NickHuang0228/T113-DEV-V1/docs/concepts/README.md

# 核心概念

> 這塊板的設計文件有 6,000 多行，但**真正要內化的概念只有 8 條**。
>
> 其餘都是查證結果（「PC4/PC5 是 BOOT-SEL」「ADV7511 沒有 EPAD」），
> 那些不用記，畫到那裡再翻文件就好。
>
> 這個目錄裝的是要帶走的那 8 條。

---

## 進度

| | 概念 | 狀態 | 一句話 |
|---|---|---|---|
| ① | [回流路徑](01-return-path.md) | ✅ 已懂 | 每條訊號線正下方都要有連續的銅讓電流回家 |
| ② | [阻抗控制](02-impedance.md) | ✅ 已懂 | 阻抗由線寬決定，線寬由板廠給，不連續就反射 |
| ③ | [臨界長度與等長](03-critical-length.md) | ✅ 已懂 | 看上升時間決定要不要小心；等長控的是時間，長度只是代理 |
| ④ | [差分訊號為什麼成對](04-differential.md) | ✅ 已懂 | 靠得近只看差值換來抗雜訊能力，這能力被拿去支撐小擺幅，小擺幅才跑得快 |
| ⑤ | [mux 衝突與 0Ω 隔離](05-pin-mux.md) | ✅ 已懂 | 軟體改得了「這支腳歸誰管」，改不掉「線還連著誰」 |
| ⑥ | [bank 為什麼會連坐](06-io-bank.md) | ✅ 已懂 | bank 邊界是 die 上的物理邊界；風險分配只有 pin map 階段是免費的 |
| ⑦ | [上電時序](07-power-sequence.md) | ✅ 已懂 | 別在電源域還沒準備好時送訊號進去；後果多半是開不了機而非燒毀 |
| ⑧ | [去耦電容在做什麼](08-decoupling.md) | ✅ 已懂 | 本地電荷水庫；位置比容值重要，回流路徑跟供電路徑一樣重要 |

---

## 八條怎麼串起來

不是八個獨立主題，是兩條主線加一組系統規則：

```
【電磁主線】訊號在銅線上會發生什麼
  ① 回流路徑      電流要回家 —— 一切的根基
  ② 阻抗控制      同一個結構，訊號感受到多大阻力
  ③ 臨界長度      什麼時候需要在意 ①②
  ④ 差分          為什麼高速一律成對

【電源主線】電要怎麼送到晶片
  ⑦ 上電時序      電源之間的先後
  ⑧ 去耦電容      ★ 又回到 ① —— 供電也是一個電流迴路

【系統規則】晶片的腳怎麼分配
  ⑤ mux 衝突      軟體改不掉「線還連著誰」
  ⑥ bank 連坐     災損邊界是物理邊界
```

**① 出現三次**：訊號的回流、差分的共模回流、去耦的供電迴路。
如果只能記一條，記它。

**⑤⑥ 共用一個時機**：兩者都只有在 **pin map 階段**改動才免費。

---

## 讀法

一次一條，讀完能用自己的話講出那條「一句話」就算過。

**不用一口氣讀完。** 這 8 條會在畫原理圖和 layout 時反覆用到，
遇到不確定的地方回來翻，比一次背完有效。

---

## 這些概念為什麼重要

它們是「判斷方法」，不是「查證結果」：

```
查證結果   換一顆晶片就作廢
判斷方法   換十顆晶片都還在用
```

這塊板的目的是累積 layout 能力，而能力就長在這 8 條上面。
把它們搞懂，下一塊板（DP 探測板、SSD2832 板）可以直接沿用。
