NickHuang0228/T113-DEV-V1/docs/design/011-power-tree.md

# 011 · 電源樹定案

版本：v0.2 · 2026-09-26（AVCC/HPVCC 改由 LDOA 供電；§8 待辦結案）

本文件把 [001-power.md](001-power.md) 的分析收斂成**可以直接畫原理圖的數字**：
每條軌的來源、元件料號、分壓值、時序電路、去耦。

---

## 1. 電源樹

```
Type-C VBUS  +5V_VBUS
  │
  ├─ RY1303 CH3 ──▶ +3V3        VCC-IO · VCC-PD · VCC-PE · VCC-PG · VCC-TVOUT
  │                              LDO-IN · RTL8201F · CH340N · ADV7511 MVDD
  │                              兩顆 1.8V LDO 的輸入 · 上拉與 LED
  │
  ├─ RY1303 CH2 ──▶ +1V5        VCC-DRAM0/1
  │
  ├─ RY1303 CH1 ──▶ +0V9        VDD-CORE0/1 · VDD-SYS0/1/2
  │
  ├─ +3V3 ─[LDO1]─▶ +1V8_SOC    VCC-PLL · VCC-RTC · VCC-LVDS · VCC-TVIN
  │                              VDD18-DRAM
  │
  ├─ +3V3 ─[T113 內建 LDOA]─▶ +1V8_AUDIO   AVCC · HPVCC（v0.2，見 §3.1）
  │
  ├─ +3V3 ─[LDO2]─▶ +1V8_HDMI   ADV7511 專屬，再分 3 組（見 §5）
  │                    ├─[10µH+10µF]─▶ +1V8_DVDD    pin 1,19,49,76,77
  │                    ├─[10µH+10µF]─▶ +1V8_AVDD    pin 29,34,41 + 24,25
  │                    └─[10µH+10µF]─▶ +1V8_PLVDD   pin 21 + 26
  │
  └─ +5V_VBUS ─[TPS2051B]─▶ +5V_USB   USB-A Host（限流）
```

### 1.1 Net 命名

```
+5V_VBUS · +5V_USB · +5V_HDMI
+3V3
+1V8_SOC · +1V8_AUDIO · +1V8_HDMI · +1V8_DVDD · +1V8_AVDD · +1V8_PLVDD
+1V5 · +0V9
GND
```

⚠ **+5V_HDMI 是 HDMI 座上的 +5V（DDC 上拉用），與 +5V_VBUS 分開命名** ——
它接到外部螢幕，要獨立看待。

⚠ **+1V8_AUDIO 不叫 +1V8_AVCC** —— 和 ADV7511 的 +1V8_AVDD 只差一個字母，畫圖時太容易接錯。

---

## 2. RY1303 三路 DC-DC

`(RY1303 Datasheet **V1.9**，2026-09-30 對原文重核)`

⚠ **本節數字已全面改依 V1.9。** 原本標註的來源是 V1.0.x，多處與 V1.9 不同
（切換頻率、EN 閾值、UVLO、限流、θJA、FB 容差）。**若手上的 PDF 是舊版，以 V1.9 為準。**

```
LCSC C370881 · QFN20-3×3 · 庫存 23,969 · $0.20
Vin          2.7 ~ 5.5 V     ⚠ Feature 頁寫 2.7，Electrical Char. 與訂購資訊寫 2.5；取保守值
VCC (pin16)  2.5 ~ 5.5 V     ★ 內部控制電路電源，不是 NC
每通道電流    0 ~ 2 A
⚠ 三通道總輸出功率必須 < 6 W
FB 電壓      0.588 / 0.600 / 0.612 V   (±2%)      ← 原寫 ±2.5%
切換頻率      1 / 1.5 / 2 MHz  (min/typ/max)      ← 原寫「1.2 MHz 固定」
EN 閾值      VEN-H min 2 V / VEN-L max 0.4 V     ← 原寫 1.2 V / 0.6 V
UVLO         1.9 / 2.3 / 2.5 V (VIN rising)，遲滯 0.3 V
上管電流限制   ILIM-P min 3.5 A / typ 5 A          ← 原寫 3 A
熱關斷        165 °C typ，遲滯 30 °C
θJA          50 °C/W    θJC 7.5 °C/W   PDmax@25°C 2.5 W   ← 原寫 43.7
Tj max       150 °C
pin 21       EP，"must be soldered to a large PCB copper plane and connected to GND"
```

### 2.1 ⚠ 更正 001-power.md 的一個錯誤

001-power.md §2.3 的比較表寫 RY1303 的優點是「**EN1/EN2/EN3 內建順序**」。

**錯的。** datasheet 寫的是：

```
"the independent enable control makes the designer have the greatest flexibility
 to optimize timing for power sequencing purposes"
```

**EN 是三支獨立輸入，沒有任何內建順序。** 時序要自己做（見 §4）。

> 這條錯誤的來源是把「有三支 EN 腳」當成「有排序功能」。
> **零件的彈性不等於零件幫你做事。**

### 2.2 腳位

```
1  GND3     2  FB3      3  FB2      4  GNDA     5  GNDB
6  SW2      7  VIN2     8  EN2      9  EN1     10  VIN1
11 SW1     12  GND1A   13  GND1B   14  FB1     15  AGNDA
16 VCC       17  AGNDB   18  EN3     19  VIN3    20  SW3
21 EP（GND）
```

⚠ **EN 腳不可浮接**（datasheet 明寫 "Don't leave this pin floating"）。

⚠ **pin 16 是 VCC 不是 NC**（2026-09-30 對 DS V1.9 原文重核時發現）。

```
16  VCC   "Input supply pin for internal control circuit."   2.5 ~ 5.5 V
```

**內部控制電路的電源，必須接 +5V_VBUS。** 懸空 = 控制電路沒電 = 整顆 IC 不工作。
p.3 Absolute Max 也把 `V_VCC` 與三個 `V_VIN` 並列為輸入電源，印證它是電源腳。

`gen_power_symbols.py` 原本標成 `NC / no_connect`，已於同日更正並重生符號。
另 pin 4/5 原文是 `GND2A / GND2B`（符號裡寫 GNDA/GNDB，功能相同）。

### 2.3 分壓電阻（用公式算，不抄）

```
V_out = 0.6 × (1 + R_top / R_bot)      R_bot 統一用 51.0 K 1%
```

| 軌 | R_top | R_bot | 算出 V_out | 晶片容許範圍 | |
|---|---|---|---|---|---|
| **+3V3** | **232 K** | 51.0 K | 0.6×(1+4.5490) = **3.329 V** | VCC-IO 2.97 ~ 3.63 | ✓ |
| **+1V5** | **76.8 K** | 51.0 K | 0.6×(1+1.5059) = **1.504 V** | VCC-DRAM 1.425 ~ 1.575 | ✓ |
| **+0V9** | **25.5 K** | 51.0 K | 0.6×(1+0.5000) = **0.900 V** | VDD-CORE TBD（標稱 0.9） | ✓ |

三個 R_top 都是 **E96 1%** 的現成值（232K / 76.8K / 25.5K）。

#### 含容差的最壞情況

FB 本身 **±2%**（V1.9：0.588 / 0.600 / 0.612），加上電阻 1%，合計約 ±3%：

```
+3V3   3.23 ~ 3.43 V     VCC-IO 2.97~3.63       ✓ 兩側都有餘裕
+1V5   1.459 ~ 1.549 V   VCC-DRAM 1.425~1.575   ✓ 餘裕 26 mV，仍是最緊的一條
+0V9   0.873 ~ 0.927 V   標稱 0.9（DS 未給 min/max）
```

⚠ 2026-09-30 更正：原本用 FB ±2.5% 算得合計 ±3.5%。V1.9 的 VREF 是 ±2%，
**合計降到 ±3%，三條軌的餘裕都變大**（+1V5 從 ~25 mV 邊界變成兩側各 26/34 mV）。

⚠ **+1V5 仍是三條裡容差最緊的** —— DDR3 的 ±5% 大半被 FB 容差吃掉。
bring-up 時這條要優先量。

```
[ ] 若量到偏離超過 2%，考慮把 R_bot 改 0.5% 或微調 R_top
```

### 2.4 電感與電容

照 datasheet 典型應用電路：

```
CH3 (+3V3)   L = 2.2 µH      C_out = 22 µF
CH2 (+1V5)   L = 1.5 µH      C_out = 22 µF
CH1 (+0V9)   L = 1.0 µH      C_out = 22 µF
每個 VIN     C_in = 10 µF MLCC，緊貼該通道的 VIN 腳
```

⚠ **DC bias**：22 µF X7R 0805 在 3.3V 偏壓下實際約 17.6 µF（掉 20%）。
1.5V / 0.9V 軌偏壓低，衰減較小。**選料時要看 DC bias 曲線，不能只看標稱值。**

#### 電感選型（2026-09-26 定案）

漣波 ΔI = V_out × (1 − V_out/V_in) / (L × f)，取 V_in = 5.25 V（最壞）、**f = 1 MHz（最壞）**：

⚠ 2026-09-30 更正：原本用 f = 1.2 MHz，但 DS V1.9 Electrical Characteristics 給的是
`FSW min 1 MHz / typ 1.5 MHz / max 2 MHz`。**f 在分母，最壞情況要取 min。**
下表已改用 1 MHz 重算（括號內為原本 1.2 MHz 的值）。

| 通道 | L | ΔI | 峰值 @估計負載 | 峰值 @2 A 滿載 |
|---|---|---|---|---|
| +3V3 | 2.2 µH | **0.55 A**（原 0.46） | 1.05 A | 2.23 A |
| +1V5 | 1.5 µH | **0.72 A**（原 0.60） | 0.60 A | 2.30 A |
| +0V9 | 1.0 µH | **0.74 A**（原 0.62） | 1.31 A | 2.31 A |

ΔI 為滿載的 28~37%（原估 23~31%）。略高於教科書建議的 30% 上限，但仍可接受 ——
而且這是 f 取 min 的最壞值，典型 1.5 MHz 下只有 0.37~0.49 A（19~25%）。

**Isat 直接照 RY1303 的上管限流選，不照負載選**
（⚠ 2026-09-30 更正：限流規格是 `ILIM-P min 3.5 A / typ 5 A`，原文寫 3 A 有誤。
所選的 6.0~8.7 A 對 5 A typ 仍有餘裕，選型不變。） —— 短路或過載時電流會頂到限流點，
電感若先飽和，電流上升斜率暴增，限流比較器來不及反應。4×4 一體成型電感做得到，每顆只貴約 1 美分。

| 軌 | LCSC | 型號 | 尺寸 | Isat（−30% L） | DCR max | 庫存（09-26） |
|---|---|---|---|---|---|---|
| +0V9 | `C602028` | cjiang FHD4020S-1R0MT | 4×4×2.0 | 8.7 A | 28 mΩ | 10,398 |
| +1V5 | `C843298` | cjiang FHD4020S-1R5MT | 4×4×2.0 | 7.7 A | 38 mΩ | ⚠ 2,895 |
| +3V3 | `C602029` | cjiang FHD4020S-2R2MT | 4×4×2.0 | 6.0 A | 56 mΩ | 117,751 |

同一系列、同一個 footprint，皆 Extended（找不到 Basic 的功率電感），單價約 $0.07。
數值已對原廠 datasheet；庫存與價格為 JLCPCB 2026-09-26 查詢值。

```
⚠ 1.5 µH 庫存偏少。備案：
   (a) 改用 1.0 µH C602028 —— ΔI 升到約 0.9 A，仍可接受
   (b) Sunlord WPN4020H1R5MT C98360 —— 數字只看過 JLCPCB 頁面，未對 datasheet
參考：MangoPi 三路全用 2.2 µH。
```

#### 輸出電容

```
22 µF  C45783  Samsung CL21A226MAQNNNE  0805 25V X5R  Basic
⚠ 原廠 spec 沒附 DC-bias 曲線。依同級 0805 X5R 估，3.3 V 下剩約 11~13 µF（−40~50%）
   → +3V3 放兩顆 22 µF；+1V5 / +0V9 各一顆
⚠ 輸出電容不要無限堆 —— 太大時軟啟動 1 ms 內可能充不到設定值
```

### 2.5 ⚠ 6 W 總功率上限的帳

```
+3V3   約 0.82 A × 3.3 V = 2.71 W    ← 最壞情況（GPIO 全速翻轉）
+1V5   估 0.30 A × 1.5 V = 0.45 W    ⚠ VCC-DRAM 電流 datasheet 是 TBD
+0V9   估 1.00 A × 0.9 V = 0.90 W    ⚠ VDD-CORE 電流 datasheet 是 TBD
                          ─────────
                          約 4.06 W   < 6 W  ✓
```

**餘裕約 32%，但兩項是估值。** 實際 GPIO 不會同時全速翻轉，真實值會低不少。

**TBD 兩項的旁證**（DS Table 5-3 p.47 原頁確認仍是 TBD，沒有更新版數字）：
Forlinx T113-i 核心板（外接 512 MB DDR3 + 8 GB eMMC）在 Linux 下
**CPU + 記憶體 + eMMC 壓力測試，整片核心板 5 V 輸入端 1.05 W**。
本表 +0V9 與 +1V5 合計估 1.35 W（輸出端），已高於該實測整板值 → **估值偏保守，6 W 帳成立**。
`(forlinx.net/industrial-news/allwinner-t113-som-performance-528.html)`

```
[ ] bring-up 時量三軌實際電流，回填本表
```

---

## 3. 兩顆 1.8V LDO

| | LDO1（SoC 側） | LDO2（ADV7511 專屬） |
|---|---|---|
| 料號 | **AP2112K-1.8TRG1** | **AP2112K-1.8TRG1** |
| LCSC | `C176944` | `C176944` |
| 封裝 | SOT-25 | SOT-25 |
| 輸入 | +3V3 | +3V3 |
| 輸出 | +1V8_SOC | +1V8_HDMI |
| 負載 | 約 52 mA + TBD（AVCC/HPVCC 已移出） | 約 180 mA |
| 壓降功耗 | (3.3−1.8)×0.10 ≈ 0.15 W → ΔT ≈ 28°C | (3.3−1.8)×0.18 ≈ 0.27 W → ΔT ≈ 50°C |

**兩顆用同一個料號** —— 省一個 BOM 品項，且 600 mA 對兩邊都有餘裕。

`(AP2112 Datasheet DS39724 Rev.2-2, June 2017, p.2 / p.3 / p.5)`

```
C_in / C_out   1 µF 陶瓷，X5R 或 X7R（Note 4）          ← 原本的慣例值，確認正確
精度           ±1.5%（25°C, 1~30 mA）+ 溫漂 ±100 ppm/°C
壓降           700 mV max（1.8V 版）→ 3.21 V 輸入仍有 1.4 V 餘裕
θJA            184 °C/W（SOT-25）                        ← 原本估 250，偏保守
EN             內建 3 MΩ 下拉，VIH 1.5~6.0 V → 直接接 VIN
啟動時間        20 µs（無負載）
PSRR           65 dB @100 Hz / 1 kHz，高頻沒給 → §5 的 LC 不能省
```

⚠ **±1.5% 不夠 AVCC / HPVCC 用** —— Table 5-2 要求 1.782~1.818 V（±1%）。這是 v0.2 改架構的原因，見 §3.1。

⚠ **為什麼不共用一顆**：ADI §6.8 要求 ADV7511 有自己專屬的 1.8V LDO。
理由是 Figure 24 —— AVDD/PLVDD 在 200 kHz~1 MHz 只容許 1.3 mV rms，
共用的話 SoC 側的負載跳變會打進這個頻段。詳見 001-power.md §1.2。

### 3.1 內建 LDOA 專供音訊類比；LDOB 不使用（v0.2 改）

```
pin 29  LDO-IN     ← +3V3，2.2 µF 到地
pin 28  LDOA-OUT   → +1V8_AUDIO，2.2 µF 到地      ★ v0.2：只接 AVCC · HPVCC
pin 30  LDOB-OUT   → 2.2 µF 到地，不接任何電源軌
```

**v0.1 的做法**：LDOA 不用，1.8V 全部由外部 LDO1 供。

**為什麼改**：原頁目視核對 Table 5-2（DS p.45~46）時發現

```
AVCC       1.782 / 1.8 / 1.818 V     ±1%
HPVCC      1.782 / 1.8 / 1.818 V     ±1%
LDOA-OUT   1.782 / 1.8 / 1.818 V     ← 範圍一模一樣
```

AP2112K 初始精度 ±1.5% 再加溫漂，**保證不了 ±1%**。而 LDOA-OUT 的規格範圍與 AVCC 完全相同 ——
原廠的意圖就是 LDOA 供 AVCC。

**v0.1 當初不用 LDOA 的兩個理由，對這個接法都不成立：**

| v0.1 的顧慮 | 現在 |
|---|---|
| 兩個穩壓器並聯打架 | LDOA 只驅動 +1V8_AUDIO 一條 net，與 +1V8_SOC 完全分開，沒有並聯 |
| LDOA 只有 260 mA，負載有 TBD 項 | 只剩 AVCC + HPVCC；本板音訊只做 line-out，負載遠低於 260 mA |

**附帶好處**：數位 1.8V（PLL、DRAM 控制器）的雜訊不會進音訊類比。
MangoPi 用一顆獨立的 XC6206（±2%）做同一件事；我們用內建 LDOA，零元件、精度還更好。

```
⚠ +1V8_AUDIO 與 +1V8_SOC 絕對不可相連 —— 連了就回到兩顆並聯的問題
   v0.1 那顆「LDOA-OUT ↔ +1V8_SOC 的 DNP 0Ω」取消
⚠ VCC-TVIN 維持在 +1V8_SOC（本板不用 CVBS 輸入，精度要求 TBD）
```

---

## 4. 上電時序電路

### 4.1 datasheet 的實際要求（文字，不是圖）

`(DS §5.12.1, p.73)`

```
• 下一步要等前一步穩定在標稱值的 90~110% 才開始
• VCC-RTC must be ramped no later than other power rails
• VCC-IO must be ramped before VDD-SYS and VDD-CORE with a minimum delay of 2 ms
• VCC-DRAM needs be stable before SDRAM driver initialization
• RESET 全程拉低，直到所有電源軌（24MHz 除外）穩定超過 64 ms
• 24 MHz 在 RESET 釋放後才開始振盪
```

⚠ **文字比 Figure 5-28 寬鬆。** 圖上 VCC-DRAM 畫在第一群組（T1 之前），
但文字只要求它「在 SDRAM driver 初始化前穩定」——**那是軟體層，不是硬體順序約束。**

**只看圖會多綁一條不存在的限制。** 圖是 example，文字才是 requirement。

### 4.2 實作

```
EN3 (+3V3) ──┬── +5V_VBUS      直接接，靠 RY1303 自己的 UVLO(2.5V) 把關
EN2 (+1V5) ──┘                  與 3.3V 同時啟動（無硬體順序要求）

EN1 (+0V9) ──[47 K]── +3V3
                 │
               [220 nF]
                 │
                GND
```

延遲驗算：

```
τ = 47 K × 220 nF = 10.34 ms
EN 上升閾值 2 V（VEN-H min），從 3.3 V 充電：
t = −τ × ln(1 − 2/3.3) = −10.34 × ln(0.3939) = 9.63 ms

T1 = 9.63 ms  >  2 ms  ✓  餘裕 4.8 倍

⚠ 2026-09-30 更正：原本用 1.2 V 算得 4.67 ms。
DS V1.9 Electrical Characteristics 給的是 `VEN-H min 2 V / VEN-L max 0.4 V`，沒有 1.2 V 這個值。
改用正確的 2 V 後延遲更長，**對 T1 只有好處，結論不變**。
```

⚠ EN 閾值 datasheet 只給 `VEN-H min 2 V`，沒給 max。**閾值若更高，延遲只會更長**，
對 T1 只有好處。但要確認 EN 的漏電流不會讓 47K 上拉的終值掉下來。

**EN 漏電流：datasheet 確實未列**（Electrical Characteristics 只有 shutdown 電流 <1 µA）。
改用最壞情況反推，結論是 **47 K 不需要改**：

```
若 EN 內部有下拉 R_pd，EN 終值 = 3.3 × R_pd / (R_pd + 47K)
  要 > 2 V  →  R_pd > 72.3 kΩ（同類晶片多為 MΩ 級）
  例：R_pd = 100 kΩ → 終值 2.24 V（> 2 V，仍能觸發但餘裕小）
⚠ 同類晶片的 EN 下拉多為 MΩ 級，1 MΩ 時終值 3.15 V，無虞；
   但這是唯一與 47K 有關的風險點，bring-up 時量一次 EN1 的穩態電壓
若是往外推的漏電流：µA 級，對 47K 上拉的 ~70 µA 可忽略
EN2 / EN3 直接接 +5V_VBUS：EN 絕對最大值 6 V（"All Other Pins"），OK
```

### 4.3 RESET —— 用 supervisor，不用 RC

```
APX803-29SAG-7    LCSC C460551 ($0.25, 庫存 835)
  閾值      2.93 V（監測 +3V3）
  延遲      200 ms typ        ★ 遠超 64 ms 要求
  輸出      open-drain，低有效
  封裝      SOT-23 三腳，無需外部元件
  消耗      30 µA typ
```

接法：

```
+3V3 ──▶ APX803 VCC
         APX803 GND ── GND
         APX803 RESET# ──┬──▶ T113 pin 27 RESET
                         │
                      [10 K]
                         │
                    +1V8_SOC        ★ 上拉到 1.8V，不是 3.3V
```

⚠ **上拉必須接 +1V8_SOC** —— T113 的 RESET 是 1.8V 域輸入
（MangoPi 原理圖 R74 10K 上拉到 LDOA-OUT = 1.8V，可佐證）。
APX803 是 open-drain，只負責拉低，高電位由上拉電阻決定，**所以電平相容沒問題**。

時序驗算：

```
t=0       VBUS 有效，EN3/EN2 拉高
t≈1 ms    +3V3 與 +1V5 到位（軟啟動 1 ms）
t≈9.6 ms  EN1 越過 2 V      ← 2026-09-30 更正（原用 1.2 V 算得 4.7 ms）
t≈10.6 ms +0V9 到位  ← 最後一條軌
t≈201 ms  APX803 釋放 RESET（從 +3V3 越過 2.93V 起算 200 ms）

T2 = 201 − 10.6 ≈ 190 ms  >  64 ms  ✓  餘裕仍近 3 倍
```

### 4.4 ⚠ 為什麼不照抄 MangoPi

MangoPi 的 RESET 只有 **R74 10K 上拉 LDOA-OUT + C84 0.1 µF 到地**（原理圖 p.3 已目視確認）。

```
RC = 10 K × 0.1 µF = 1 ms
要從 0 充到 T113 的 RESET 高電位閾值，大約 1~2 ms
```

**T2 要求 64 ms，MangoPi 給了約 1 ms —— 差了 60 倍。**

001-power.md §3.4 當時的推測（「靠 soft-start 湊出來，或根本沒滿足但恰好能開機」）
現在有了確切數字佐證：**它確實沒滿足規格。**

```
→ 不照抄。多一顆 $0.25 的 supervisor，把 64 ms 變成確定的事。
```

### 4.5 ⚠ 一個沒有完美解的取捨：VCC-RTC 的順序

規格寫 **"VCC-RTC must be ramped no later than other power rails"**。

但我們的 +1V8_SOC 是從 +3V3 經 LDO 產生的，**所以 VCC-RTC 必然晚於 VCC-IO**
（AP2112K 啟動時間 20 µs typ，且 EN 直接接 VIN，輸出基本上跟著 +3V3 爬升 —— 落差是 µs 級，不是當初估的數百 µs）。

考慮過的替代方案：

| 方案 | 問題 |
|---|---|
| 1.8V LDO 改吃 +5V_VBUS | (5−1.8)×0.18 = 0.58 W 在 SOT-25 裡，θJA 約 250°C/W → ΔT 145°C，**太燙** |
| 用 RY1303 第四通道 | 沒有第四通道，三路已用完 |
| 加第四顆 DC-DC | 為了數百 µs 的順序多一顆 IC，不划算 |

**採用：接受這個落差。**

依據：**MangoPi 也是這樣接的** —— 它的 VCC-RTC 來自 LDOA-OUT，
而 LDOA 的輸入 LDO-IN 是 +3V3。所以 MangoPi 的 VCC-RTC 同樣晚於 VCC-IO，**而它能開機。**

```
[ ] bring-up 時用示波器抓 +3V3 與 +1V8_SOC 的上升沿，量實際落差
[ ] 若懷疑與開機失敗有關，可暫時把 +1V8_SOC 改由外部電源先供，排除這個變因
```

**這一條記在這裡，是為了萬一開不了機時，記得它是個嫌疑犯。**

---

## 5. ADV7511 的三組 1.8V

`(ADV7511 HW User's Guide §6.8 Figure 23, p.50 / §7.1, p.52)`

```
+1V8_HDMI ──┬──[10 µH]──┬──▶ +1V8_DVDD    pin 1, 19, 49, 76, 77
            │           └─[10 µF]─ GND
            │
            ├──[10 µH]──┬──▶ +1V8_AVDD    pin 29, 34, 41（AVDD）
            │           │                  pin 24, 25（PVDD）
            │           └─[10 µF]─ GND
            │
            └──[10 µH]──┬──▶ +1V8_PLVDD   pin 21（PLVDD）
                        │                  pin 26（BGVDD）
                        └─[10 µF]─ GND

每一支電源腳再加 0.1 µF 到 GND plane，貼近腳位（相鄰腳可共用）
ADV7511 的 11 支 GND 各自用 via 下 GND plane
```

⚠ **10 µH 電感體積不小**，三顆要在 placement 階段就留位置。

⚠ RY1303 切換頻率 **1.2 MHz**，正好落在 ADV7511 AVDD/PLVDD 雜訊上限最嚴的頻段
（200 kHz~1 MHz 只容許 1.3 mV rms，1 MHz 約 1.7 mV）。
**這就是「LDO 之後還要加 LC」不能省的原因** —— LDO 對 1.2 MHz 的 PSRR 已經不高。

---

## 6. 其他電源相關的必要元件

### 6.1 T113-S3

```
DZQ (pin 47)      240 Ω 1% 接地     ★ DDR ZQ 校準，MangoPi R42 已佐證
LDOA-OUT (28)     2.2 µF 到地，輸出 +1V8_AUDIO → AVCC (89) · HPVCC (97)
LDO-IN (29)       2.2 µF 到地，接 +3V3
LDOB-OUT (30)     2.2 µF 到地
VCC-RTC (26)      ← +1V8_SOC（MangoPi 用 0Ω 從 LDOA-OUT 接，我們直接接）
RESET (27)        ← APX803 + 10K 上拉到 +1V8_SOC
EPAD (129)        ★ 唯一的數位地，thermal via 陣列 + plugged
```

### 6.2 ADV7511

```
R_EXT (pin 28)    887 Ω ±1% 接地    ★ 走線短，LRCLK 與 via 不可靠近
MVDD (pin 47)     ← +3V3
```

### 6.3 USB-A Host 限流

```
TPS2051BDBVR   LCSC C24593 ($0.21, 庫存 38,715)   SOT-23-5
  pin 5 IN   ← +5V_VBUS
  pin 1 OUT  → +5V_USB
  pin 4 EN   ← ⟨USB_EN⟩    高有效（TPS2051B 不是 2041B），全域標籤，腳位待主晶片頁定
  pin 3 OC#  → ⟨USB_OC_N⟩  open-drain，10K 上拉到 +3V3
  pin 2 GND  ← GND
```

**過流時只斷 Host，不影響主板** —— 這是 001-power.md §5.2 就定下的策略。
所以 `+5V_VBUS` 與 `+5V_USB` 必須是**兩條不同的 net**，中間隔著這顆開關；
同名等於把開關短路掉。

#### 輸出側電容（2026-09-30 定案）

```
C14  220 µF  SMD 電解   +5V_USB → GND    bulk
C15  0.1 µF  0603       +5V_USB → GND    高頻
```

**USB 2.0 §7.2.4.1 要求 downstream port 的 bulk capacitance ≥ 120 µF** ——
最壞情況是一個滿載 500 mA 的裝置突然插入，bulk 要撐住 VBUS 不掉出規格。

```
120 µF   規範最低
220 µF   最接近的標準值，超過規範    ← 採用
100 µF   標準值但略低於規範
 47 µF   很多開發板的實際做法，對 dongle/鍵鼠夠用但不合規
```

選 220 µF 的理由：**合規、好買、便宜**，與 47 µF 的價差不到幾分錢。

⚠ **並聯 0.1 µF 的理由**：電解電容 ESL 高，高頻時已不像電容（概念 ⑧ 的 SRF）。
220 µF 管裝置插入瞬間的大電流下陷，0.1 µF 管裝置本身的開關雜訊。

⚠ **這是全板唯一的電解電容，也是 0603 統一規則的唯一例外**（見 012 §4.1）。
220 µF 在 0603 做不到（MLCC 0603 最大約 22 µF），必須用 SMD 電解
（典型 6.3×6.3 mm，耐壓 ≥10 V）。替代方案是 100 µF 鉭質 D case，較薄但貴 3~5 倍。

#### 輸入側

```
[ ] 補一顆 0.1 µF 貼著 pin 5（+5V_VBUS → GND）
```

⚠ `+5V_VBUS` 上雖已有 C2/C3/C4（10 µF），但那是 RY1303 的輸入電容、
layout 時會擺在 RY1303 旁邊，**離 U5 很遠** —— 概念 ⑧：位置比容值重要。

---

## 7. 去耦總表

| 位置 | 電容 |
|---|---|
| RY1303 每個 VIN | 10 µF MLCC，緊貼腳位 |
| RY1303 每個輸出 | 22 µF（⚠ 看 DC bias） |
| 兩顆 LDO 輸入/輸出 | 1 µF / 1 µF X5R/X7R（AP2112 DS Note 4 已確認） |
| T113 每支電源腳 | 0.1 µF 0402，緊貼 |
| T113 每組電源軌 | 10 µF 0805，靠近進入點 |
| ADV7511 每支電源腳 | 0.1 µF，相鄰可共用 |
| ADV7511 三組 1.8V | 各 10 µH + 10 µF |
| 整板輸入端 | 100 µF 電解或鉭質 |
| PLL / 類比軌 | 磁珠或串聯電阻隔離 + 0.1 µF + 10 µF |

---

## 8. 待辦

```
[x] RY1303 規格與腳位 —— datasheet 已取得
[x] 分壓電阻值 —— 232K / 76.8K / 25.5K，R_bot 統一 51K，全為 E96 1%
[x] 上電時序電路 —— EN1 用 47K + 220nF（T1 = 4.67 ms）
[x] RESET —— APX803-29SAG-7，200 ms 延遲，上拉到 +1V8_SOC
[x] VDD18-DRAM 的來源 —— MangoPi 接 LDOA-OUT；本板接 +1V8_SOC
[x] DZQ 240 Ω 1%
[x] RY1303 的 EN 漏電流 —— DS 未列；反推 R_pd > 27 kΩ 即安全，47K 不改（§4.2）
[x] 三顆電感選型 —— cjiang FHD4020S 系列，Isat 照 3 A 限流選（§2.4）
[x] AP2112K 輸入/輸出電容 —— 1 µF X5R/X7R，DS Note 4 確認（§3）
[x] VCC-DRAM / VDD-CORE 電流 —— DS 仍 TBD；Forlinx 實測旁證估值保守（§2.5）
[x] Table 5-2 / 5-3 原頁目視核對 —— 數字無誤；抓到 AVCC ±1% → 改由 LDOA 供（§3.1）
[x] U1 pin 16 —— 不是 NC 是 VCC，必須接 +5V_VBUS（2026-09-30 對 DS V1.9 重核）
[ ] 原理圖把 U1.16 (VCC) 接到 +5V_VBUS，並加一顆去耦電容
[ ] +1V5 電感庫存只有 2,895 —— 下單前再查一次，不足就走 §2.4 備案
[ ] bring-up 量三軌實際電流，回填 §2.5
[ ] ★ 電感 footprint 對帳 —— 現用 KiCad 內建 L_Changjiang_FNR4020S，
    但 BOM 選的是 FHD4020S（同廠不同系列）。兩者外形都是 4×4×2.0，
    但焊盤尺寸未必相同 → 開 .kicad_mod 看 pad，對照 FHD4020S datasheet
    的推薦焊盤圖；不合就複製一份改，放 hardware/footprints/T113-DEV-V1.pretty
    （與 T113 EPAD 同一套流程：標準件先找，對不上才自建）
[ ] power.kicad_sch 還有一顆 power:+3.3V 未換成 +3V3（§1.1 命名規定）
    ⚠ 這種漏一顆最危險 —— ERC 只會提示「net 只有一個連接點」，容易被忽略
[ ] 被動件 footprint 統一 0603（006-assembly.md 的手焊決定）
    Capacitor_SMD:C_0603_1608Metric / Resistor_SMD:R_0603_1608Metric
```
