NickHuang0228/T113-DEV-V1/docs/design/009-bom.md

# 009 · BOM 料況查證

版本：v0.3 · 2026-09-20（ADV7511 原廠規格已取得:**無 EPAD**、五個 1.8V 域）

**資料來源**：JLCPCB / LCSC 零件庫即時查詢（2026-09-20）。
價格為**單顆 qty 1 美金未稅**，庫存為當日數字 —— **下單前必須重查**。

> 查詢方式：JLCPCB 的零件搜尋 API（`selectSmtComponentList`）。
> LCSC 與 JLCPCB 的網頁版都需要 JavaScript，`WebFetch` 抓不到表格，
> 但這支 API 回傳 JSON,含 `componentCode` / `stockCount` / `componentPrices` /
> `minPurchaseNum` / `noBuyReason`。校準：T113-S3 回傳 $22.2509,
> LCSC 網頁 qty1 顯示 $22.443 —— **兩者一致,API 數字可信**。

---

## 0. ✅ 決議（2026-09-20）

```
HDMI 橋接   IT66121FN（停產）  →  ADV7511KSTZ  C179459  $13.75  庫存 57
PCBA 片數   3 片  →  2 片（T113-S3 實價 $22.25，不是估的 $8）
電源域      5 組  →  4 組（1.2V 取消；1.8V 改 600mA 外部 LDO）
1.8V LDO    XC6206（200mA）  →  AP2112K-1.8TRG1  C176944（600mA）
```

**選 ADV7511 的判準不是成本，是 driver 練習價值** ——
目標是累積 HDMI/DP kernel driver porting 與 IC 驗證經驗，
詳見 [002-display.md](002-display.md) §3.1 與 §6。

⚠ **仍有兩項阻塞 layout 的待辦**（ADI 官網 PDF 擋 curl 與 WebFetch，實測 HTTP 000）：

```
[x] ADV7511 封裝機構圖 → **ST-100 / MS-026-BED，無 EPAD**，008-footprint.md §4A
[x] ADV7511 Video Input AC Timing → tVSU 1.0ns / tVHLD 0.7ns，skew budget 已重算
[ ] 原始 PDF 檔本身仍未存檔（ADI 封鎖自動下載，六條路全失敗）
     數字見 [../reference/peripherals/ADV7511KSTZ_extracted.md](../reference/peripherals/ADV7511KSTZ_extracted.md)
```

⚠ **v0.3 的更正**：先前寫 ADV7511「含 EPAD」是錯的 —— 那是 **ADV7511W**（64 腳 LQFP_EP）
的資料。KSTZ 是 100 腳純 LQFP，**沒有 EPAD，可手焊**。

---

## 1. ⚠ 起因：IT66121 停產

```
IT66121FN   C2684803   庫存 0   "This product is no longer manufactured."
```

這不是暫時缺貨，是**原廠停產**。而 002-display.md 選它的唯一理由是
「mainline 就有 driver，第一塊板不在 driver 上冒險」。

**替代方案的完整盤點見 §3。這是目前唯一的阻塞項。**

---

## 2. 已查證的料況

### 2.1 主動元件

| 用途 | 料號 | LCSC | 封裝 | 庫存 | 單價 | 狀態 |
|---|---|---|---|---|---|---|
| **主晶片** | T113-S3 | `C5197687` | ELQFP-128 | 3,031 | **$22.25** | ✅ |
| **HDMI 橋接** | IT66121FN | `C2684803` | QFN-64-EP 9×9 | **0** | — | ❌ **停產** |
| **乙太 PHY** | RTL8201F-VB-CG | `C45044` | QFN-32 | 65,994 | **$0.48** | ✅ |
| **USB-UART** | CH340N | `C2977777` | SOP-8 | 46,444 | **$0.62** | ✅ |
| **三路 DC-DC** | RY1303 | `C370881` | — | 23,969 | **$0.20** | ✅ |
| **SPI NOR 16MB** | W25Q128JVSIQ | `C97521` | SOIC-8-208mil | 49,682 | **$2.56** | ✅ |
| **USB 限流** | TPS2051BDBVR | `C24593` | SOT-23-5 | 38,715 | **$0.21** | ✅ |

> ⚠ **T113-S3 是 $22.25，不是規格書估的 $8。**
> ROADMAP §2.1 用「$8 —— 便宜到可以買備品」當選型理由之一，**那條理由不成立了**。
> 選型結論本身不變（內建 DDR3 仍是決定性優勢），但成本論述要改。

> ✅ **RY1303 的疑慮解除。** 001-power.md §2.3 標記「中國小廠料，須查 LCSC」，
> 實查庫存 23,969、單價 $0.20、MOQ 1 —— 料況比預期好，三路 DC-DC 可以用。

> ✅ **RTL8201F 比估的便宜 5 倍**（$0.48 vs 估 $1.25），且庫存 6.6 萬顆。

### 2.2 電源 LDO

| 軌 | 首選 | LCSC | 封裝 | 庫存 | 單價 | 備註 |
|---|---|---|---|---|---|---|
| **1.8V** | XC6206P182MR (UMW) | `C347373` | SOT-23 | 125,615 | **$0.021** | 便宜到不用考慮 |
| 1.8V (品牌) | AP2112K-1.8TRG1 | `C176944` | SOT-25 | 47,449 | $0.17 | Diodes,要精度選這個 |
| ~~1.2V~~ | ~~ME6211C12M5G-N~~ | `C236672` | SOT-23-5 | 17,254 | $0.060 | **已不需要**（ADV7511 不吃 1.2V） |

✅ **1.2V 那條軌隨 IT66121 一起消失。** 電源域回到 4 組。

⚠ 但 **1.8V 的首選要換**：ADV7511 的 1.8V 域吃約 180 mA，
加上原有 52 mA 已逼近內建 LDOA 的 260 mA 上限。
**XC6206 典型只有 200 mA，不夠 → 改用 AP2112K-1.8TRG1（600 mA）。**

```
三顆周邊 IC,三種電源答案:
  IT66121    要 1.2V + 3.3V     （已停產）
  ADV7511    要 1.8V + 3.3V     ← 本專案採用
  RTL8201F   只要 3.3V（內建 LDO 產生 1.1V 核心）
→ 每顆都要開 Power/Ground Pins 那一頁逐腳看,不能假設「3.3V 單軌」
```

### 2.3 接頭與被動

| 用途 | 料號 | LCSC | 庫存 | 單價 |
|---|---|---|---|---|
| RJ45 含變壓器 | HR911105A | `C12074` | 61,238 | **$1.72** |
| HDMI Type-A | KH-HDMI-19P-Cu | `C709361` | 1,761 | **$0.23** |
| USB Type-C 16P | TYPE-C-31-M-12 | `C165948` | 117,139 | **$0.19** |
| USB ESD | USBLC6-2SC6 (UMW) | `C2687116` | 103,679 | **$0.048** |
| HDMI ESD | SRV05-4.TCT | `C13612` | 54,524 | $0.16 |
| 24MHz 晶振 | X322524MOB4SI | `C70590` | 94,092 | **$0.094** |
| 32.768kHz 晶振 | Q13FC13500002 (Epson) | `C48615` | 39,665 | **$0.19** |
| MIPI FPC 40P 0.5mm | XDFC-0522-40P | `C7527532` | 1,415 | $0.24 |

⚠ **HDMI ESD 用 SRV05-4 要再確認電容值** —— 002-display.md §3.3 要求 <1pF，
SRV05-4 的 IO 電容約 3pF，**對 1.485 Gbps 的 TMDS 可能偏高**。
專用 HDMI ESD 陣列（如 ESD7104、PESD5V0X4UL）要另查。

```
[ ] SRV05-4 的 3pF 是否可接受,或改用 <1pF 的專用 HDMI ESD 陣列
```

### 2.4 未逐項查證（判定為低風險）

```
microSD 座、2.54mm 2×14 排針、0402 被動件、磁珠、電感
```

理由：這幾類在 LCSC 各有數百到數千個等效料號，**不存在單一料號缺貨風險**，
下單時挑庫存最高的 Basic Part 即可。花 API 呼叫逐顆查沒有價值。

⚠ 但 **0402 電阻的編碼仍要逐顆核對** —— 上一塊板踩過 6200/6201 差十倍的坑。

---

## 3. HDMI 橋接晶片：替代方案盤點

### 3.1 篩選條件

002-display.md §3.1 的原始判準是 **mainline driver**：
「LT8618SX 在 Linux 上通常要靠廠商 blob 或自己寫 driver。第一塊板不在 driver 上冒險。」

mainline 現況（`drivers/gpu/drm/bridge/Makefile`，torvalds/linux master，2026-09-20 查）：

```
✓ adv7511/            ADI ADV7511/13/33/35
✓ ti-tfp410.o         TI TFP410（DVI）
✓ ite-it66121.o       ITE IT66121        ← driver 在,晶片停產
✓ sii902x.o           Silicon Image 9022/9024
✓ chipone-icn6211.o   Chipone ICN6211
✓ chrontel-ch7033.o   Chrontel CH7033
✓ lontium-lt8912b / lt9211 / lt9611 / lt9611uxc / lt8713sx
✗ ms7210              無
```

⚠ **Lontium 那幾顆 mainline driver 都是 MIPI→HDMI 或 DP，不是並列 RGB→HDMI。**
LT8618SX 沒有 mainline driver，原判斷正確。

### 3.2 並列 RGB 輸入 + 有貨的候選

| 料號 | LCSC | 封裝 | 庫存 | 單價 | mainline | 備註 |
|---|---|---|---|---|---|---|
| **ADV7511KSTZ** | `C179459` | LQFP-100 14×14 **無 EPAD** | **57** | **$13.75** | ✅ `adv7511` | 完整 HDMI + audio |
| **TFP410PAPR** | `C7498519` | HTQFP-64 10×10 | **142** | **$6.28** | ✅ `ti-tfp410` | ⚠ **DVI only** |
| **MS7210** | `C2914249` | QFN-64-EP 9×9 | **299** | **$1.75** | ❌ 無 | 封裝與 IT66121 相同 |
| ~~IT66121FN~~ | `C2684803` | QFN-64-EP 9×9 | 0 | — | ✅ | **停產** |
| ~~SiI9022ACNU~~ | `C369565` | QFN-72-EP 10×10 | 0 | $20.40 | ✅ | 缺貨 |
| ~~LT8618SXB~~ | `C7424659` | — | 0 | $2.32 | ❌ | 缺貨且無 driver |
| ~~ICN6211~~ | `C246085` | — | 0 | — | ✅ | 停產 |
| ~~CH7035B~~ | `C5350162` | — | 0 | — | ✅(CH7033) | 停產 |

### 3.3 三個方案的取捨

> **✅ 已選 A（ADV7511）。** 判準見 §0 與 002-display.md §3.1 ——
> 目標從「driver 最省事」改為「driver 工作本身就是練習目標」之後，
> B（TFP410）反而是三個裡最差的：它是 DVI serializer，HDMI 協定層幾乎空白。

#### A. ADV7511KSTZ — 功能最完整，最貴

```
✅ mainline adv7511 driver 成熟,被大量 FPGA/SoC 板用,踩坑的人最多
✅ 輸入上限 165 MHz,與 IT66121 相同,1080p60 沒問題
✅ LQFP-100 有腳可目視,比 QFN-64 好檢查
⚠ 仍有 EPAD,還是得靠 PCBA（006-assembly.md 的結論不變）
⚠ 14×14 本體,和 T113 一樣大,100×100mm 板上要重新配置
❌ $13.75 × 2 = $27.5,是 IT66121 估價的 7 倍
```

##### ✅ 電平問題已解決：3.3V 可以直接驅動

`(ADV7511W Hardware User's Guide Rev.A, p.17 Pin Description)`

```
D[35:0] / CLK / HSYNC / VSYNC / DE
  "Supports typical CMOS logic levels from 1.8V up to 3.3V."
```

**視訊輸入腳 1.8V~3.3V 通吃 → VCC-PD = 3.3V 的決定不必推翻,也不需要電平轉換。**

⚠ 出處是 **ADV7511W**（165MHz 寬溫版）的硬體指南,我們要買的是 `ADV7511KSTZ`。
兩者同家族、同腳位,這條輸入電平規格是家族特性,但**下單前仍應回 ADV7511 自己的
datasheet 核對一次**（ADI 官網的 PDF 直連會擋 curl,要從 DigiKey 等鏡像抓）。

##### ⚠ 但帶出一個新問題：1.8V 軌的電流

`(同上,p.11 Power Supply)`

```
DVDD / AVDD / PVDD / BGVDD   1.8V      1.8V power = 325 mW  →  約 180 mA
DVDD_3V                      3.3V      3.3V power = 1 mW
```

```
001-power.md §2.2 原本的 1.8V 帳：已知約 52 mA
加上 ADV7511 的 180 mA          →  約 232 mA
晶片內建 LDOA 上限               →  260 mA   ← 幾乎貼滿,且 VDD18-DRAM 還是 TBD
```

**→ 外部 1.8V LDO 變成必須,而且不能用 XC6206（典型僅 200 mA）。**
改用 **AP2112K-1.8TRG1**（`C176944`，600 mA，$0.17，庫存 47,449）。

另外 ADI 建議把四個 1.8V 域**分成 3 組獨立的 PCB 電源域並各加 LC 濾波**
（p.41 Figure 21），PVDD（PLL）最敏感。這是額外的 layout 工作量。

##### 電源域淨變化

```
IT66121 方案   3.3 / 1.5 / 0.9 / 1.8 / 1.2   5 組
ADV7511 方案   3.3 / 1.5 / 0.9 / 1.8          4 組   ← 1.2V 消失,但 1.8V 要加大
```

#### B. TFP410PAPR — 最務實，代價是沒有 HDMI 音訊

```
✅ mainline ti-tfp410 driver,而且極簡單（它幾乎是個純 serializer）
✅ $6.28,庫存 142
✅ HTQFP-64 10×10,有腳,焊接難度低於 QFN
✅ 電源只要 3.3V → 省掉 1.2V 那條軌,電源樹回到 4 組
✅ 輸入 1.8V/3.3V 皆可（TFP410 的 IO 電平可選）→ VCC-PD 3.3V 決定不必推翻

❌ 它是 DVI transmitter,不是 HDMI：
     沒有 HDMI audio、沒有 InfoFrame、沒有 HDCP
     插 HDMI 螢幕「會有畫面」（HDMI sink 相容 DVI 訊號）,但沒有聲音
❌ 螢幕的 EDID 會被當成 DVI 裝置,某些電視可能不吃
```

**「沒有 HDMI 音訊」對這塊板的實際影響：本來就有 3.5mm 音訊座。**
HDMI 音訊不是這塊板的學習目標，TMDS layout 才是 —— **而 TMDS 走線完全一樣。**

#### C. MS7210 — 最便宜、footprint 可沿用，但違反原始判準

```
✅ $1.75,庫存 299
✅ QFN-64-EP 9×9,與 IT66121 同封裝 → 008-footprint.md 的驗算可直接沿用
✅ 完整 HDMI（含音訊）
❌ 無 mainline driver —— 這正是當初否決 LT8618SX 的理由
   要自己寫或移植廠商 driver,第一塊 Linux 板不該把風險押在這
```

### 3.4 第四條路：從代理商買停產的 IT66121

Utsource / Veswin / IC-Components 等通路仍有 IT66121FN 庫存（搜尋結果顯示上萬顆）。

```
❌ 與 LCSC/JLCPCB 訂單分離 → 多一筆運費、多一次報關
❌ 停產料的通路貨有仿冒與翻新風險,第一塊板不該引入這個變數
❌ 之後想再做一版買不到
```

**不建議。** 但如果堅持要原設計不動，這是唯一選項。

---

## 4. 成本重算

### 4.1 與 SPEC §7 估算的差異

| 項目 | SPEC 估算 | 實查 | 差 |
|---|---|---|---|
| T113-S3 ×2 | $16 | **$44.50** | **+$28.50** |
| IT66121 ×2 | $8 | **不可得** | — |
| RTL8201F ×2 | $2.50 | $0.96 | −$1.54 |
| CH340N ×2 | $1.60 | $1.24 | −$0.36 |
| RJ45 ×2 | $4 | $3.43 | −$0.57 |

**T113-S3 一項就吃掉 $28.50。** 其餘零件實際比估算便宜，但補不回來。

### 4.2 三種橋接方案的整板成本（部分貼裝 ×2 片）

```
共同項：PCB 5 片含阻抗 $20 · PCBA 服務費 ~$15 · 其餘零件 ~$30 · 運費 $18
主晶片：T113-S3 ×2 = $44.50 · RTL8201F ×2 = $0.96
```

| | 橋接 ×2 | 合計 USD | 約 NT$ | 預算 NT$5,000 |
|---|---|---|---|---|
| **✅ A. ADV7511** | $27.50 | **$156** | ~NT$5,000 | ⚠ 剛好踩線（已選） |
| **B. TFP410** | $12.56 | **$141** | ~NT$4,520 | ✅ 有餘裕 |
| **C. MS7210** | $3.51 | **$132** | ~NT$4,230 | ✅ 最寬鬆 |

⚠ 若照原計畫「部分貼裝 ×3 片」，主晶片要多買一套（+$22.25 +橋接），
**三個方案都會超過 NT$5,000。**

```
→ 連帶決定：PCBA 片數從 3 片降為 2 片
   理由不是組裝策略改變,是 T113-S3 單價比估算高 2.8 倍
```

---

## 5. 待決事項

```
[x] ★ HDMI 橋接晶片 → **A. ADV7511KSTZ (C179459)**
[x] ADV7511 視訊輸入腳電平 → **1.8V~3.3V 通吃**，VCC-PD = 3.3V 不受影響
[ ] 若選 A：1.8V LDO 改用 600mA 等級（AP2112K-1.8，C176944），XC6206 不夠
[ ] 若選 A：回 ADV7511（非 W 版）datasheet 核對輸入電平與電源規格
[x] PCBA 片數 3 → **2**（成本驅動，見 §4.2）
[ ] SRV05-4 的 3pF IO 電容對 TMDS 是否可接受，或改專用 HDMI ESD
[ ] microSD 座 / 排針 / 被動件挑料（低風險，下單時做）
[ ] 下單前重查全部庫存與價格（本文件數字的有效期只有查詢當日）
```

---

## 6. 方法筆記

**LCSC 與 JLCPCB 的網頁都需要 JavaScript，`WebFetch` 只會拿到導覽列。**
可用的是 JLCPCB 的零件搜尋 API：

```python
POST https://jlcpcb.com/api/overseas-pcb-order/v1/shoppingCart/smtGood/selectSmtComponentList
{"currentPage":1,"pageSize":25,"keyword":"<料號>","searchSource":"search"}

回傳 data.componentPageInfo.list[]，每筆含：
  componentCode        C 編號
  stockCount           庫存
  componentPrices[]    價格階梯
  minPurchaseNum       MOQ
  noBuyReason          停產／不可購買的原因   ← 最有價值的欄位
  componentSpecificationEn  封裝
  preferredComponentFlag    是否 Preferred
```

⚠ 回傳裡 `componentBrandEn == "JLCPCB Assembly"` 的項目是 JLCPCB 內部的組裝品項，
價格固定 `$0.0396`，**不是真實零件，要過濾掉**。

**`noBuyReason` 這個欄位是這次查證的關鍵** —— 如果只看 `stockCount == 0`，
會以為 IT66121 只是暫時缺貨，等補貨就好。
是 `"This product is no longer manufactured."` 這句話把它從「缺貨」變成「要改設計」。

```
規則：查料況不能只看庫存數字,要看停產標記。
      庫存 0 有兩種意思,差別是「等一週」還是「重畫原理圖」。
```
