NickHuang0228/T113-DEV-V1/hardware/display.kicad_sch

## KiCad design hardware/display.kicad_sch (2026-10-12)

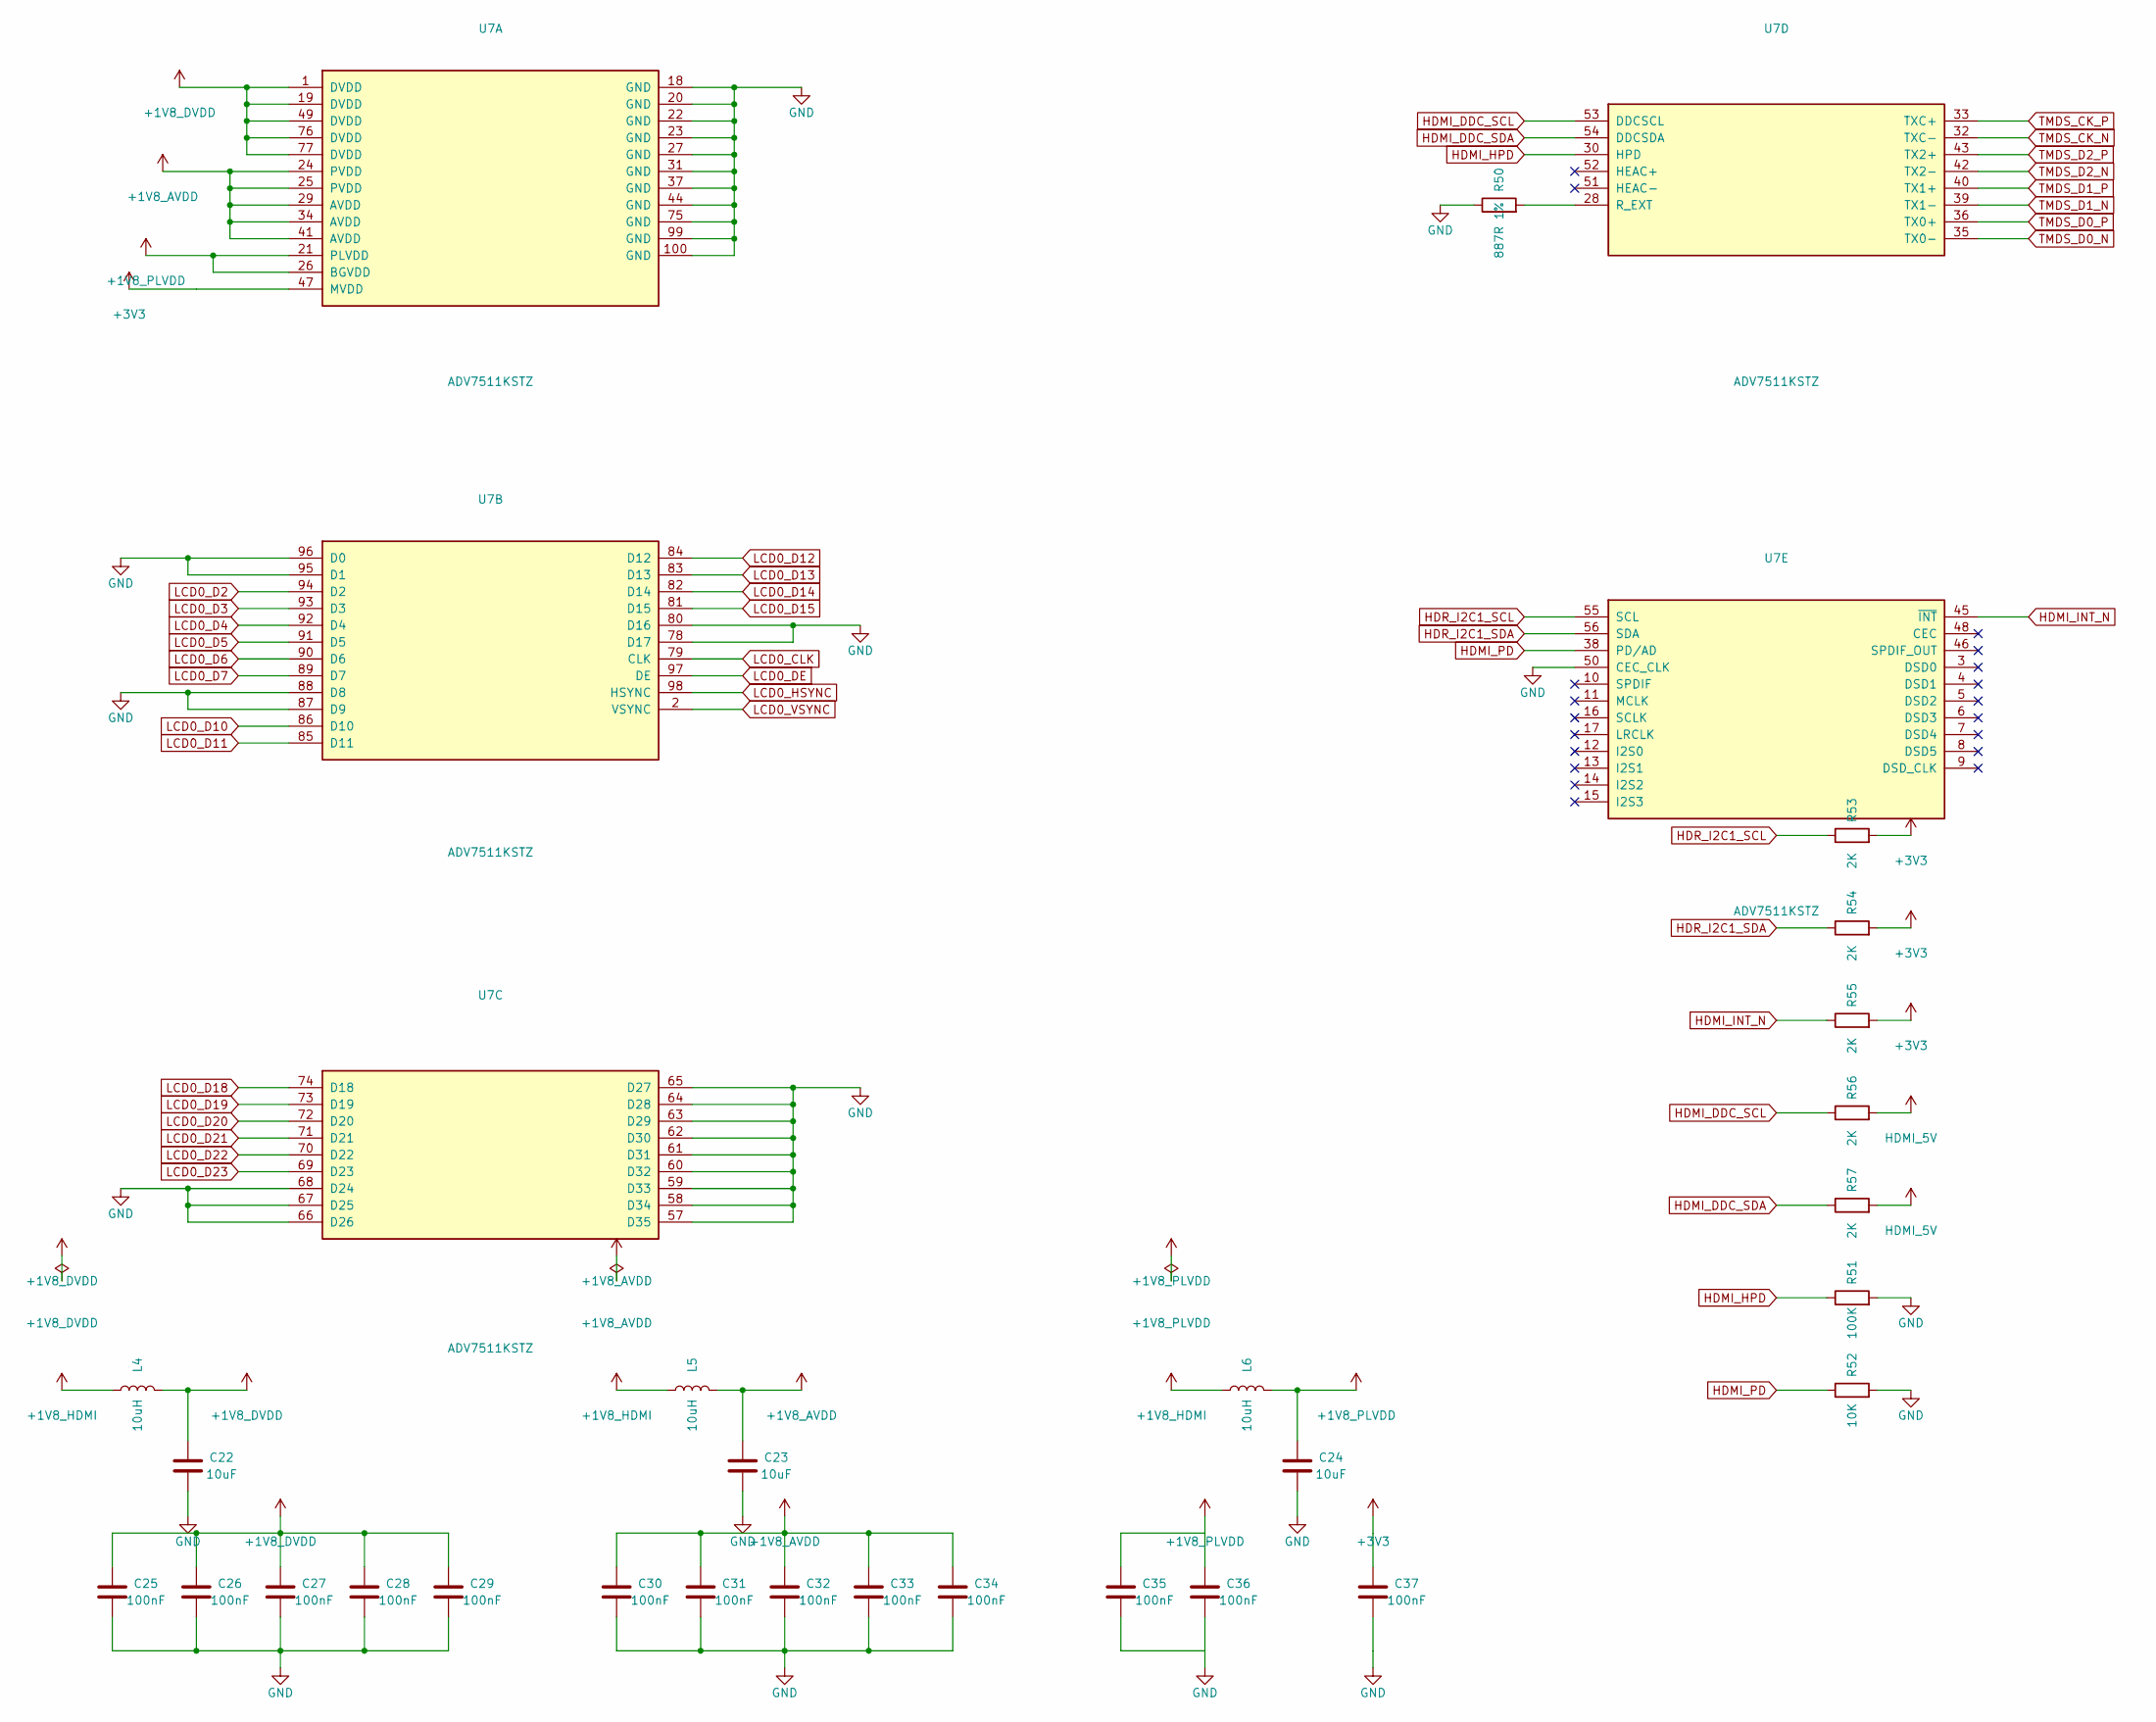
[picture p1: schematic display.kicad_sch]

Parts:
C22, C23, C24: 10uF; C_0805_2012Metric
C25, C26, C27, C28, C29, C30, C31, C32, C33, C34, C35, C36, C37: 100nF; C_0603_1608Metric
L4, L5, L6: 10uH; L_1210_3225Metric
R50: 887R 1%; R_0603_1608Metric
R51: 100K; R_0603_1608Metric
R52: 10K; R_0603_1608Metric
R53, R54, R55, R56, R57: 2K; R_0603_1608Metric
U7: ADV7511KSTZ; LQFP-100_14x14mm_P0.5mm

Connections:
+1V8_AVDD: C23.1, C30.1, C31.1, C32.1, C33.1, C34.1, L5.2, U7.24 (PVDD), U7.25 (PVDD), U7.29 (AVDD), U7.34 (AVDD), U7.41 (AVDD)
+1V8_DVDD: C22.1, C25.1, C26.1, C27.1, C28.1, C29.1, L4.2, U7.1 (DVDD), U7.19 (DVDD), U7.49 (DVDD), U7.76 (DVDD), U7.77 (DVDD)
+1V8_HDMI: L4.1, L5.1, L6.1
+1V8_PLVDD: C24.1, C35.1, C36.1, L6.2, U7.21 (PLVDD), U7.26 (BGVDD)
+3V3: C37.1, R53.2, R54.2, R55.2, U7.47 (MVDD)
GND: C22.2, C23.2, C24.2, C25.2, C26.2, C27.2, C28.2, C29.2, C30.2, C31.2, C32.2, C33.2, C34.2, C35.2, C36.2, C37.2, R50.1, R51.2, R52.2, U7.18 (GND), U7.20 (GND), U7.22 (GND), U7.23 (GND), U7.27 (GND), U7.31 (GND), U7.37 (GND), U7.44 (GND), U7.50 (CEC_CLK), U7.57 (D35), U7.58 (D34), U7.59 (D33), U7.60 (D32), U7.61 (D31), U7.62 (D30), U7.63 (D29), U7.64 (D28), U7.65 (D27), U7.66 (D26), U7.67 (D25), U7.68 (D24), U7.75 (GND), U7.78 (D17), U7.80 (D16), U7.87 (D9), U7.88 (D8), U7.95 (D1), U7.96 (D0), U7.99 (GND), U7.100 (GND)
HDMI_5V: R56.2, R57.2
HDMI_DDC_SCL: R56.1, U7.53 (DDCSCL)
HDMI_DDC_SDA: R57.1, U7.54 (DDCSDA)
HDMI_HPD: R51.1, U7.30 (HPD)
HDMI_INT_N: R55.1, U7.45 (~INT)
HDMI_PD: R52.1, U7.38 (PD/AD)
HDR_I2C1_SCL: R53.1, U7.55 (SCL)
HDR_I2C1_SDA: R54.1, U7.56 (SDA)
LCD0_CLK: U7.79 (CLK)
LCD0_D2: U7.94 (D2)
LCD0_D3: U7.93 (D3)
LCD0_D4: U7.92 (D4)
LCD0_D5: U7.91 (D5)
LCD0_D6: U7.90 (D6)
LCD0_D7: U7.89 (D7)
LCD0_D10: U7.86 (D10)
LCD0_D11: U7.85 (D11)
LCD0_D12: U7.84 (D12)
LCD0_D13: U7.83 (D13)
LCD0_D14: U7.82 (D14)
LCD0_D15: U7.81 (D15)
LCD0_D18: U7.74 (D18)
LCD0_D19: U7.73 (D19)
LCD0_D20: U7.72 (D20)
LCD0_D21: U7.71 (D21)
LCD0_D22: U7.70 (D22)
LCD0_D23: U7.69 (D23)
LCD0_DE: U7.97 (DE)
LCD0_HSYNC: U7.98 (HSYNC)
LCD0_VSYNC: U7.2 (VSYNC)
unnamed: R50.2, U7.28 (R_EXT)
TMDS_CK_N: U7.32 (TXC-)
TMDS_CK_P: U7.33 (TXC+)
TMDS_D0_N: U7.35 (TX0-)
TMDS_D0_P: U7.36 (TX0+)
TMDS_D1_N: U7.39 (TX1-)
TMDS_D1_P: U7.40 (TX1+)
TMDS_D2_N: U7.42 (TX2-)
TMDS_D2_P: U7.43 (TX2+)
