NickHuang0228/T113-DEV-V1/hardware/hdmi.kicad_sch

## KiCad design hardware/hdmi.kicad_sch (2026-10-12)

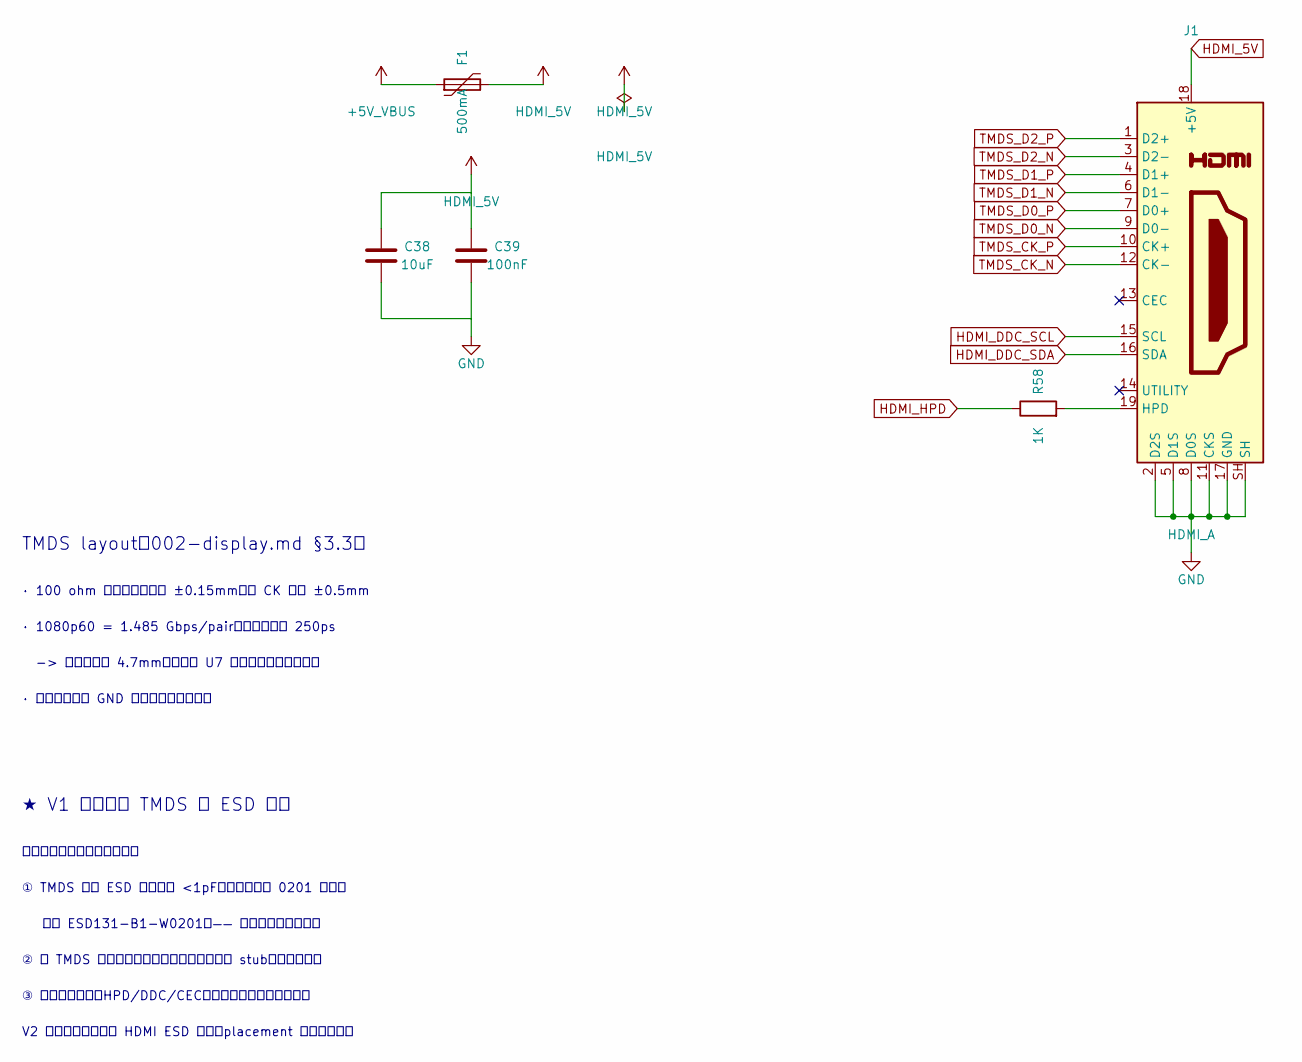
[picture p2: schematic hdmi.kicad_sch]

Parts:
C38: 10uF; C_0805_2012Metric
C39: 100nF; C_0603_1608Metric
F1: 500mA; Fuse_1206_3216Metric
J1: HDMI_A; HDMI_A_Amphenol_10029449-x01xLF_Horizontal
R58: 1K; R_0603_1608Metric

Connections:
+5V_VBUS: F1.1
GND: C38.2, C39.2, J1.2 (D2S), J1.5 (D1S), J1.8 (D0S), J1.11 (CKS), J1.17 (GND), J1.SH
HDMI_5V: C38.1, C39.1, F1.2, J1.18 (+5V)
HDMI_DDC_SCL: J1.15 (SCL)
HDMI_DDC_SDA: J1.16 (SDA)
HDMI_HPD: R58.1
unnamed: J1.19 (HPD), R58.2
TMDS_CK_N: J1.12 (CK-)
TMDS_CK_P: J1.10 (CK+)
TMDS_D0_N: J1.9 (D0-)
TMDS_D0_P: J1.7 (D0+)
TMDS_D1_N: J1.6 (D1-)
TMDS_D1_P: J1.4 (D1+)
TMDS_D2_N: J1.3 (D2-)
TMDS_D2_P: J1.1 (D2+)

Notes on the sheet:
TMDS layout（002-display.md §3.3）
· 100 ohm 差分，對內等長 ±0.15mm，對 CK 等長 ±0.5mm
· 1080p60 = 1.485 Gbps/pair，上升時間約 250ps
-> 臨界長度約 4.7mm，接頭到 U7 全程都要當傳輸線處理
· 全程走在完整 GND 平面上方，不跨分割
★ V1 刻意不放 TMDS 的 ESD 保護
理由（三條都成立才敢省）：
① TMDS 要求 ESD 元件電容 <1pF，符合的只有 0201 單線件
（如 ESD131-B1-W0201）—— 超出本板手焊的能力
② 在 TMDS 走線上留「不焊的焊盤」本身就是 stub，比不放更糟
③ 只保護慢速線（HPD/DDC/CEC）會造成「有保護」的錯覺
V2 待辦：改用整合式 HDMI ESD 陣列，placement 階段就留位置
