NickHuang0228/T113-DEV-V1/hardware/mcu.kicad_sch

## KiCad design hardware/mcu.kicad_sch (2026-10-12)

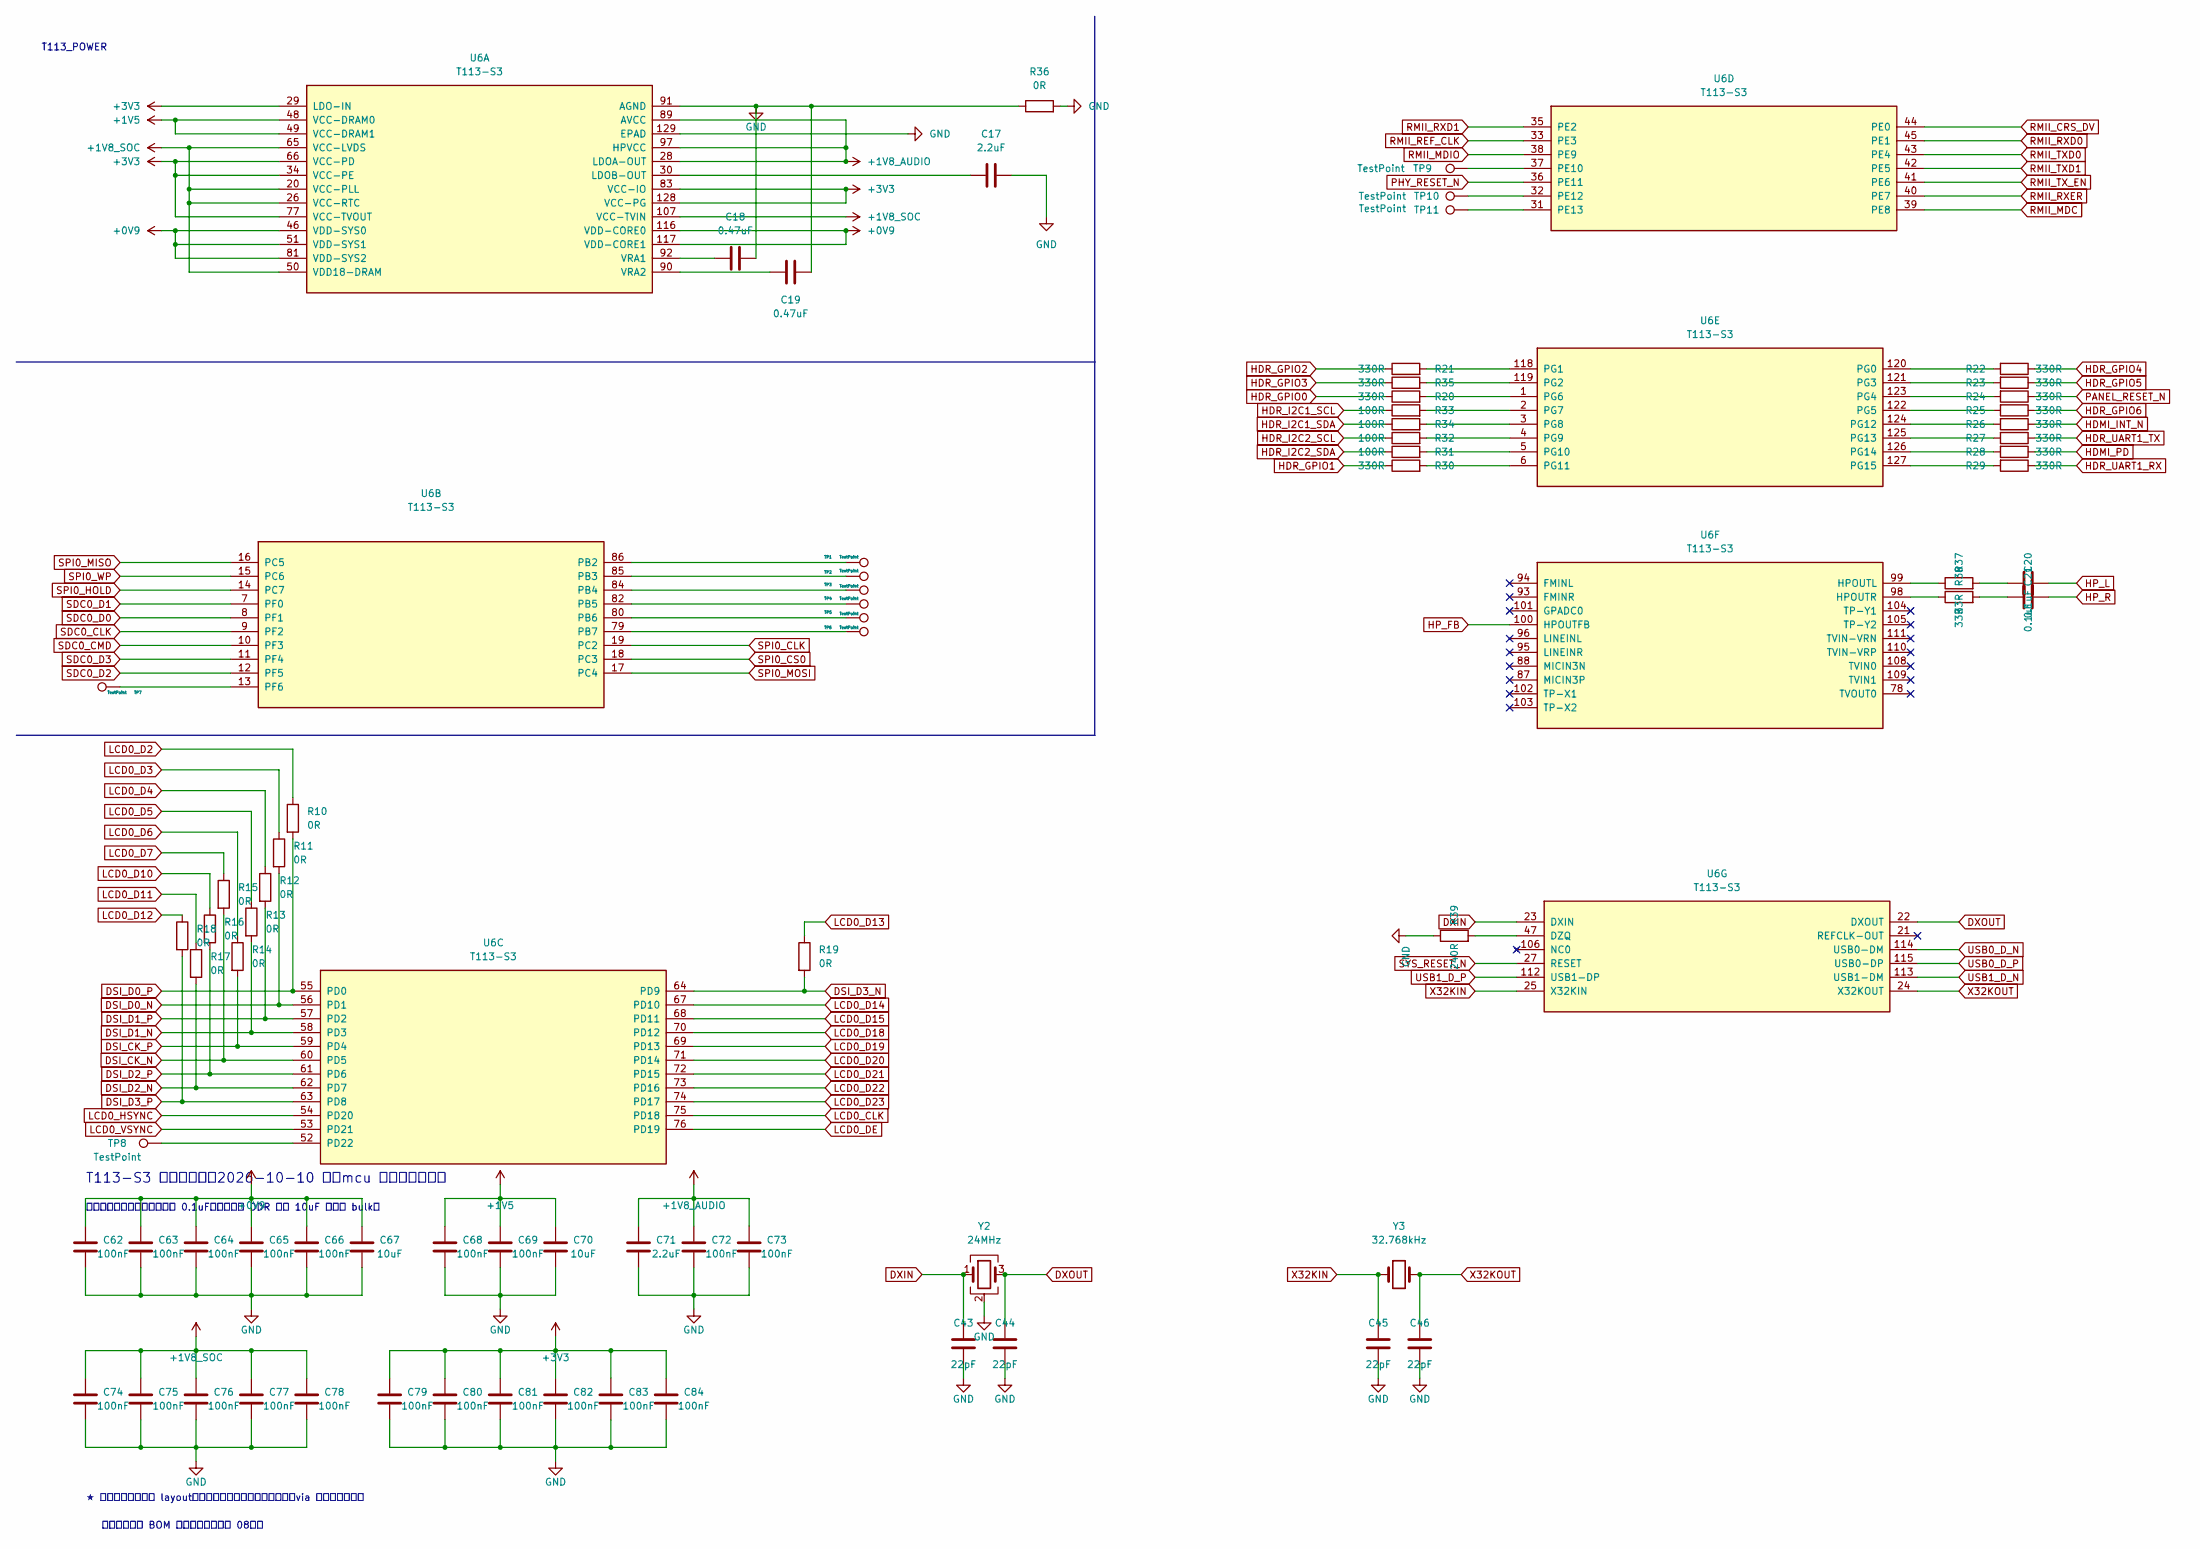
[picture p3: schematic mcu.kicad_sch]

Parts:
C17, C71: 2.2uF; C_0603_1608Metric
C18, C19: 0.47uF; C_0603_1608Metric
C20, C21: 0.1uF; C_0603_1608Metric
C43, C44, C45, C46: 22pF; C_0603_1608Metric
C62, C63, C64, C65, C66, C68, C69, C72, C73, C74, C75, C76, C77, C78, C79, C80, C81, C82, C83, C84: 100nF; C_0603_1608Metric
C67, C70: 10uF; C_0805_2012Metric
R10, R11, R12, R13, R14, R15, R16, R17, R18, R19, R36: 0R; R_0603_1608Metric
R20, R21, R22, R23, R24, R25, R26, R27, R28, R29, R30, R35: 330R; R_0603_1608Metric
R31, R32, R33, R34: 100R; R_0603_1608Metric
R37, R38: 33R; R_0603_1608Metric
R39: 240R; R_0603_1608Metric
TP1, TP2, TP3, TP4, TP5, TP6, TP7, TP8, TP9, TP10, TP11: TestPoint; TestPoint_Pad_D1.5mm
U6: T113-S3; eLQFP-128_14x14mm_P0.4mm_EP5.72x5.72mm_ThermalVias
Y2: 24MHz; Crystal_SMD_2520-4Pin_2.5x2.0mm
Y3: 32.768kHz; Crystal_SMD_3215-2Pin_3.2x1.5mm

Connections:
+0V9: C62.1, C63.1, C64.1, C65.1, C66.1, C67.1, U6.46 (VDD-SYS0), U6.51 (VDD-SYS1), U6.81 (VDD-SYS2), U6.116 (VDD-CORE0), U6.117 (VDD-CORE1)
+1V5: C68.1, C69.1, C70.1, U6.48 (VCC-DRAM0), U6.49 (VCC-DRAM1)
+1V8_AUDIO: C71.1, C72.1, C73.1, U6.28 (LDOA-OUT), U6.89 (AVCC), U6.97 (HPVCC)
+1V8_SOC: C74.1, C75.1, C76.1, C77.1, C78.1, U6.20 (VCC-PLL), U6.26 (VCC-RTC), U6.50 (VDD18-DRAM), U6.65 (VCC-LVDS), U6.107 (VCC-TVIN)
+3V3: C79.1, C80.1, C81.1, C82.1, C83.1, C84.1, U6.29 (LDO-IN), U6.34 (VCC-PE), U6.66 (VCC-PD), U6.77 (VCC-TVOUT), U6.83 (VCC-IO), U6.128 (VCC-PG)
DSI_CK_N: R15.2, U6.60 (PD5)
DSI_CK_P: R14.2, U6.59 (PD4)
DSI_D0_N: R11.2, U6.56 (PD1)
DSI_D0_P: R10.2, U6.55 (PD0)
DSI_D1_N: R13.2, U6.58 (PD3)
DSI_D1_P: R12.2, U6.57 (PD2)
DSI_D2_N: R17.2, U6.62 (PD7)
DSI_D2_P: R16.2, U6.61 (PD6)
DSI_D3_N: R19.2, U6.64 (PD9)
DSI_D3_P: R18.2, U6.63 (PD8)
DXIN: C43.1, U6.23 (DXIN), Y2.1
DXOUT: C44.1, U6.22 (DXOUT), Y2.3
GND: C17.1, C18.1, C19.1, C43.2, C44.2, C45.2, C46.2, C62.2, C63.2, C64.2, C65.2, C66.2, C67.2, C68.2, C69.2, C70.2, C71.2, C72.2, C73.2, C74.2, C75.2, C76.2, C77.2, C78.2, C79.2, C80.2, C81.2, C82.2, C83.2, C84.2, R36.1, R36.2, R39.1, U6.91 (AGND), U6.129 (EPAD), Y2.2 (G), Y2.4 (G)
HDMI_INT_N: R26.1
HDMI_PD: R28.1
HDR_GPIO0: R20.1
HDR_GPIO1: R30.1
HDR_GPIO2: R21.1
HDR_GPIO3: R35.1
HDR_GPIO4: R22.1
HDR_GPIO5: R23.1
HDR_GPIO6: R25.1
HDR_I2C1_SCL: R33.1
HDR_I2C1_SDA: R34.1
HDR_I2C2_SCL: R32.1
HDR_I2C2_SDA: R31.1
HDR_UART1_RX: R29.1
HDR_UART1_TX: R27.1
HP_FB: U6.100 (HPOUTFB)
HP_L: C20.2
HP_R: C21.2
LCD0_CLK: U6.75 (PD18)
LCD0_D2: R10.1
LCD0_D3: R11.1
LCD0_D4: R12.1
LCD0_D5: R13.1
LCD0_D6: R14.1
LCD0_D7: R15.1
LCD0_D10: R16.1
LCD0_D11: R17.1
LCD0_D12: R18.1
LCD0_D13: R19.1
LCD0_D14: U6.67 (PD10)
LCD0_D15: U6.68 (PD11)
LCD0_D18: U6.70 (PD12)
LCD0_D19: U6.69 (PD13)
LCD0_D20: U6.71 (PD14)
LCD0_D21: U6.72 (PD15)
LCD0_D22: U6.73 (PD16)
LCD0_D23: U6.74 (PD17)
LCD0_DE: U6.76 (PD19)
LCD0_HSYNC: U6.54 (PD20)
LCD0_VSYNC: U6.53 (PD21)
unnamed: C17.2, U6.30 (LDOB-OUT)
unnamed: C18.2, U6.92 (VRA1)
unnamed: C19.2, U6.90 (VRA2)
unnamed: C20.1, R37.2
unnamed: C21.1, R38.2
unnamed: R20.2, U6.1 (PG6)
unnamed: R21.2, U6.118 (PG1)
unnamed: R22.2, U6.120 (PG0)
unnamed: R23.2, U6.121 (PG3)
unnamed: R24.2, U6.123 (PG4)
unnamed: R25.2, U6.122 (PG5)
unnamed: R26.2, U6.124 (PG12)
unnamed: R27.2, U6.125 (PG13)
unnamed: R28.2, U6.126 (PG14)
unnamed: R29.2, U6.127 (PG15)
unnamed: R30.2, U6.6 (PG11)
unnamed: R31.2, U6.5 (PG10)
unnamed: R32.2, U6.4 (PG9)
unnamed: R33.2, U6.2 (PG7)
unnamed: R34.2, U6.3 (PG8)
unnamed: R35.2, U6.119 (PG2)
unnamed: R37.1, U6.99 (HPOUTL)
unnamed: R38.1, U6.98 (HPOUTR)
unnamed: R39.2, U6.47 (DZQ)
unnamed: TP1.1, U6.86 (PB2)
unnamed: TP2.1, U6.85 (PB3)
unnamed: TP3.1, U6.84 (PB4)
unnamed: TP4.1, U6.82 (PB5)
unnamed: TP5.1, U6.80 (PB6)
unnamed: TP6.1, U6.79 (PB7)
unnamed: TP7.1, U6.13 (PF6)
unnamed: TP8.1, U6.52 (PD22)
unnamed: TP9.1, U6.37 (PE10)
unnamed: TP10.1, U6.32 (PE12)
unnamed: TP11.1, U6.31 (PE13)
PANEL_RESET_N: R24.1
PHY_RESET_N: U6.36 (PE11)
RMII_CRS_DV: U6.44 (PE0)
RMII_MDC: U6.39 (PE8)
RMII_MDIO: U6.38 (PE9)
RMII_REF_CLK: U6.33 (PE3)
RMII_RXD0: U6.45 (PE1)
RMII_RXD1: U6.35 (PE2)
RMII_RXER: U6.40 (PE7)
RMII_TXD0: U6.43 (PE4)
RMII_TXD1: U6.42 (PE5)
RMII_TX_EN: U6.41 (PE6)
SDC0_CLK: U6.9 (PF2)
SDC0_CMD: U6.10 (PF3)
SDC0_D0: U6.8 (PF1)
SDC0_D1: U6.7 (PF0)
SDC0_D2: U6.12 (PF5)
SDC0_D3: U6.11 (PF4)
SPI0_CLK: U6.19 (PC2)
SPI0_CS0: U6.18 (PC3)
SPI0_HOLD: U6.14 (PC7)
SPI0_MISO: U6.16 (PC5)
SPI0_MOSI: U6.17 (PC4)
SPI0_WP: U6.15 (PC6)
SYS_RESET_N: U6.27 (RESET)
USB0_D_N: U6.114 (USB0-DM)
USB0_D_P: U6.115 (USB0-DP)
USB1_D_N: U6.113 (USB1-DM)
USB1_D_P: U6.112 (USB1-DP)
X32KIN: C45.1, U6.25 (X32KIN), Y3.1
X32KOUT: C46.1, U6.24 (X32KOUT), Y3.2

Notes on the sheet:
T113_POWER
T113-S3 的逐腳去耦（2026-10-10 補；mcu 頁手畫時漏了）
每一條軌「幾支電源腳就幾顆 0.1uF」，核心與 DDR 另加 10uF 的本地 bulk。
★ 真正決定效果的是 layout：每一顆要貼著它負責的那支腳、via 直接下地平面。
擺遠了就只是 BOM 上多幾顆料（概念 08）。
