NickHuang0228/T113-DEV-V1/hardware/mipi.kicad_sch

## KiCad design hardware/mipi.kicad_sch (2026-10-12)

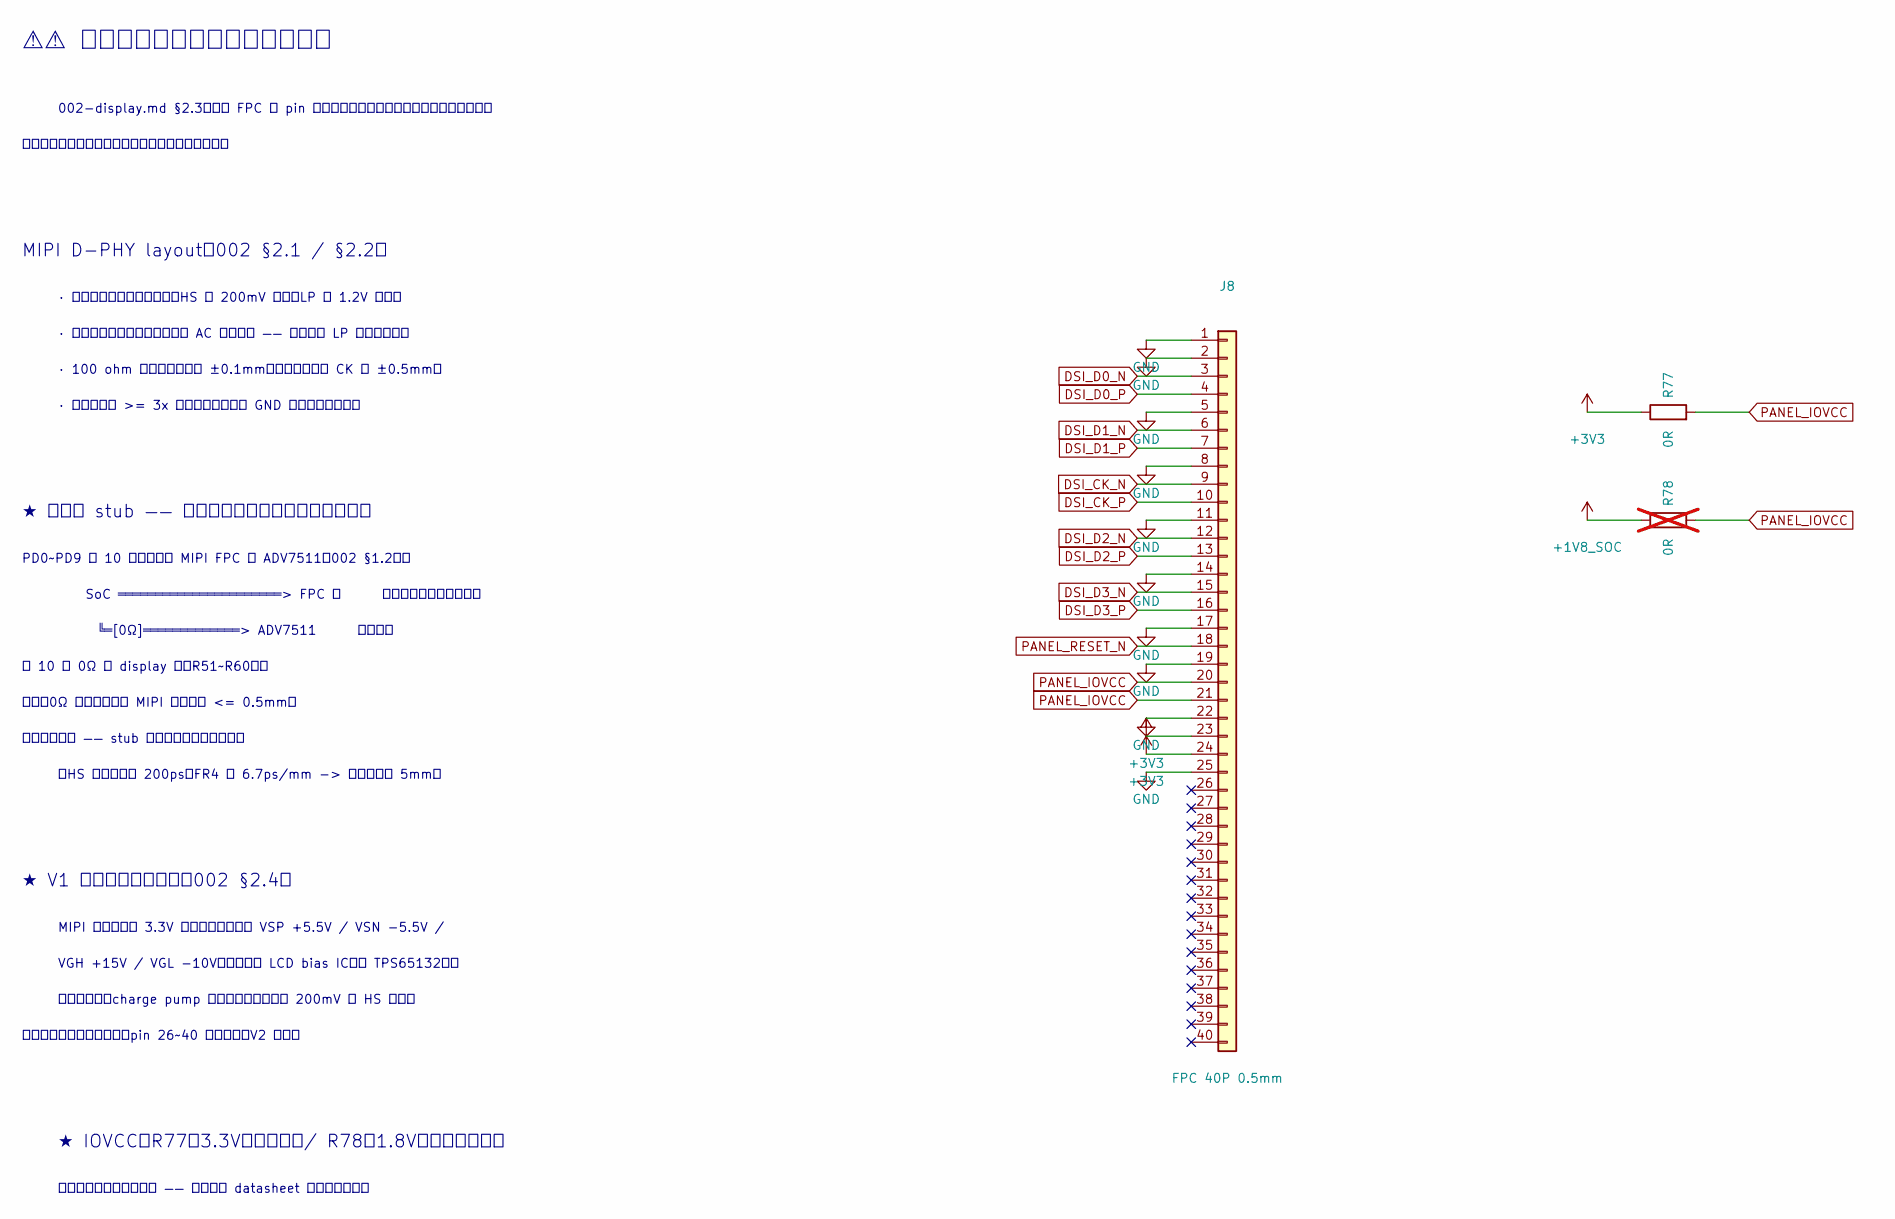
[picture p4: schematic mipi.kicad_sch]

Parts:
J8: FPC 40P 0.5mm; TE_4-1734839-0_1x40-1MP_P0.5mm_Horizontal
R77: 0R; R_0603_1608Metric
R78: 0R; R_0603_1608Metric; not fitted

Connections:
+1V8_SOC: R78.1
+3V3: J8.23, J8.24, R77.1
DSI_CK_N: J8.9
DSI_CK_P: J8.10
DSI_D0_N: J8.3
DSI_D0_P: J8.4
DSI_D1_N: J8.6
DSI_D1_P: J8.7
DSI_D2_N: J8.12
DSI_D2_P: J8.13
DSI_D3_N: J8.15
DSI_D3_P: J8.16
GND: J8.1, J8.2, J8.5, J8.8, J8.11, J8.14, J8.17, J8.19, J8.22, J8.25
PANEL_IOVCC: J8.20, J8.21, R77.2, R78.2
PANEL_RESET_N: J8.18

Notes on the sheet:
⚠⚠ 這張腳位表是暫定值，不是定案
002-display.md §2.3：面板 FPC 的 pin 定義各家不同，下單前務必用實體面板比對。
選定面板後逐腳核對完，才可以開始佈這一頁的線。
MIPI D-PHY layout（002 §2.1 / §2.2）
· 同一對銅線上有兩種訊號：HS 是 200mV 差分、LP 是 1.2V 單端。
· 所以不能串任何電阻、不能加 AC 耦合電容 —— 那會破壞 LP 的直流準位。
· 100 ohm 差分，對內等長 ±0.1mm，各資料對相對 CK 對 ±0.5mm。
· 對與對之間 >= 3x 線寬；全程走完整 GND 平面，不跨分割。
★ 不能有 stub —— 這是這塊板最重要的一條佈線規則
PD0~PD9 這 10 條同時接到 MIPI FPC 與 ADV7511（002 §1.2）：
SoC ══════════════════════> FPC 座 （直通，不經任何元件）
╚═[0Ω]═════════════> ADV7511 （分支）
那 10 顆 0Ω 在 display 頁（R51~R60）。
規則：0Ω 焊盤邊緣距離 MIPI 主幹走線 <= 0.5mm。
放遠了就白做 —— stub 還在，只是換了個位置。
（HS 上升時間約 200ps，FR4 約 6.7ps/mm -> 臨界長度約 5mm）
★ V1 刻意沒有面板電源（002 §2.4）
MIPI 面板不是接 3.3V 就會亮：典型還要 VSP +5.5V / VSN -5.5V /
VGH +15V / VGL -10V，需要專用 LCD bias IC（如 TPS65132）。
不做的理由：charge pump 的開關雜訊會耦合到 200mV 的 HS 訊號，
第一版不要同時冒這個險。pin 26~40 保留給它，V2 再補。
★ IOVCC：R77（3.3V，預設焊）/ R78（1.8V，不焊）二選一
焊錯邊的代價是面板報廢 —— 核對面板 datasheet 之前不要上電。
