NickHuang0228/T113-DEV-V1/hardware/net.kicad_sch

## KiCad design hardware/net.kicad_sch (2026-10-12)

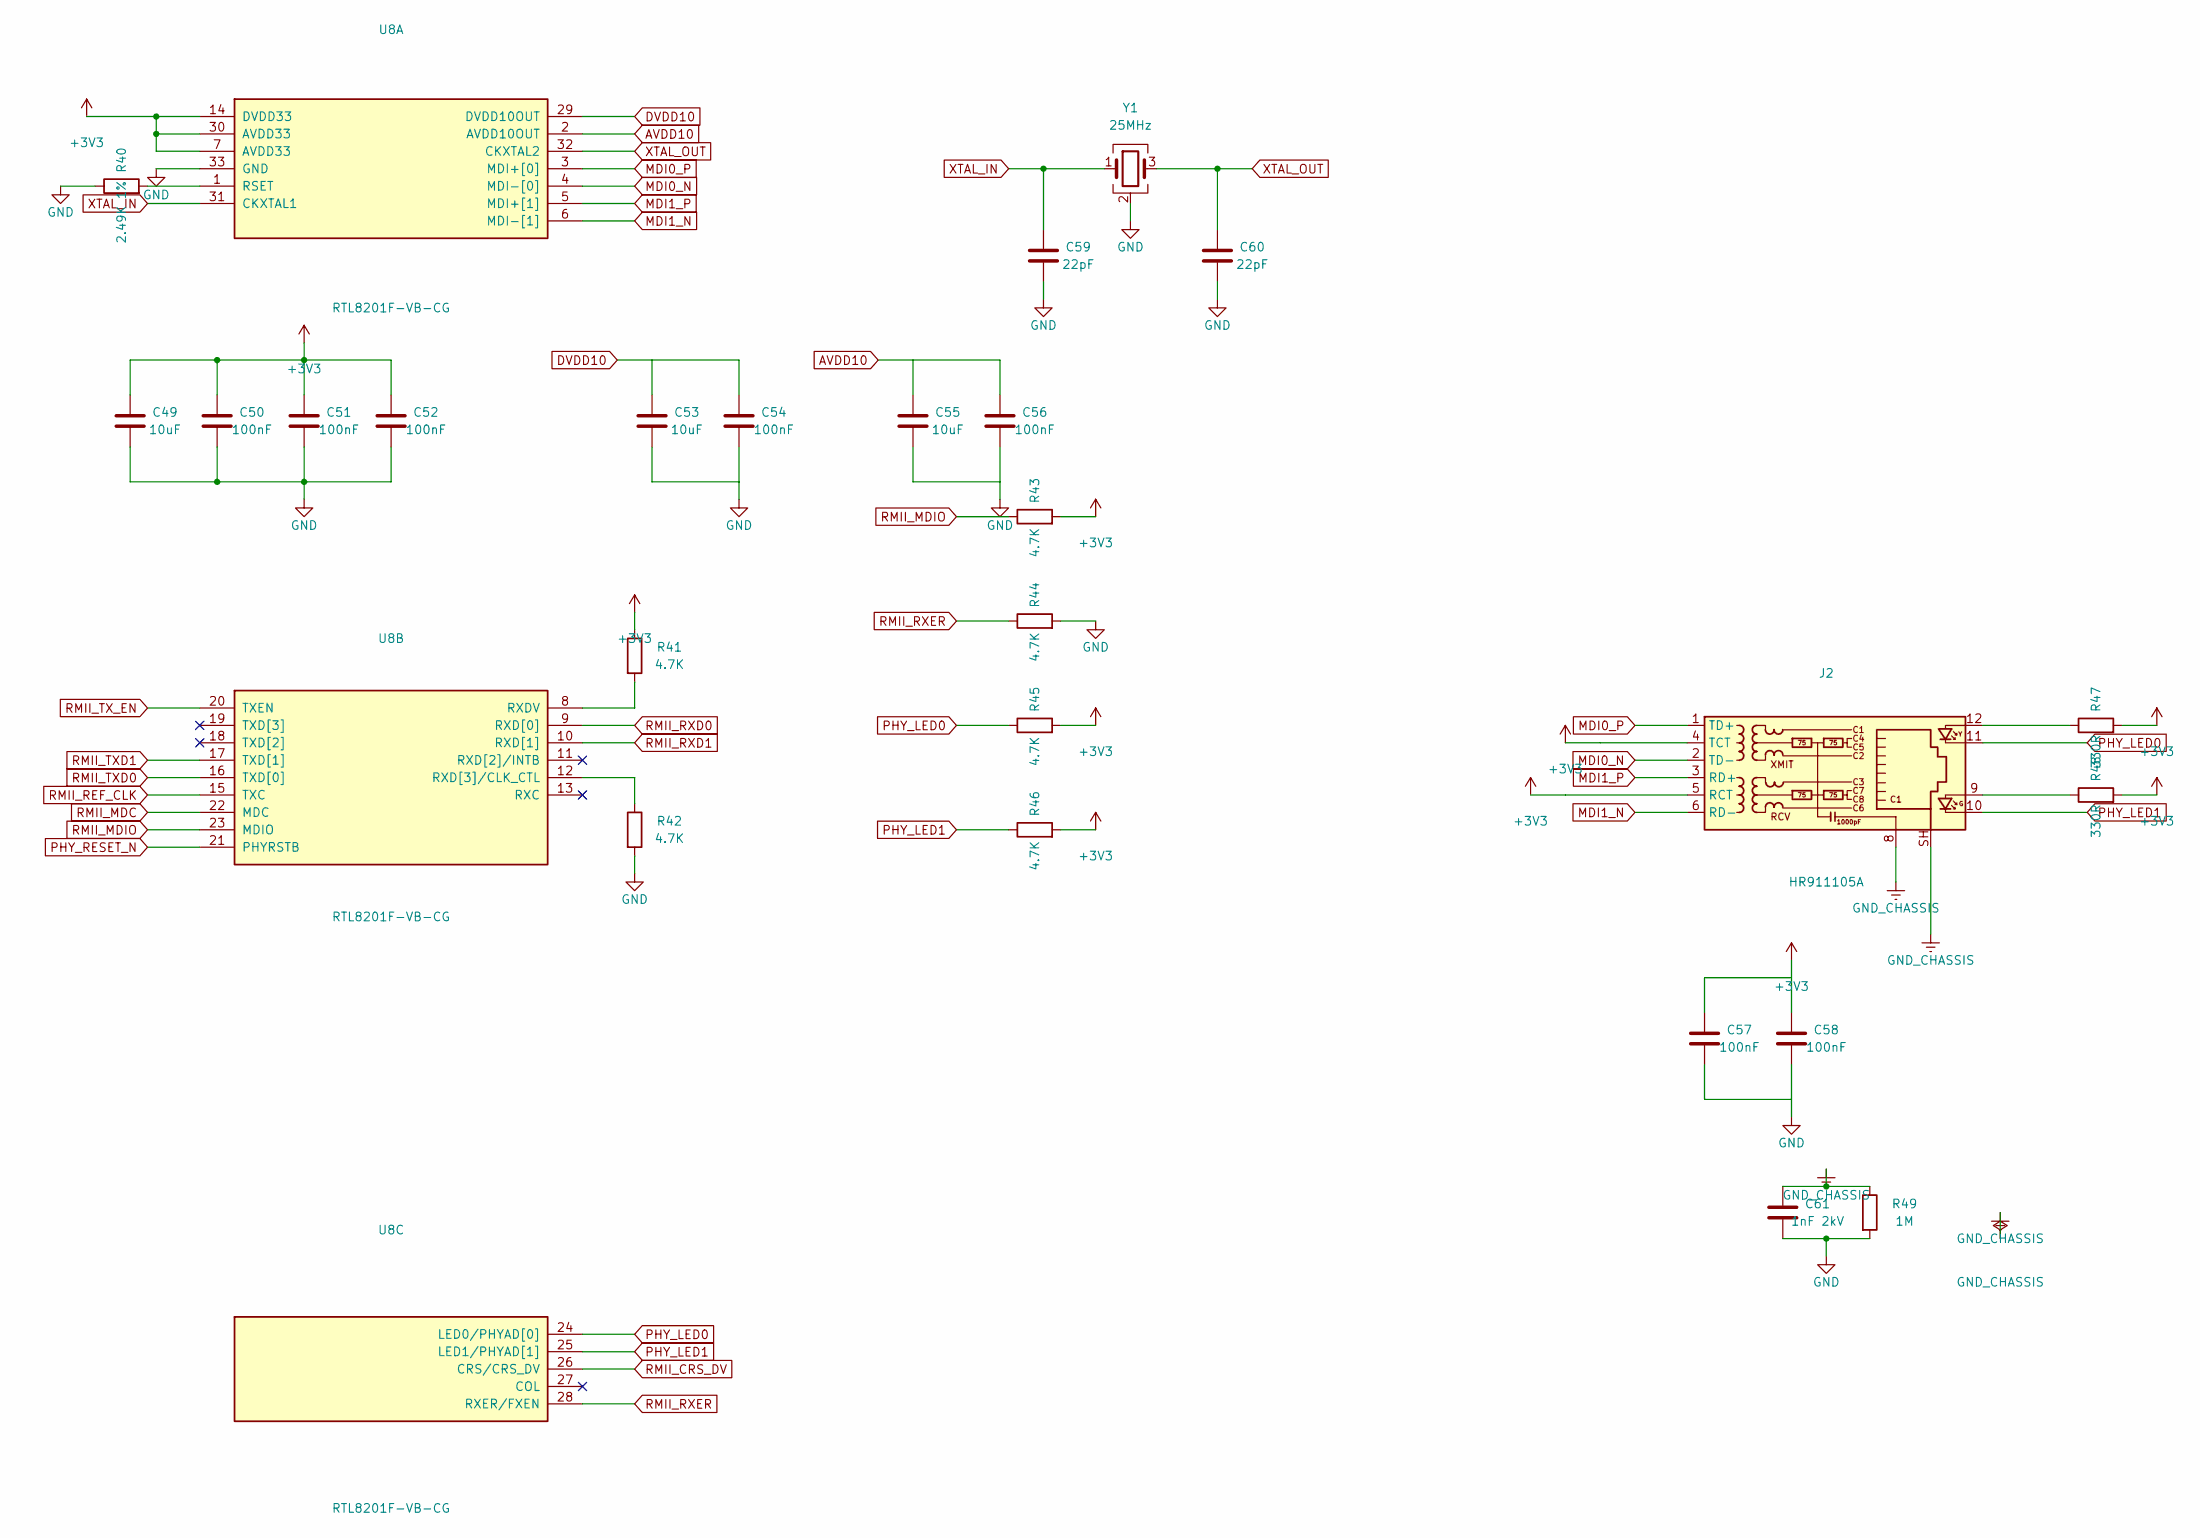
[picture p5: schematic net.kicad_sch]

Parts:
C49, C53, C55: 10uF; C_0603_1608Metric
C50, C51, C52, C54, C56, C57, C58: 100nF; C_0603_1608Metric
C59, C60: 22pF; C_0603_1608Metric
C61: 1nF 2kV; C_1206_3216Metric
J2: HR911105A; RJ45_Hanrun_HR911105A_Horizontal
R40: 2.49K 1%; R_0603_1608Metric
R41, R42, R43, R44, R45, R46: 4.7K; R_0603_1608Metric
R47, R48: 330R; R_0603_1608Metric
R49: 1M; R_0603_1608Metric
U8: RTL8201F-VB-CG; QFN-32-1EP_5x5mm_P0.5mm_EP3.3x3.3mm_ThermalVias
Y1: 25MHz; Crystal_SMD_3225-4Pin_3.2x2.5mm

Connections:
+3V3: C49.1, C50.1, C51.1, C52.1, C57.1, C58.1, J2.4 (TCT), J2.5 (RCT), R41.1, R43.2, R45.2, R46.2, R47.2, R48.2, U8.7 (AVDD33), U8.14 (DVDD33), U8.30 (AVDD33)
AVDD10: C55.1, C56.1, U8.2 (AVDD10OUT)
DVDD10: C53.1, C54.1, U8.29 (DVDD10OUT)
GND: C49.2, C50.2, C51.2, C52.2, C53.2, C54.2, C55.2, C56.2, C57.2, C58.2, C59.2, C60.2, C61.2, R40.1, R42.2, R44.2, R49.2, U8.33 (GND), Y1.2 (G), Y1.4 (G)
GND_CHASSIS: C61.1, J2.8, J2.SH, R49.1
MDI0_N: J2.2 (TD-), U8.4 (MDI-[0])
MDI0_P: J2.1 (TD+), U8.3 (MDI+[0])
MDI1_N: J2.6 (RD-), U8.6 (MDI-[1])
MDI1_P: J2.3 (RD+), U8.5 (MDI+[1])
unnamed: J2.9, R48.1
unnamed: J2.12, R47.1
unnamed: R40.2, U8.1 (RSET)
unnamed: R41.2, U8.8 (RXDV)
unnamed: R42.1, U8.12 (RXD[3]/CLK_CTL)
PHY_LED0: J2.11, R45.1, U8.24 (LED0/PHYAD[0])
PHY_LED1: J2.10, R46.1, U8.25 (LED1/PHYAD[1])
PHY_RESET_N: U8.21 (PHYRSTB)
RMII_CRS_DV: U8.26 (CRS/CRS_DV)
RMII_MDC: U8.22 (MDC)
RMII_MDIO: R43.1, U8.23 (MDIO)
RMII_REF_CLK: U8.15 (TXC)
RMII_RXD0: U8.9 (RXD[0])
RMII_RXD1: U8.10 (RXD[1])
RMII_RXER: R44.1, U8.28 (RXER/FXEN)
RMII_TXD0: U8.16 (TXD[0])
RMII_TXD1: U8.17 (TXD[1])
RMII_TX_EN: U8.20 (TXEN)
XTAL_IN: C59.1, U8.31 (CKXTAL1), Y1.1
XTAL_OUT: C60.1, U8.32 (CKXTAL2), Y1.3
