NickHuang0228/T113-DEV-V1/hardware/power.kicad_sch

## KiCad design hardware/power.kicad_sch (2026-10-12)

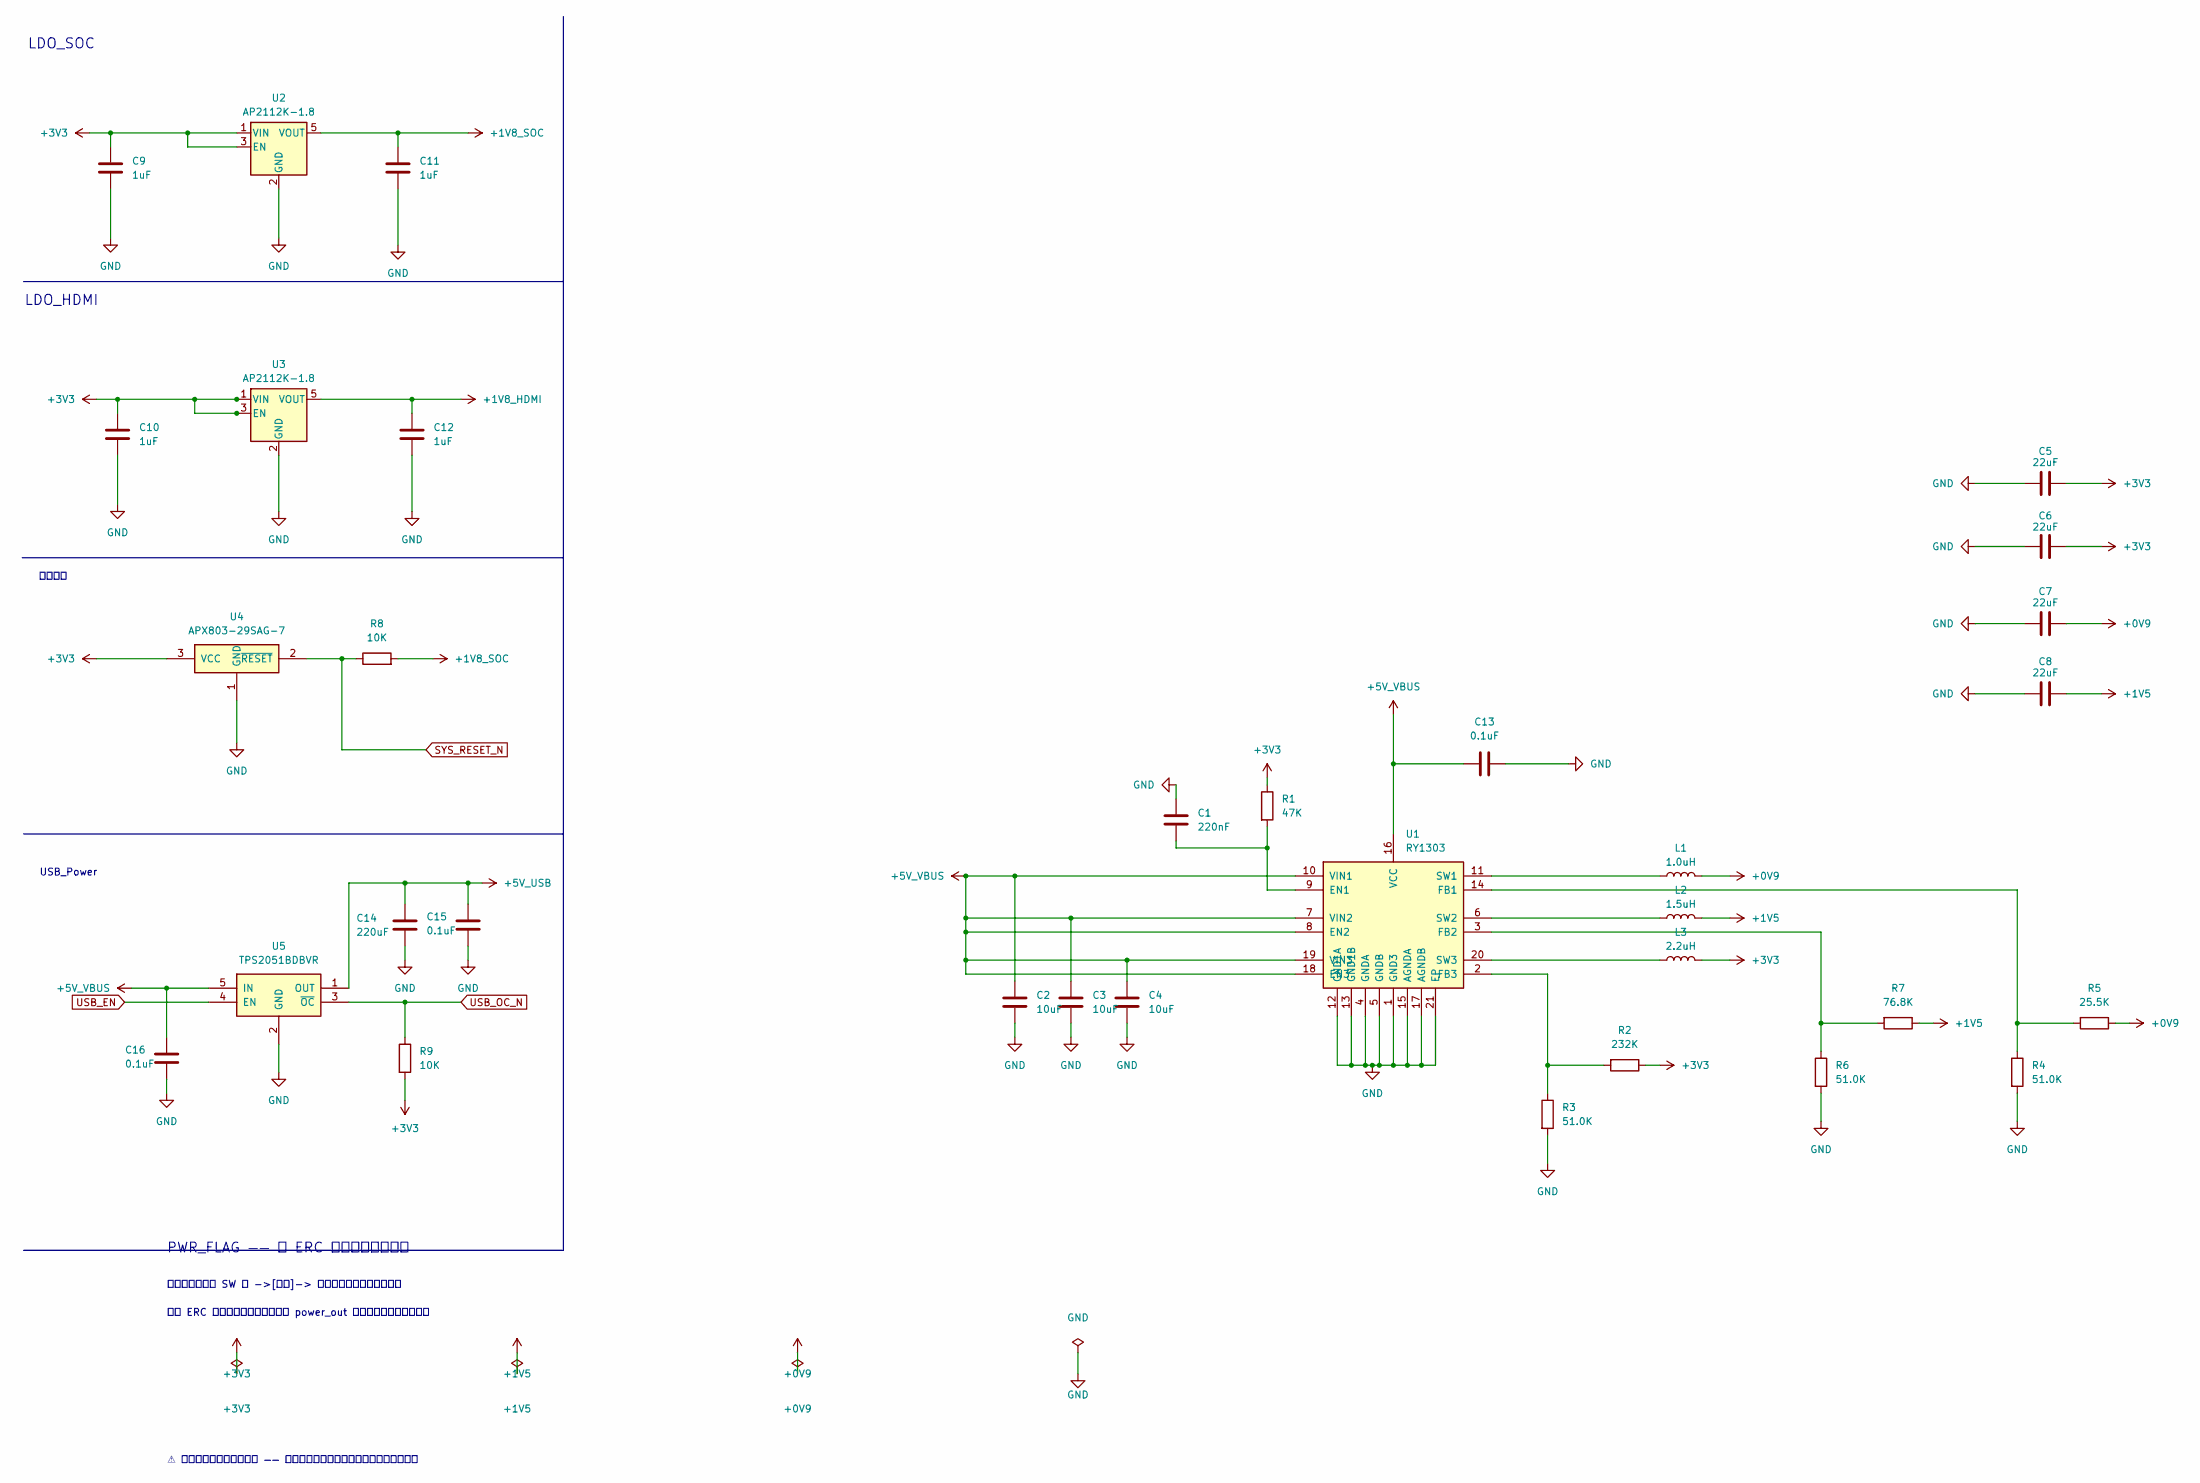
[picture p6: schematic power.kicad_sch]

Parts:
C1: 220nF; C_0603_1608Metric
C2, C3, C4: 10uF; C_0603_1608Metric
C5, C6, C7, C8: 22uF; C_0805_2012Metric
C9, C10, C11, C12: 1uF; C_0603_1608Metric
C13, C15, C16: 0.1uF; C_0603_1608Metric
C14: 220uF; CP_Elec_6.3x7.7
L1: 1.0uH; L_Changjiang_FNR4020S
L2: 1.5uH; L_Changjiang_FNR4020S
L3: 2.2uH; L_Changjiang_FNR4020S
R1: 47K; R_0603_1608Metric
R2: 232K; R_0603_1608Metric
R3, R4, R6: 51.0K; R_0603_1608Metric
R5: 25.5K; R_0603_1608Metric
R7: 76.8K; R_0603_1608Metric
R8, R9: 10K; R_0603_1608Metric
U1: RY1303; UQFN-20-1EP_3x3mm_P0.4mm_EP1.7x1.7mm_ThermalVias
U2, U3: AP2112K-1.8; SOT-23-5
U4: APX803-29SAG-7; SOT-23
U5: TPS2051BDBVR; SOT-23-5

Connections:
+0V9: C7.2, L1.2, R5.1
+1V5: C8.2, L2.2, R7.1
+1V8_HDMI: C12.1, U3.5 (VOUT)
+1V8_SOC: C11.1, R8.2, U2.5 (VOUT)
+3V3: C5.2, C6.2, C9.1, C10.1, L3.2, R1.1, R2.1, R9.2, U2.1 (VIN), U2.3 (EN), U3.1 (VIN), U3.3 (EN), U4.3 (VCC)
+5V_USB: C14.1, C15.1, U5.1 (OUT)
+5V_VBUS: C2.1, C3.1, C4.1, C13.1, C16.1, U1.7 (VIN2), U1.8 (EN2), U1.10 (VIN1), U1.16 (VCC), U1.18 (EN3), U1.19 (VIN3), U5.5 (IN)
GND: C1.1, C2.2, C3.2, C4.2, C5.1, C6.1, C7.1, C8.1, C9.2, C10.2, C11.2, C12.2, C13.2, C14.2, C15.2, C16.2, R3.2, R4.2, R6.2, U1.1 (GND3), U1.4 (GNDA), U1.5 (GNDB), U1.12 (GND1A), U1.13 (GND1B), U1.15 (AGNDA), U1.17 (AGNDB), U1.21 (EP), U2.2 (GND), U3.2 (GND), U4.1 (GND), U5.2 (GND)
unnamed: C1.2, R1.2, U1.9 (EN1)
unnamed: L1.1, U1.11 (SW1)
unnamed: L2.1, U1.6 (SW2)
unnamed: L3.1, U1.20 (SW3)
unnamed: R2.2, R3.1, U1.2 (FB3)
unnamed: R4.1, R5.2, U1.14 (FB1)
unnamed: R6.1, R7.2, U1.3 (FB2)
SYS_RESET_N: R8.1, U4.2 (~RESET)
USB_EN: U5.4 (EN)
USB_OC_N: R9.1, U5.3 (~OC)

Notes on the sheet:
監測電源
LDO_SOC
USB_Power
LDO_HDMI
PWR_FLAG —— 給 ERC 看的，不是真元件
降壓器的輸出走 SW 腳 ->[電感]-> 輸出節點，電感是被動件，
所以 ERC 在輸出節點上找不到任何 power_out 腳，判定「沒人驅動」。
⚠ 只能用在確實有電的地方 —— 拿它蓋掉真的沒接的軌等於把安全網剪掉。
