NickHuang0228/T113-DEV-V1/hardware/storage.kicad_sch

## KiCad design hardware/storage.kicad_sch (2026-10-12)

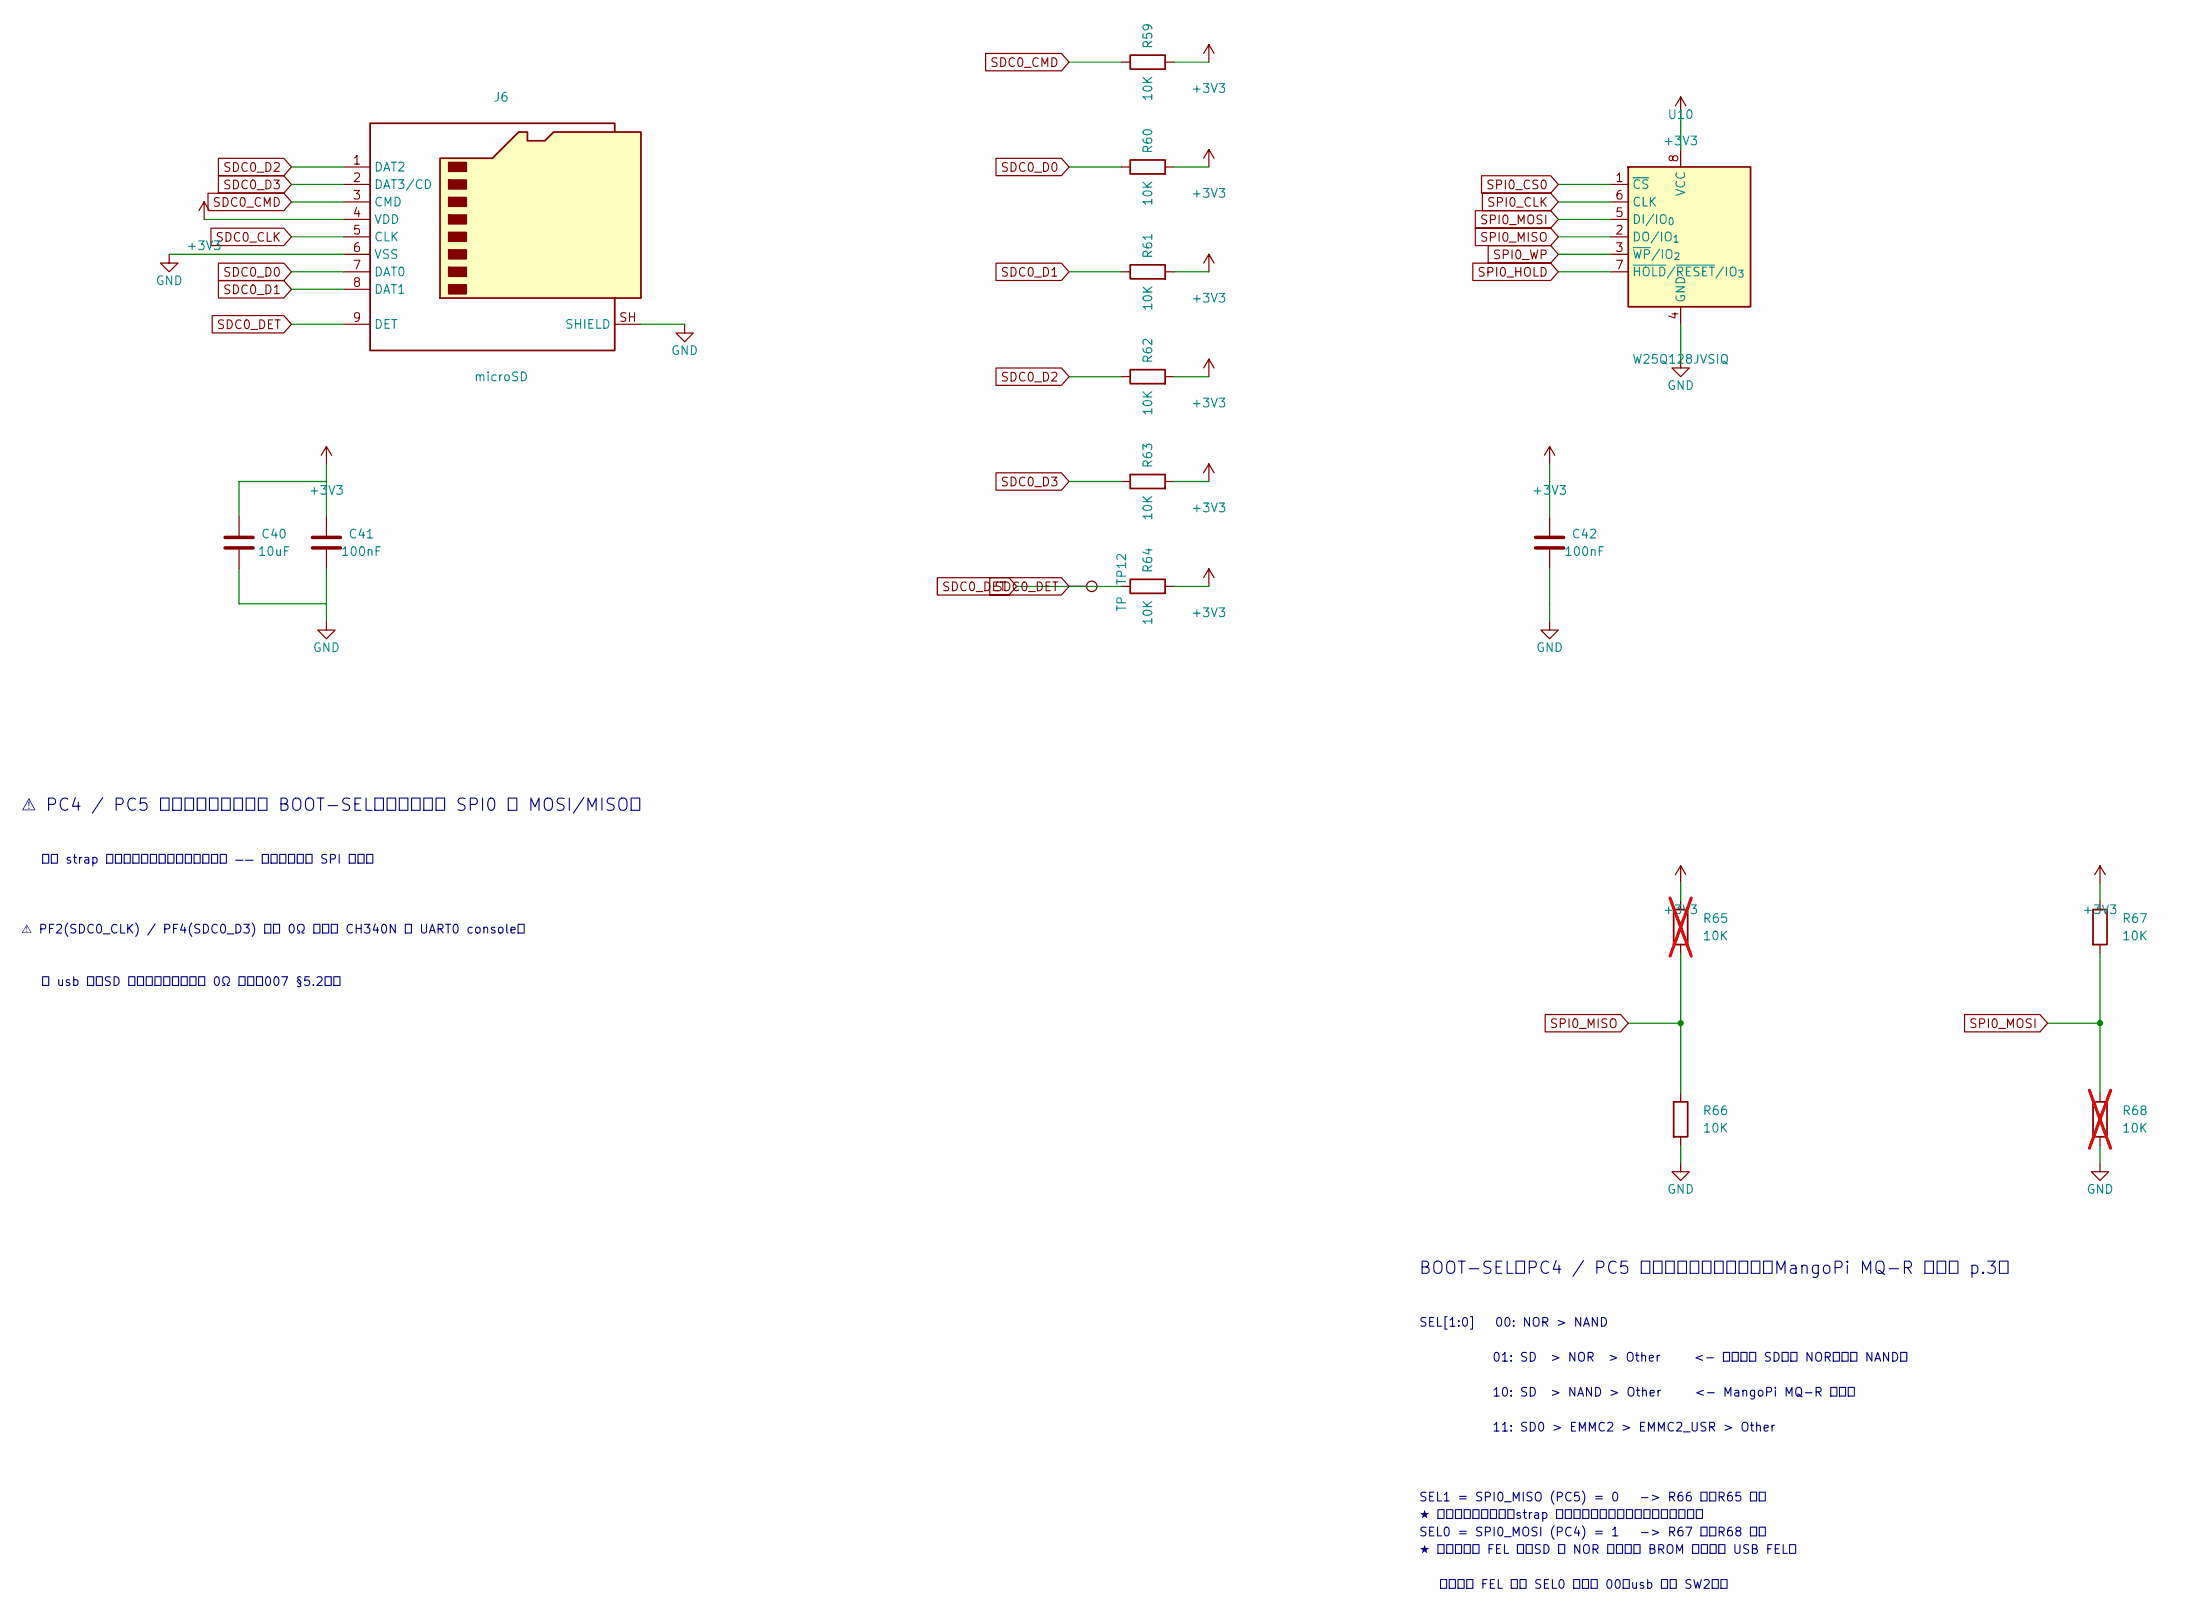
[picture p7: schematic storage.kicad_sch]

Parts:
C40: 10uF; C_0805_2012Metric
C41, C42: 100nF; C_0603_1608Metric
J6: microSD; microSD_HC_Hirose_DM3D-SF
R59, R60, R61, R62, R63, R64, R66, R67: 10K; R_0603_1608Metric
R65, R68: 10K; R_0603_1608Metric; not fitted
TP12: TP; TestPoint_Pad_D1.5mm
U10: W25Q128JVSIQ; SOIC-8_5.3x5.3mm_P1.27mm

Connections:
+3V3: C40.1, C41.1, C42.1, J6.4 (VDD), R59.2, R60.2, R61.2, R62.2, R63.2, R64.2, R65.1, R67.1, U10.8 (VCC)
GND: C40.2, C41.2, C42.2, J6.6 (VSS), J6.SH (SHIELD), R66.2, R68.2, U10.4 (GND)
SDC0_CLK: J6.5 (CLK)
SDC0_CMD: J6.3 (CMD), R59.1
SDC0_D0: J6.7 (DAT0), R60.1
SDC0_D1: J6.8 (DAT1), R61.1
SDC0_D2: J6.1 (DAT2), R62.1
SDC0_D3: J6.2 (DAT3/CD), R63.1
SDC0_DET: J6.9 (DET), R64.1, TP12.1
SPI0_CLK: U10.6 (CLK)
SPI0_CS0: U10.1 (~CS)
SPI0_HOLD: U10.7 (~HOLD/~RESET/IO_{3})
SPI0_MISO: R65.2, R66.1, U10.2 (DO/IO_{1})
SPI0_MOSI: R67.2, R68.1, U10.5 (DI/IO_{0})
SPI0_WP: U10.3 (~WP/IO_{2})

Notes on the sheet:
BOOT-SEL（PC4 / PC5 上電瞬間的電平，來源：MangoPi MQ-R 原理圖 p.3）
SEL[1:0] 00: NOR > NAND
01: SD > NOR > Other <- 本板（有 SD、有 NOR、沒有 NAND）
10: SD > NAND > Other <- MangoPi MQ-R 用這個
11: SD0 > EMMC2 > EMMC2_USR > Other
SEL1 = SPI0_MISO (PC5) = 0 -> R66 焊、R65 不焊
SEL0 = SPI0_MOSI (PC4) = 1 -> R67 焊、R68 不焊
★ 兩個位置都留焊盤：strap 改設定要動焊接，不留位置就得飛線。
★ 不需要專用 FEL 腳：SD 與 NOR 都失敗時 BROM 自己落到 USB FEL。
要強制進 FEL 就把 SEL0 拉低變 00（usb 頁的 SW2）。
⚠ PC4 / PC5 一腳兩用：上電時是 BOOT-SEL，之後才切成 SPI0 的 MOSI/MISO。
量測 strap 電平要抓上電那一刻，不是穩態 —— 穩態量到的是 SPI 波形。
⚠ PF2(SDC0_CLK) / PF4(SDC0_D3) 另有 0Ω 分支到 CH340N 當 UART0 console，
見 usb 頁。SD 跑不穩時先拆那兩顆 0Ω 定位（007 §5.2）。
