NickHuang0228/T113-DEV-V1/hardware/usb.kicad_sch

## KiCad design hardware/usb.kicad_sch (2026-10-12)

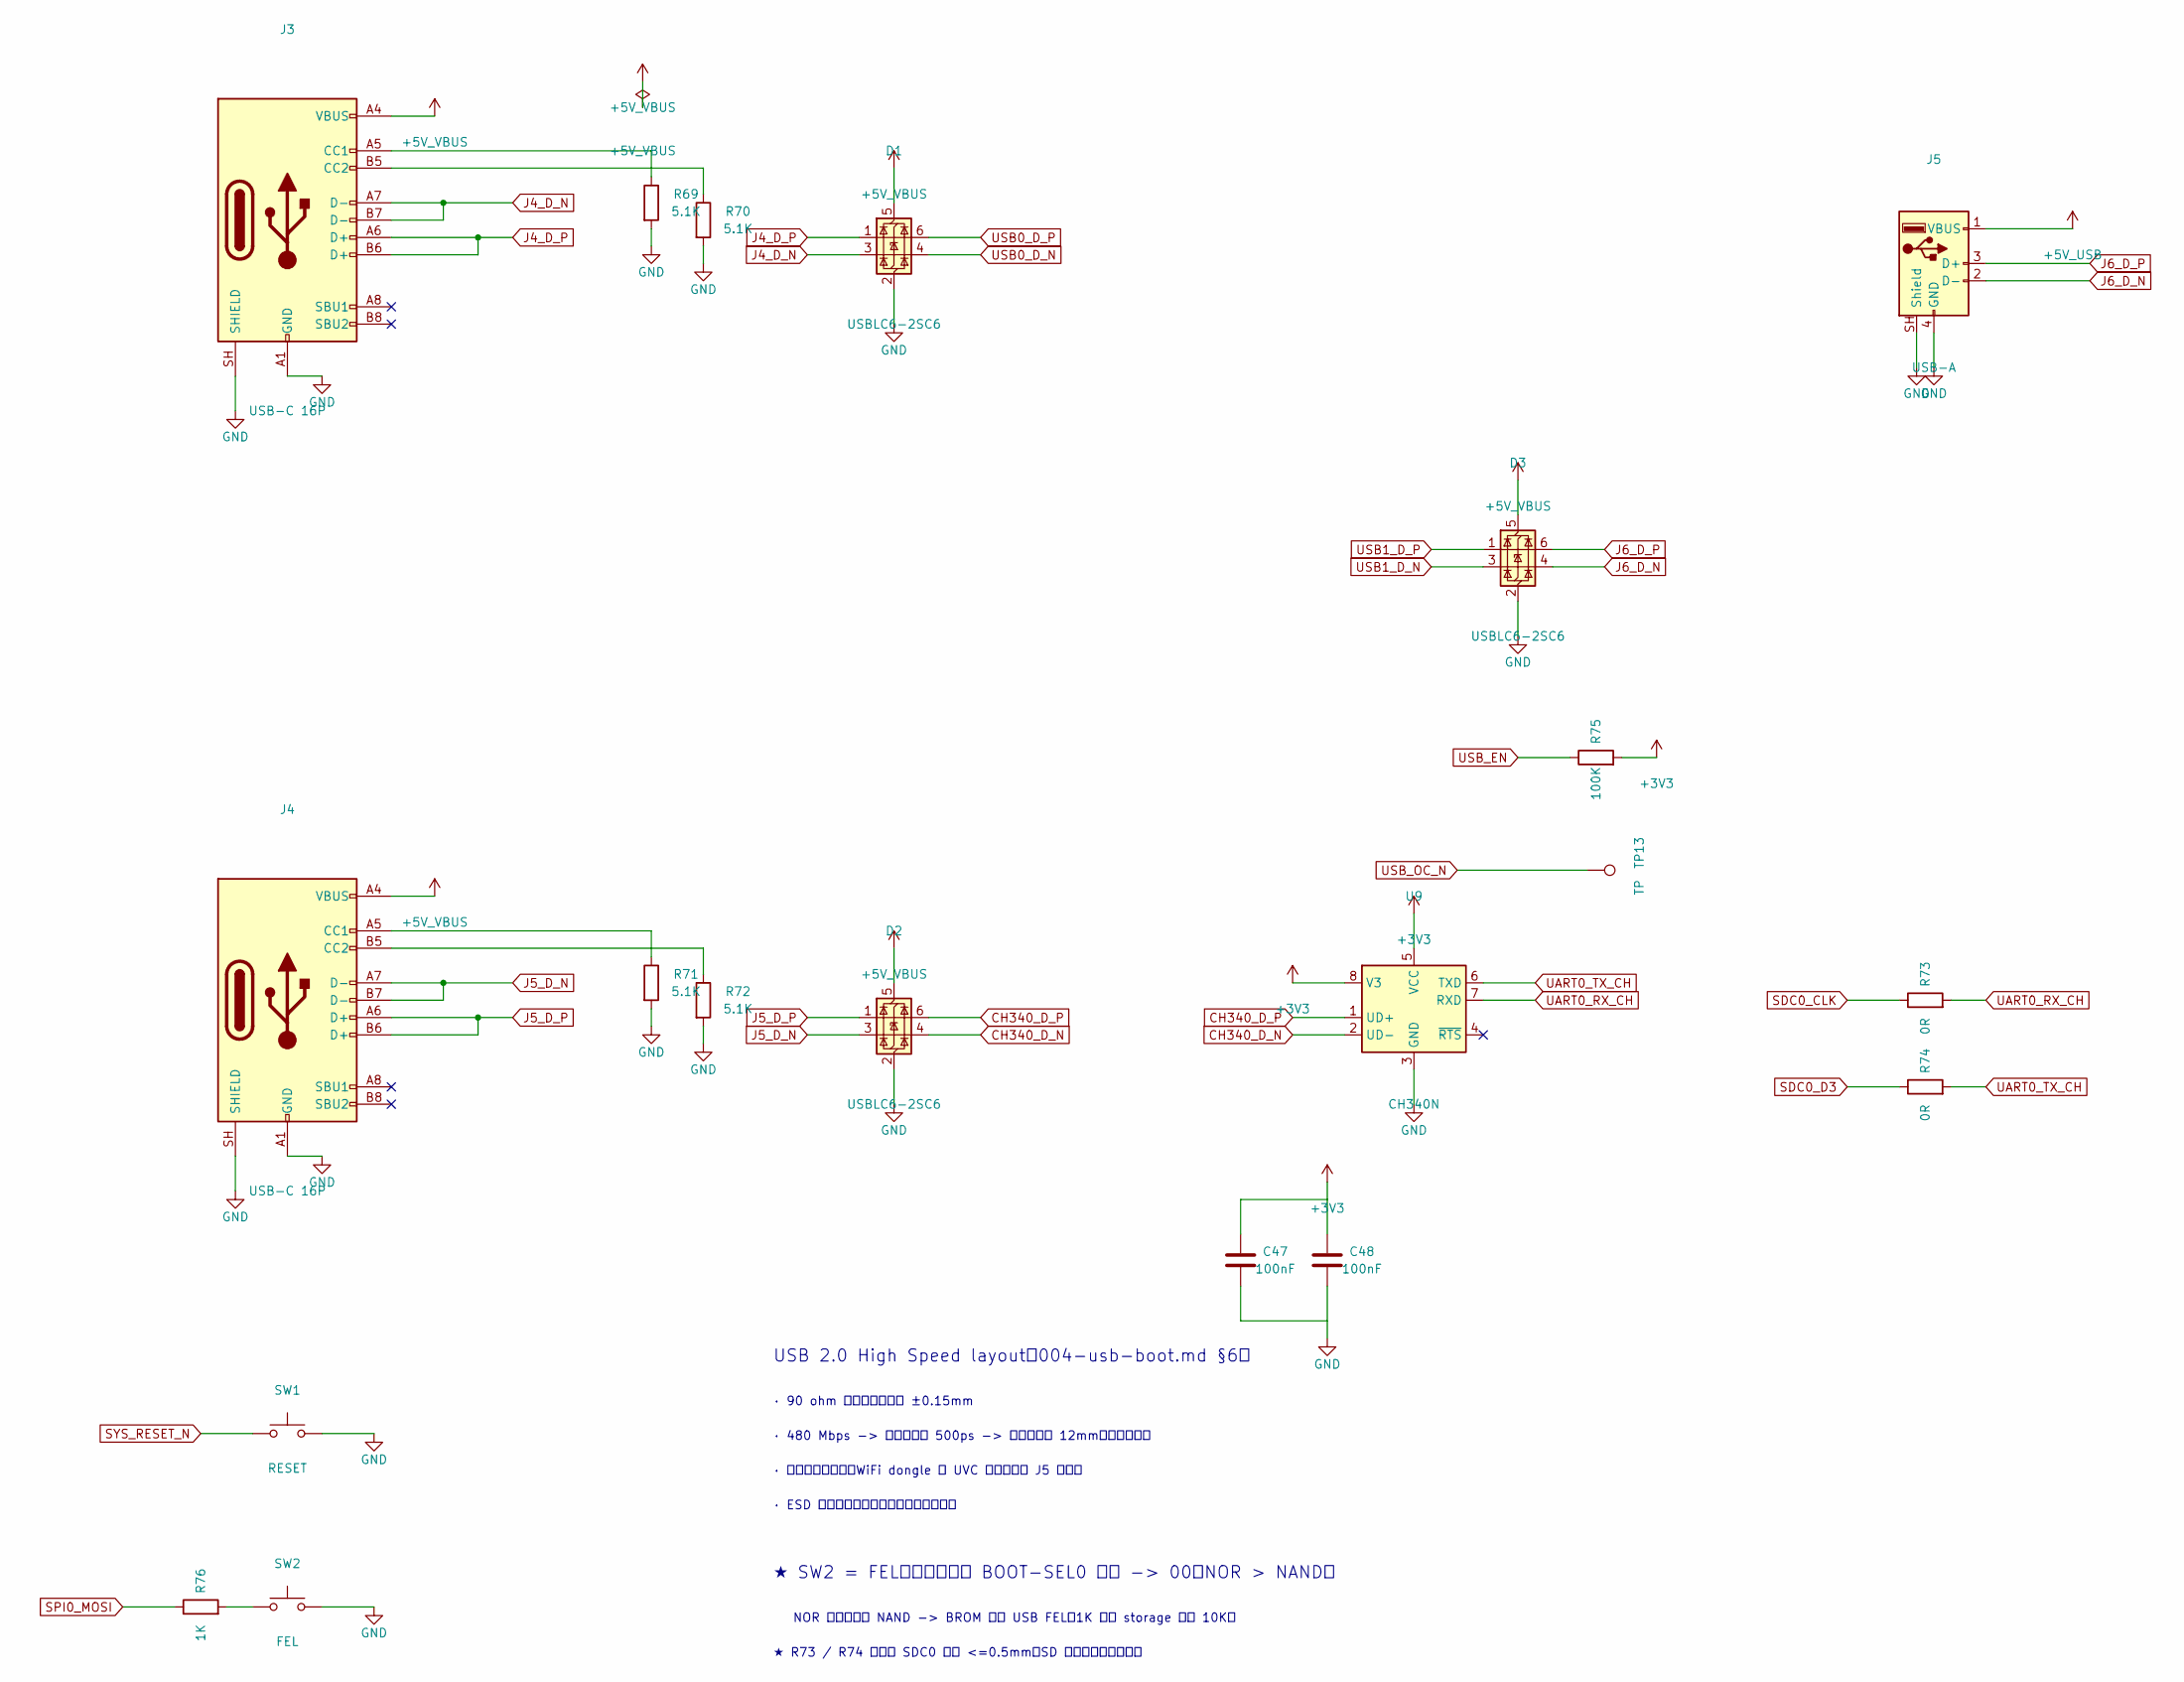
[picture p8: schematic usb.kicad_sch]

Parts:
C47, C48: 100nF; C_0603_1608Metric
D1, D2, D3: USBLC6-2SC6; SOT-23-6
J3, J4: USB-C 16P; USB_C_Receptacle_HCTL_HC-TYPE-C-16P-01A
J5: USB-A; USB_A_Connfly_DS1095
R69, R70, R71, R72: 5.1K; R_0603_1608Metric
R73, R74: 0R; R_0603_1608Metric
R75: 100K; R_0603_1608Metric
R76: 1K; R_0603_1608Metric
SW1: RESET; SW_SPST_B3U-1000P-B
SW2: FEL; SW_SPST_B3U-1000P-B
TP13: TP; TestPoint_Pad_D1.5mm
U9: CH340N; JEITA_SOIC-8_3.9x4.9mm_P1.27mm

Connections:
+3V3: C47.1, C48.1, R75.2, U9.5 (VCC), U9.8 (V3)
+5V_USB: J5.1 (VBUS)
+5V_VBUS: D1.5 (VBUS), D2.5 (VBUS), D3.5 (VBUS), J3.A4 (VBUS), J3.A9 (VBUS), J3.B4 (VBUS), J3.B9 (VBUS), J4.A4 (VBUS), J4.A9 (VBUS), J4.B4 (VBUS), J4.B9 (VBUS)
CH340_D_N: D2.4 (I/O2), U9.2 (UD-)
CH340_D_P: D2.6 (I/O1), U9.1 (UD+)
GND: C47.2, C48.2, D1.2 (GND), D2.2 (GND), D3.2 (GND), J3.A1 (GND), J3.A12 (GND), J3.B1 (GND), J3.B12 (GND), J3.SH (SHIELD), J4.A1 (GND), J4.A12 (GND), J4.B1 (GND), J4.B12 (GND), J4.SH (SHIELD), J5.4 (GND), J5.SH (Shield), R69.2, R70.2, R71.2, R72.2, SW1.2, SW2.2, U9.3 (GND)
J4_D_N: D1.3 (I/O2), J3.A7 (D-), J3.B7 (D-)
J4_D_P: D1.1 (I/O1), J3.A6 (D+), J3.B6 (D+)
J5_D_N: D2.3 (I/O2), J4.A7 (D-), J4.B7 (D-)
J5_D_P: D2.1 (I/O1), J4.A6 (D+), J4.B6 (D+)
J6_D_N: D3.4 (I/O2), J5.2 (D-)
J6_D_P: D3.6 (I/O1), J5.3 (D+)
unnamed: J3.A5 (CC1), R69.1
unnamed: J3.B5 (CC2), R70.1
unnamed: J4.A5 (CC1), R71.1
unnamed: J4.B5 (CC2), R72.1
unnamed: R76.2, SW2.1
SDC0_CLK: R73.1
SDC0_D3: R74.1
SPI0_MOSI: R76.1
SYS_RESET_N: SW1.1
UART0_RX_CH: R73.2, U9.7 (RXD)
UART0_TX_CH: R74.2, U9.6 (TXD)
USB0_D_N: D1.4 (I/O2)
USB0_D_P: D1.6 (I/O1)
USB1_D_N: D3.3 (I/O2)
USB1_D_P: D3.1 (I/O1)
USB_EN: R75.1
USB_OC_N: TP13.1

Notes on the sheet:
USB 2.0 High Speed layout（004-usb-boot.md §6）
· 90 ohm 差分，對內等長 ±0.15mm
· 480 Mbps -> 上升時間約 500ps -> 臨界長度約 12mm，必須控阻抗
· 三對都要認真做：WiFi dongle 與 UVC 攝影機都走 J5 那一對
· ESD 元件擺在接頭與晶片之間，貼近接頭
★ SW2 = FEL：按住上電把 BOOT-SEL0 拉低 -> 00（NOR > NAND）
NOR 空的、沒有 NAND -> BROM 落到 USB FEL。1K 壓贏 storage 頁的 10K。
★ R73 / R74 焊盤距 SDC0 主幹 <=0.5mm；SD 跑不穩先拆這兩顆。
