NickHuang0228/T113-DEV-V1/(commit log)

2026-09-18 專案成立:T113-S3 Linux 開發板規格定案
    第二塊自畫板,從「模組+單電壓+1對差分」跳到「裸 SoC+4組電壓+13對差分+Linux」。
    選型:T113-S3 內建 128MB DDR3(SIP),第一塊 Linux 板最大的風險直接刪除;
    QFP128 腳位外露可自行除錯;有 MIPI DSI,符合長期目標。
    H3 查 datasheet 第 59-60 頁後否決 —— Display Output 只有 HDMI 與 CVBS,
    沒有 RGB 並列、沒有 LVDS、沒有 MIPI DSI。
    介面:MIPI DSI 4-lane / RGB→IT66121→HDMI / RMII→RTL8201F→RJ45 /
    Type-C ×2(OTG+FEL、CH340N UART) / USB-A Host / microSD / SPI NOR
    成本估 $154 ≈ NT$4,960(PCB 5片 + PCBA 2片 + 運費)
    文件:SPEC、ROADMAP、五份設計筆記(電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
2026-09-18 組裝策略定案:貼 1 片 + 自焊 2 片;WiFi 畫但不焊
    組裝(新增 006-assembly.md)
    三種配置算完,選「貼 1 片 + 自焊 2 片」$126 ≈ NT$4,060。
    中間那個最貴但選它 —— 理由不是錢是除錯:有一片確定焊得好的板子,
    它不開機就一定是設計問題,不是虛焊。
    零件另從 LCSC 買(JLCPCB 不退剩料),兩邊同屬嘉立創可合併運費。
    鋼網 $8 必加 —— 0.4mm pitch 手工上錫膏不可能均勻。
    工具
    好烙鐵 > 熱風槍 > 加熱台。
    加熱台有面積限制:MHP50 只有 50×50mm,板子是 100×100mm,
    要整片回流得買 NT$3,000~6,000 的設備,對照 JLCPCB 貼一片 NT$1,450 不划算。
    QFN 該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
2026-09-18 讀完 datasheet:五個假設被推翻,規格連動修正
    取得 T113-S3 datasheet v1.6 / User Manual v1.1+v1.3 / MangoPi MQ-R 原理圖 /
    RTL8201F / CH340 / IT66121 datasheet,全部放 docs/reference/。
    被推翻的假設(全部附 datasheet 頁碼出處):
    1. 核心電壓 1.1V -> 實際 0.9V (Table 5-2 p.45),原設計超壓 22%
    2. 電源樹漏了 1.5V 的 VCC-DRAM ——「內建 DDR3」不等於「不用供電給 DDR3」
    3. IT66121 是 LQFP64 -> 實際 QFN64 9x9 + 底部 GND pad
    4. RGB 是 24-bit 28 條 -> 實際 RGB666 18-bit 22 條 (Table 4-3 / 2.6.1 p.6)
    5. MIPI 與 RGB「dts 二選一」-> 實際共用同一組實體接腳 PD0~PD9
    新發現:
    - EPAD (pin 129) 是這顆晶片唯一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
2026-09-18 機構圖確認:EPAD 5.72x5.72,含腳佔位 16mm,KiCad MS-026 BEE 可用
    用 pymupdf 高 dpi render datasheet p.78(PDF p.88)讀機構圖 ——
    向量圖,pdftotext 抽不到表格數字。
    新增 docs/design/008-footprint.md:完整尺寸表 + EPAD 判讀 + footprint 做法 + 驗收。
    關鍵發現:
    1. Exposed Pad 機構圖上有「六組」選項,不是兩組。CAUTION 指定第②組 = 5.72 REF(正方形)。
    ⚠ 第⑥組也是 5.72 開頭但為長方形 5.72/5.46 —— 只看到「5.72」有 50% 機率選錯。
    分辨:CAUTION 的「5.72 mm REF or 0.225 mm REF」,or 連的是 mm 與 inch 兩種寫法。
    2. 元件佔位是 16x16mm 不是 14x14mm。DS 2.12 寫的 14mm 是本體 D1/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
2026-09-18 周邊 IC 機構圖:IT66121 QFN-64 / RTL8201F QFN-32,KiCad 標準件可直接用
    更正:先前記「IT66121 只有 8 頁公開簡版、無機構圖」是錯的。
    file 指令把頁數讀成 8,實際是 40 頁完整版,Figure 17 機構圖在 p.40。
    IT66121FN QFN-64 9x9mm pitch 0.50 EPAD 3.78x3.78
    -> QFN-64-1EP_9x9mm_P0.5mm_EP3.8x3.8mm_ThermalVias
    RTL8201F QFN-32 5x5mm pitch 0.50 EPAD 3.35x3.35 JEDEC MO-220
    -> QFN-32-1EP_5x5mm_P0.5mm_EP3.3x3.3mm_ThermalVias
    選 EP3.3 而非 EP3.45:land 取略小於標稱值較安全
    ⚠ RTL8201F 的 datasheet 涵蓋三種封裝,別拿錯章節:
    10.1 p.55 RTL8201F QFN-32(用這個) / 10.2 LQFP-48 / 10.3 QFN-48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
2026-09-19 抽出完整 128 腳位表,炸出三個 mux 衝突
    方法突破
    Table 4-2 先前記為「ball# 與 pin name 對不上,不可用」——
    問題不在 datasheet,在抽取方法。
    get_text() 依文字座標重建欄位會跑位;page.find_tables() 依繪製線框切格子不會。
    一次抽出 128 列,無缺號無重複,且與人工核的數字完全吻合
    (I/O 102 / Power 21+3 / GND 1 / NC 1)。
    規則升級:有線框的表格用 find_tables(),沒線框的才退回看圖。
    新增
    tools/t113s3_pins.csv 128 腳完整表,KiCad 符號的直接輸入
    tools/extract_pins.py 產生腳本,可重跑
    三個衝突(007 §5.1~5.4)
    ① PB0/PB1 此封裝未引出 —— GPIOB 只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
    [t113s3_pins.csv]
2026-09-20 顯示鏈路查完:五個錯誤修正,電源域 4 組改 5 組
    階段 0 剩下的 TCON / lane rate / pixel clock 三項查完,順帶翻出五個問題。
    已確認的數字
    TCON 2 組:TCON_LCD(RGB/LVDS/DSI 共用) + TCON_TV(CVBS)
    RGB pixel clock 上限 200MHz (tDCLK min 5ns, DS Table 5-18 p.61)
    IT66121 上限 165MHz → 瓶頸在橋接晶片,1080p60 的 148.5MHz 兩邊都過
    MIPI lane rate:DS 與 UM 都沒公布,layout 照 1.5Gbps 規格做
    修正的錯誤
    1. 002-display.md 把 R 與 B 標反(正確:PD0~PD5=B、PD12~PD17=R)
    規則:原理圖標 LCD0-D 編號不標顏色,兩顆晶片 D 索引一致
    2. 「T113 沒有 RGB888」不成立 —— 缺的 6 bit 在 PB2~PB7,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
2026-09-20 BOM 料況查證:IT66121 停產,T113 實價是估價的 2.8 倍
    階段 0 最後一項查完。用 JLCPCB 零件搜尋 API 逐顆查(LCSC/JLCPCB 網頁需 JS,
    WebFetch 抓不到;API 回傳 JSON 且與 LCSC 網頁價格一致)。
    阻塞項
    IT66121FN C2684803 庫存 0,noBuyReason = "no longer manufactured"
    這不是缺貨是停產。002-display.md 選它的唯一理由是 mainline driver
    替代方案(並列 RGB 輸入 + 有貨)
    ADV7511KSTZ C179459 LQFP-100 57顆 $13.75 mainline adv7511
    ⚠ 視訊輸入腳電平未確認,可能推翻 VCC-PD=3.3V 的決定
    TFP410PAPR C7498519 HTQFP-64 142顆 $6.28 mainline ti-tfp410,但 DVI only
    MS7210 C2914249 QFN-64-EP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
2026-09-20 橋接晶片改用 ADV7511:IT66121 停產,且選型判準已變
    判準改變(這是主因,不只是換料)
    原判準:「第一塊板不在 driver 上冒險」→ 挑 driver 最省事的
    新目標:HDMI/DP kernel driver porting 與 IC 驗證
    → driver 工作本身就是要練的東西,省事等於沒練到
    → 原本推薦的 TFP410(DVI serializer,連 I2C 都沒有)在新判準下變最差
    選定 ADV7511KSTZ C179459 $13.75 庫存 57
    mainline drivers/gpu/drm/bridge/adv7511/,驗證面涵蓋
    EDID/HPD/HDCP/audio(N,CTS)/InfoFrame/CEC/CSC
    sun4i_rgb.c 原生支援掛 drm_bridge,porting 有骨架
    同目錄含 adv7533/35(DSI→HDMI),本板的 MIPI 可練第二條路徑
    連鎖影響(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
2026-09-20 收尾:清掉 1.2V 的殘留條目,1.8V LDO 選型定案
2026-09-20 ADV7511 原廠規格取得:它沒有 EPAD,我前一輪寫錯了
    ADI 封鎖所有自動下載(curl/PowerShell/WebFetch/六個鏡像站/瀏覽器下載鈕
    /blob download 全失敗)。改用在 analog.com 頁面注入 pdf.js 抽文字層,
    整理成 docs/reference/peripherals/ADV7511KSTZ_extracted.md。
    原始 PDF 檔仍未存檔,檔頭已註明這是替代品不是等價物。
    ⚠ 推翻前一個 commit 的結論
    前一輪寫 ADV7511「LQFP-100 含 EPAD」,依據是 ADV7511W 的硬體指南。
    但 W 版是完全不同的封裝:
    KSTZ 100-lead LQFP ST-100 MS-026-BED 14x14 無 EPAD D[35:0]
    W 64-lead LQFP_EP SW-64-2 MS-026-BCD 10x10 有 EPAD D[23:0]
    我當時還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
2026-09-20 ADV7511 原始 PDF 入庫,補完腳位表與 layout 建議
    檔案:docs/reference/peripherals/ADV7511_Hardware_Users_Guide.pdf
    846,967 bytes / 58 頁 / Rev D —— 與瀏覽器 fetch 的位元組數一致
    由使用者手動按下載鈕取得。先前用 PowerShell Win32 API
    (AttachThreadInput + SetForegroundWindow) 把 Chrome 視窗叫到前景並切好分頁。
    結論:Chrome 不接受 CDP 合成點擊作為觸發下載的真人手勢
    自動化能叫視窗、能切分頁、能點中按鈕(圖示反白),最後一下必須真人
    正確流程是 pdf.js 抽數字解阻塞 + 請使用者按一下收檔,兩件事並行
    完整腳位表(Table 3, p.19-20)挖出五個原理圖地雷
    1. R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
2026-09-20 讀完 Figure 6/23/24/27:腳位級接線表定案,1.8V 要拆成兩條
    四項待辦完成。都是圖不是表,只能 render 高 dpi 用看的。
    Figure 6 (p.18) D[35:0] 腳號 —— 不能用連號推,pin 79(CLK) 夾在中間
    右側 57 D35→74 D18;頂側 78 D17 · 79 CLK · 80 D16→96 D0 · 97 DE · 98 HSYNC
    左側 2 VSYNC
    → RGB666 接線表已定案到腳位級(002-display.md §3.2)
    ⚠ 帶出 placement 問題:ADV7511 的 RGB 跨三個邊
    頂側 81~94 = PD0~PD11(B+G) · 右側 69~74 = PD12~PD17(R) · 左側 pin2 = VSYNC
    T113 那側 22 條連續,ADV7511 這側要分三束
    ADV7511 的旋轉角度決定三束會不會打架
    好消息:MIPI 共用的 PD0~PD9 全在頂側 83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
2026-09-20 更正:PDF 依專案政策不進版控,來源改記在 reference/README.md
    先前說「原始 PDF 已入庫」不精確 —— .gitignore 有 *.pdf,
    docs/reference/README.md 早就定了「大型 PDF 不進版控,記來源」的政策。
    補上 ADV7511 的來源條目與章節速查,並註明 ADI 封鎖自動下載、必須手動按下載鈕。
    數字摘要 ADV7511KSTZ_extracted.md 有進版控,換機器不會卡住。
2026-09-20 階段 1 開工:T113-S3 符號完成,抓到四處非連號
    資料來源:DS Figure 7-1 Pin Map (p.77)
    ⚠ 標籤是向量圖不是文字,整頁只抽得到 41 個字
    分四邊裁切 900dpi render 逐腳目視抄(旋轉 90° 的頂/底排 300dpi 看不清)
    ★ 四處非連號 —— 假設連號就會接錯
    1. PD12/PD13 對調:pin 69=PD13, pin 70=PD12
    最危險 —— 是 RGB 的 R0/R1,接反紅色少兩 bit 且錯位,原理圖上看不出來
    2. PG 頂排亂序:118=PG1 119=PG2 120=PG0 122=PG5 123=PG4
    3. PE 底排亂序:整段遞減但 PE0/PE1 被放到最後(44/45)
    4. USB0 與 USB1 的 DP/DM 順序相反(112=USB1-DP / 114=USB0-DM)
    原本完全不會想到要檢查,照「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
    [T113-S3_pinmap.csv]
2026-09-20 電源樹定案:分壓值、時序電路、RESET supervisor
    新增 011-power-tree.md —— 把 001 的分析收斂成可直接畫原理圖的數字。
    RY1303 datasheet 已取得(12 頁)
    Vin 2.7~5.5V · 每通道 2A · FB 0.600V ±2.5% · 1.2MHz · 軟啟動 1ms
    EN 上升閾值 1.2V min · UVLO 2.5~2.6V · QFN20-3x3 + EP
    ⚠ 三通道總功率須 < 6W —— 本板估 4.06W,餘裕 32%(兩項是估值)
    ⚠ 更正 001-power.md 的錯誤
    原寫 RY1303「EN1/EN2/EN3 內建順序」—— 錯的
    datasheet 是 "independent enable control ... greatest flexibility"
    三支 EN 是獨立輸入,沒有排序功能。零件的彈性不等於零件幫你做事
    分壓值(公式算,非抄):R_b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
2026-09-20 建立 KiCad 專案與原理圖自動檢查器
    協作方式定案:Nick 畫、Claude 檢查。
    眼睛看 128 隻腳靠不住,所以檢查是自動的。
    check_schematic.py
    用 kicad-cli 匯出 netlist,讓 KiCad 自己做 net 解析
    —— 不碰 wire/junction/label 的幾何,那是最容易判斷錯的部分
    再對 netlist 套規則,每條警告都附設計文件出處
    rules_t113.py 目前的規則
    T113 電源腳接的軌是否正確 / 有無浮接
    LDOA-OUT / LDOB-OUT / VRA1 / VRA2 是否誤接電源軌(會變兩顆穩壓器並聯)
    ADV7511 三組 1.8V 分組、11 支 GND、未用 D 腳接 GND
    RGB 接線:T113 的 LCD0-D 與 ADV7511 的 D 是否同一條 net
    必備離散元件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
    [T113-DEV-V1.kicad_sch]
2026-09-20 devlog:補記電源樹與檢查器,並寫下明天的起點
2026-09-21 新增 STATUS.md:單頁狀態快照
    19 個 commit、11 份文件、6,779 行之後,「現在到哪」已經無法從既有文件看出來。
    這份只回答三個問題:現在在哪、什麼已定案不會再動、下一步做什麼。
    附文件地圖,讓細節可以「需要時再翻」而不是「全部都要記住」。
    協作方式同步調整:一次只做一件事、決策由使用者選、對話砍短、細節進文件。
    Claude-Session: https://claude.ai/code/session_01HtGUWSQFey6W2g2grqgTMR
2026-09-21 腳位表合併成單一來源
    原本兩份表記同一件事:
    tools/t113s3_pins.csv 機器從 Table 4-2 抽,有電氣欄位
    hardware/data/T113-S3_pinmap.csv 人工整理,有 bank / KiCad 電氣型別 / EPAD
    合併後只剩後者,欄位取聯集:
    pin, name, bank, type, note, ds_type, reset, pull, drive_mA, supply, ds_group
    設計成最小破壞 —— 保留 type 欄位名給 KiCad 用,datasheet 的型別改叫 ds_type,
    所以 gen_t113_symbol.py 的讀取邏輯不用動。
    驗證:重跑符號生成,輸出與合併前位元組層級一致(僅 CRLF/LF 差異)。
    gen_t113_symbol.py 的交叉檢查改成自身完整性檢查:
    腳號 1~129 連號、KiCad 必要欄位非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
    [T113-S3_pinmap.csv, t113s3_pins.csv]
2026-09-21 新增 docs/concepts/:核心概念 ①回流路徑 ②阻抗控制
    6,000 多行設計文件裡,真正要內化的只有 8 條概念,其餘是查證結果
    (「PC4/PC5 是 BOOT-SEL」這類),不用記,畫到那裡再翻。
    這個目錄裝要帶走的那 8 條。
    ① 回流路徑
    每條訊號線正下方都要有連續的銅讓電流回家。
    高頻回流走電感最低的路(正下方),不是電阻最低的路。
    這一條解釋了五個既有規則:不可跨分割、L2 完整、高速不走 L4、
    換層加 GND via、變壓器下方挖空(反向應用)。
    另澄清「鋪銅」與「參考平面」的差別 —— L2 本來就是整片,
    要做的是不要破壞它,而破壞方式 D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
2026-09-21 概念 ② 標記為學習中,補導讀
    02-impedance.md 開頭加「只要抓住這三點」的導讀,
    其餘段落都是這三點的衍生:
    ① 高頻時銅線是傳輸線不是導線
    ② 阻抗是訊號前進感受到的阻力,不是電阻,由幾何決定
    ③ 阻抗突變處會反射
    另補「最容易卡住的地方」——「為什麼銅線有阻抗而且不是電阻」,
    用水管類比:粗細=阻抗、內壁摩擦=電阻,粗細改變處的水錘與管子好不好流無關。
    超導體沒有電阻但一樣有特性阻抗,兩者是不同的東西。
    README 進度表:① 已懂、② 學習中。
    Claude-Session: https://claude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
2026-09-21 腳位表合併成單一來源:回 PDF 重抽對帳,零差異
    昨天留下的「兩份腳位表暫時共存」收掉了。合併方式不是把兩份湊起來,
    而是回 datasheet 重抽 Table 4-2,再與兩份舊表三方對帳 —— 128 腳 × 7 欄,
    差異 0 格。
    單一來源 hardware/data/T113-S3_pinmap.csv,129 列,11 欄,分兩種:
    datasheet 欄位 name/ds_type/reset/pull/drive_mA/supply/group 機器抽,可重抽
    設計欄位 bank/type/note 人工判斷
    分清楚這兩種是關鍵 —— 混在一起的話重抽會蓋掉人工判斷,於是沒人敢重抽,
    那份表就退化成手動維護。extract_pins.py --write 只覆寫 datasheet 欄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
    [T113-S3_pinmap.csv, t113s3_pins.csv]
2026-09-23 概念 ②③ 完成:阻抗控制、臨界長度與等長
    ② 阻抗控制(補完並標記已懂)
    新增「驅動端視角」的解釋,比 √(L/C) 好懂:
    訊號出發瞬間,驅動端還不知道另一端接什麼(資訊沒傳回來),
    它憑線本身的特性決定輸出 I=V/Z₀ —— 這就是特性阻抗的物理意義。
    胃口來自「每前進 1mm 要充多少電荷」,所以幾何決定阻抗。
    補四個漏掉的點:
    ① 能調的只有線寬(+間距);「板厚 1.6mm」與阻抗無關,
    關鍵是 L1→L2 的 0.2104mm
    ② 差分阻抗 ≠ 2×單端 —— 兩線間的耦合會拉低,所以板廠給線寬+間距兩個值
    ③ 換層 = 換阻抗,而且回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
2026-09-23 概念 ④ 差分訊號:機制是共模抑制,目的是小擺幅
    最容易搞混的是因果順序 —— 那是一條鏈不是兩個並列特性:
    兩條靠近 → 受相同干擾 → 只看差值 → 共模抵銷 → 得到抗雜訊能力
    → ★ 這能力被拿去換「更小的擺幅」 → 小擺幅才跑得到 Gbps
    抗干擾不是拿來「更安全」,是拿來「換速度」。
    只要抗干擾的話單端加濾波屏蔽也行;差分不可取代的是它讓 200mV 擺幅可行
    (單端 CMOS 3.3V vs MIPI HS 200mV,小 16 倍)。
    共模抑制的前提是「兩條受到相同干擾」,所有差分 layout 規則
    (緊耦合/等長/同層/對稱/中間不插元件)都在維護這個前提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
2026-09-23 概念 ⑤ mux 衝突與 0Ω 隔離
    datasheet Features 頁的「6 個 UART / 3 個 SMHC / 4 個 TWI」
    是 mux 選項總數,不是同時可用數 —— 要查 Table 4-3 不是 Features 頁。
    核心:軟體切 mux 切不掉電氣負載。
    問題的本質不是「電還是會送過去」(ADV7511 輸入是高阻抗不吃電流),
    而是「線還連著」:那段岔路是 stub、末端的輸入電容讓反射更嚴重。
    是訊號完整性問題不是漏電 —— 加緩衝器解決不了,只能物理斷開。
    MIPI 臨界長度 4mm,通往 ADV7511 的走線不管多短都超標。
    補充「為什麼不用 analog mux IC」:
    主動開關自帶 5~10pF 電容 + 導通電阻 + 延遲,
    在 1Gbps 上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
2026-09-24 概念 ⑥ bank 為什麼會連坐
    因果方向容易搞反:
    不是「先有 bank 分組所以一起壞」,
    是「die 上 IO cell 物理相鄰所以一起壞,工程師把這自然邊界命名為 bank」。
    bank 是物理事實不是軟體分類 —— 沒辦法用軟體規避,就像規避不了 stub。
    三種連坐機制:ESD 二極體燒穿拉垮 VCC、latch-up 熔掉一整段 IO ring、
    控制邏輯受損。第二種最惡性:寄生 SCR 形成自我維持通路,
    就算干擾消失還是繼續導通。
    關鍵盲點:高速介面的「資料線」不在 bank(專用 PHY pad),
    但「控制線」都在(HPD/DDC/RESET/VBUS EN)。
    所以一個 bank 死掉會讓資料通道完好的介面全部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
2026-09-24 概念 ⑦ 上電時序
    兩個原因:
    ① IO 腳的寄生二極體倒灌 —— 與概念 ⑥ 同一個二極體,
    但問題出在「電源還沒到」而非「外部電壓太高」
    ② core 未穩時 IO buffer 輸出隨機 —— 保護的不只是晶片,
    也保護外部元件不要收到垃圾指令
    ★ 後果分兩層,輕的那層更常見也更難查:
    輕 電流給 VCC 軌偷偷充電 → 爬到 2.6V 這種不上不下的值
    → 晶片非法狀態 → 量電壓「有電」、量晶片沒燒,但就是不開機
    重 二極體燒毀或 latch-up
    若以為「時序錯 = 燒掉」,開不了機時就不會往時序想。
    bring-up 對應動作:四通道示波器抓上電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
2026-09-24 概念 ⑧ 去耦電容;八條核心概念全部完成
    ⑧ 去耦電容
    晶片瞬間尖峰是奈秒級,DC-DC 反應是微秒級,慢三個數量級。
    電容不是「濾波」是「代墊」—— 墊付尖峰電荷,之後跟 DC-DC 報帳。
    ★ 位置比容值重要:10mm 走線約 10nH,
    在 1A/1ns 的變化下產生 10V 壓降 —— 電荷被困在電感後面出不來。
    一顆放對位置的 0.1µF 勝過放遠的 10µF。
    ★ 與概念 ① 的連結:去耦也是一個電流迴路,回流路徑一樣要短。
    本專案特殊狀況 —— T113 的 21 支電源回流全走 EPAD,
    所以 EPAD 的 thermal via 從「散熱問題」升級成「電源完整性問題」。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
2026-09-27 電源頁開畫前查證完成:AVCC/HPVCC 改由內建 LDOA 供電
    - 011 §8 五項查證清完(RY1303 EN、電感、AP2112K 電容、核心功耗)
    - AVCC 要求 ±1%,外部 LDO 做不到 → LDOA 獨立帶 +1V8_AUDIO
    - 檢查器同步:AVCC/HPVCC/LDOA-OUT → +1V8_AUDIO
2026-09-28 電源頁開畫:RY1303 輸入側、EN1 延遲 RC 完成
    - 根圖紙掛上階層式子頁 power.kicad_sch(p.2 電源)
    - 電源頁小顆 IC 符號由 gen_power_symbols.py 生成(RY1303 / APX803 / TPS2051B)
    - RY1303:VIN1~3、EN2/EN3 → +5V_VBUS,各 VIN 10uF 並聯到地;8 支地腳含 EP → GND
    - EN1:47K 上拉 +3V3 + 220nF 到地(T1 ≈ 4.67 ms)
    - 下一步:三路輸出(SW → L → C_out,FB 分壓),先做 CH3 +3V3
    - ROADMAP 補第 4 塊 RK3568;reference 補 APX803 / TPS2051B 資料來源
    - .gitignore 排除 KiCad 10 的 .history/
    [T113-DEV-V1.kicad_sch, power.kicad_sch]
2026-09-29 011 §8 補三條待辦;STATUS 同步到電源頁;清掉 merge_pinmap.py
    新增待辦
    ★ 電感 footprint 對帳 —— 現用 KiCad 內建 L_Changjiang_FNR4020S,
    但 BOM 是 FHD4020S(同廠不同系列)。外形同為 4x4x2.0 但焊盤未必相同,
    要開 .kicad_mod 對 datasheet 推薦焊盤圖,不合則自建。
    與 T113 EPAD 同一套流程:標準件先找,對不上才自建。
    power.kicad_sch 還有一顆 power:+3.3V 未統一成 +3V3 —— 漏一顆最危險,
    ERC 只會提示「net 只有一個連接點」,容易被當雜訊忽略。
    被動件 footprint 統一 0603(006-assembly.md 的手焊決定)。
    STATUS.md
    下一步從「周邊元件符號」更新為「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
    [power.kicad_sch]
2026-09-29 電源頁三路 buck 完成;新增 netlist 自動驗證腳本
    三路全部通過驗證,算出的電壓與 011 §2.3 完全吻合:
    CH1 +0V9 25.5K/51.0K → 0.900 V C7 EN1←RC
    CH2 +1V5 76.8K/51.0K → 1.504 V C8 EN2←+5V_VBUS
    CH3 +3V3 232K/51.0K → 3.329 V C5,C6 EN3←+5V_VBUS
    ★ 這次踩的錯值得記:複製 +3V3 那路去做 +0V9 時,
    電源符號改了、阻值改了,但 FB 那條線還連在 U1.3(FB2) 沒改成 U1.14(FB1)。
    結果是功率從 SW1 出去、回授卻送進 CH2 —— 兩路一起失控。
    而這在原理圖上看起來完全正常,FB1/FB2/FB3 在符號上長得一模一樣。
    看得出來的錯:元件放錯、值填錯、線沒連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
    [power.kicad_sch]
2026-09-29 電源頁兩顆 1.8V LDO 完成;驗證腳本加 LDO 與 footprint 檢查
    U2 AP2112K-1.8 +3V3 → +1V8_SOC Cin C9 / Cout C10
    U3 AP2112K-1.8 +3V3 → +1V8_HDMI Cin C11 / Cout C12
    EN 接 VIN(內建 3 MΩ 下拉,浮接 = 關機),照 011 §3。
    check_power_rails.py 新增:
    - LDO 四支腳的 net、輸出 1µF、兩條 1.8V 軌不可相同
    - 被動件 footprint 必須來自 Capacitor_SMD / Resistor_SMD / Inductor_SMD
    (電感誤選 PQFP-160、電容誤選 SOIC-8,都是複製元件時帶過去的)
    - buck 輸出電容只數 22µF,避免 LDO 的 1µF 混算讓 +3V3 誤判通過
    新檢查以改壞 netlist 驗過會觸發(EN 拔掉、C9 footprint 換 SOIC-8)。
    順帶修掉:C5~C12 footp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
    [power.kicad_sch]
2026-09-30 電源頁:兩顆 1.8V LDO 完成
    U2/U3 皆用 KiCad 內建 Regulator_Linear:AP2112K-1.8,不必自建符號。
    U2 VIN→+3V3 EN→+3V3 VOUT→+1V8_SOC Cin=C9 Cout=C11
    U3 VIN→+3V3 EN→+3V3 VOUT→+1V8_HDMI Cin=C10 Cout=C12
    兩顆同料號(011 §3),ADV7511 依 ADI §6.8 需專屬 LDO。
    ★ U3 一開始整顆接錯,其中兩項會燒件:
    VIN→GND(無輸入)、EN→GND(關閉)、VOUT→+1V8_SOC(接到 U2 的輸出)、C10 兩腳短路。
    第三項最危險:LDO 內部 VOUT→VIN 有寄生二極體(同概念 ⑦ 的 IO 箝位二極體),
    U2 的 1.8V 從 U3 的 VOUT 灌入而其 VIN=0V → 反向偏壓,
    U3 可能燒毀且會拉垮 U2 輸出。
    ★ 模式:「複製後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
    [power.kicad_sch]
2026-09-30 RY1303 對 V1.9 原文重核:pin 16 是 VCC 不是 NC,另四處數字更正
    ★ 最嚴重的一項:pin 16 是 VCC 不是 NC
    DS V1.9 p.2:"Input supply pin for internal control circuit." 2.5~5.5V
    p.3 Absolute Max 也把 V_VCC 與三個 V_VIN 並列為輸入電源。
    原本符號標成 NC/no_connect、原理圖上懸空 ——
    控制電路沒電就整顆 IC 不工作,這是會讓板子完全不動的錯。
    gen_power_symbols.py 已改為 VCC/power_in 並重生符號。
    其餘四處與 V1.9 不符(原註來源是 V1.0.x,版本間數字有差):
    切換頻率 「1.2 MHz 固定」→ min 1 / typ 1.5 / max 2 MHz
    f 在分母,漣波最壞情況要取 min:
    ΔI 0.4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
2026-09-30 修正:pin 16 改回符號上方原位,避免破壞已畫好的連線
    前一個 commit 把 pin 16 從上方(T,0) 移到左側(L,9),
    看起來只是排版,實際上讓左側由 8 列變 10 列 →
    build() 依 rows 算 y0 → 所有左右側腳位 Y 座標整體位移 →
    執行「從庫更新符號」後 U1 的 21 支腳有 16 支掉線,
    而且 pin 9 (EN1) 位移後誤連到 +5V_VBUS(比掉線更危險)。
    改回 (T,0) 並驗證幾何未變:
    pin 16: NC/no_connect at(0,17.78) → VCC/power_in at(0,17.78)
    座標位移的腳:無
    原理圖已用 git checkout 2e4e3cb -- hardware/power.kicad_sch 還原,
    21 支腳全部救回,三路 buck 與兩顆 LDO 驗證通過。
    (f273b79 只動文件與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
    [gen_power_symbols.py]
2026-09-30 RY1303 完成:VCC 接上 +5V_VBUS,21 腳全數接好
    繞過「從庫更新符號」的做法:
    該動作的 Reset Fields 勾選項會把圖上 22 個被動件的 Value
    覆寫成庫預設值 C / R / L(接線完好但值全失)。
    改為直接修改 .kicad_sch 內 lib_symbols 快取中 RY1303 的 pin 16
    (no_connect/NC → power_in/VCC),KiCad 開檔即用這份快取,
    完全不需執行那個會清值的更新動作。
    值損壞先以 git checkout 364ab9a -- hardware/power.kicad_sch 還原
    (22 個值全部回來),再套用快取修改。
    驗證:
    U1 21 支腳全部接好,pin 16 → +5V_VBUS
    C13 0.1uF 去耦 +5V_VBUS/GND
    22 個元件值全部保留
    三路 buck 回歸通過、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
    [power.kicad_sch]
2026-09-30 電源頁:RESET supervisor 完成;定下訊號 net 命名規則
    U4 APX803-29SAG-7 VCC→+3V3 GND→GND RESET#→SYS_RESET_N
    R8 10K SYS_RESET_N → +1V8_SOC
    ★ 上拉軌是這段最容易錯的:T113 的 RESET 是 1.8V 域輸入,
    而 APX803 是 open-drain —— 只負責拉低,高電位由上拉那端決定,
    所以 VCC 吃 3.3V、輸出擺到 1.8V 是正常且必要的。
    第一次用全域標籤(SYS_RESET_N,電源頁 → 主晶片頁 T113 pin27)。
    電源符號有 ERC 驅動源檢查,全域標籤沒有 —— 用途不同。
    ★ 訊號 net 命名規則(因應已踩過兩次的命名坑):
    低有效用 _N 結尾,不用 ~{NAME} 或 NAME#(匯出時特殊字元易出事)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
    [power.kicad_sch]
2026-09-30 新增 012-schematic-conventions.md:原理圖規範集中一份
    規則原本散在 011 §1.1、devlog 與對話裡,畫其他頁時難查。集中內容:
    §1 Net 命名 —— 電源軌清單、訊號規則(低有效用 _N、全大寫、底線分隔、
    不用 ~{} 或 #)、以及已踩過的三次命名坑
    §2 用哪一種標籤 —— 電源符號 vs 區域/全域/階層標籤,
    附「電源一律用電源符號」的理由(ERC 會檢查驅動源)
    §3 元件欄位 —— Value/Footprint/LCSC 必填,容差不寫進 Value
    (JLCPCB 下單看 LCSC 料號),及各類 Value 寫法
    §4 被動件 —— 0603 統一、容差全用 1%
    (0603 的 1% 與 5% 幾乎同價,統一可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
2026-09-30 ★ 電源頁完成:TPS2051B USB-A 限流接完
    U5 TPS2051BDBVR
    pin5 IN ← +5V_VBUS pin1 OUT → +5V_USB
    pin4 EN ← USB_EN(全域標籤,高有效)
    pin3 OC# → USB_OC_N + R9 10K 上拉到 +3V3(open-drain)
    pin2 GND ← GND
    C14 220uF SMD 電解 + C15 0.1uF 掛在 +5V_USB
    過程中踩到第四次命名坑:pin5 一開始接到自建的「+5V」
    (只有 1 個連接點的孤立 net),而圖上其他地方是「+5V_VBUS」——
    電氣意圖正確但名字不同 = 沒真的連上。已修正。
    C14 選 220uF 的依據(011 §6.3 補完整):
    USB 2.0 §7.2.4.1 要求 downstream port bulk ≥120uF
    (最壞情況:滿載 500mA 裝置突然插入時要撐住 VBUS)
    220uF 是最接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
    [power.kicad_sch]
2026-09-30 電源頁:補齊 32 個元件的 Footprint 欄位
    批次修正,其中 7 個原本是錯的封裝:
    C5/C6/C7/C8 Package_SO:SOIC-8 → Capacitor_SMD:C_0603
    C9/C10 SOT-23-5 → Capacitor_SMD:C_0603
    R9 SOT-23 → Resistor_SMD:R_0603
    另 16 個原本是空的,一併填上。
    依 012 §4.1 全部統一 0603,唯一例外 C14 220uF 用 SMD 電解
    (Capacitor_SMD:CP_Elec_6.3x7.7,暫定,選定實際料號後要對尺寸)。
    U1 RY1303 刻意留空 —— datasheet 的封裝圖是圖片,pitch/EP 尺寸未核對。
    KiCad 候選 QFN-20-1EP_3x3mm_P0.4mm_EP1.65x1.65mm,
    但 pitch 是 0.4 還是 0.45、EP 實際尺寸都要對原文核。已列入 0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
    [power.kicad_sch]
2026-09-30 修正 C5~C8 的封裝為 0805;012 補記兩個 0603 例外
    C5/C6/C7/C8 是 RY1303 三路 buck 的 22uF 輸出電容,
    011 §2.4 定的料號 C45783 是 0805 X5R —— 前一個 commit 批次填成 0603 是錯的。
    22uF 在 0603 的 DC bias 衰減太嚴重(概念 ⑧),所以當初才選 0805。
    012 §4.1.1 從「唯一的例外」改成「兩個例外」:
    ① C5~C8 22uF 用 0805(DC bias)
    ② C14 220uF SMD 電解(USB 2.0 規範的 120uF bulk 要求)
    並附電源頁完成時的封裝分布,方便日後核對。
    驗證:三路 buck 回歸通過,接線與值未受影響。
    Claude-Session: https://claude.ai/code/session_01HtGUWSQFey6W2g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
    [power.kicad_sch]
2026-10-01 主晶片頁開工:unit 1(26 支電源腳)完成
    建立 mcu.kicad_sch 並掛進階層,U6 = T113-S3。
    供電骨架:
    +0V9 VDD-CORE0/1、VDD-SYS0/1/2
    +1V5 VCC-DRAM0/1
    +3V3 VCC-IO/PD/PE/PG/TVOUT、LDO-IN
    +1V8_SOC VCC-PLL/RTC/LVDS、VDD18-DRAM、VCC-TVIN
    +1V8_AUDIO LDOA-OUT、AVCC、HPVCC
    GND AGND、EPAD
    獨立 net LDOB-OUT(C17 2.2uF)、VRA1(C18 0.1uF)、VRA2(C19 0.1uF)
    ★ 三個「輸出型」腳位不可接電源軌:
    LDOA-OUT 內建 LDO 輸出 → 只接 +1V8_AUDIO
    LDOB-OUT 不使用 → 只掛電容到地
    VRA1/VRA2 Internal Reference Voltage,Type = AO → 只掛電容到地
    接到軌上就是兩個源打架(同電源頁踩過的 U3 VO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
    [T113-DEV-V1.kicad_sch, mcu.kicad_sch]
2026-10-01 主晶片頁 C17~C19 footprint 由 DIP-24 改為 C_0603_1608Metric
    複製元件時帶過去的錯誤封裝,check_power_rails.py 的 footprint 檢查抓到。
    0.1uF ×2、2.2uF ×1 皆照 012 §4.1 用 0603。
    [mcu.kicad_sch]
2026-10-02 unit 2 的 12 腳接上全域標籤;修回被 KiCad 覆蓋的 footprint
    unit 2（PB/PC/PF）先接 microSD 與 SPI NOR 這 12 腳:
    PF0~PF5 → SDC0_D1/D0/CLK/CMD/D3/D2
    PC2~PC7 → SPI0_CLK/CS0/MOSI/MISO/WP/HOLD
    SDC0 的資料線編號不順(PF0=D1、PF1=D0、PF4=D3、PF5=D2),照 DS 抄,已核對無誤。
    PF6 與 PB2~PB7 本輪不接。
    ★ C17~C19 的 footprint 被 KiCad 洗回 DIP-24:
    2413442 已經改成 C_0603 並 commit,但 KiCad 還開著舊的記憶體狀態,
    畫完 unit 2 存檔時整頁寫回去,把修正覆蓋掉。
    危險在於 git 只顯示「檔案被修改」,看不出是哪些修正被洗掉。
    → 012 新增 §6.2:git pull 之後、或任何人在檔案層改過 .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
    [mcu.kicad_sch]
2026-10-02 ★ unit 2 完成(19/19):PB2~PB7 與 PF6 改為測試點
    去處:
    SDC0 → microSD PF0~PF5 全域標籤
    SPI0 → SPI NOR PC2~PC7 全域標籤
    測試點 PB2~PB7 TP1~TP6
    PF6 TP7
    皆用 TestPoint:TestPoint_Pad_D1.5mm,BOM 成本 $0(只是裸銅焊盤)
    ★ 推翻 007 §6.3 原本的「PB2~PB7 = I2S2 音訊 codec」規劃:
    查 Table 4-3 發現 I2S2 的 mux 有兩組(PB2~PB7 與 PF0/1/3/5/6),
    PF 那組已給 SDC0;但本板音訊是 T113 內建 codec(unit 6 的 AVCC/HPVCC/HPOUTL-R),
    根本不需要外接 I2S codec → 這 6 腳沒有用途。
    不拉排針的理由是 §4 規則①:PB 在 VCC-IO bank,
    那條軌掛著 microSD + SPI NOR +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
    [mcu.kicad_sch]
2026-10-02 ★ unit 3 完成(23/23):MIPI 直通 + 0Ω 分支到 RGB
    PD0~PD9 一分為二:MIPI 標籤直通、再經 R10~R19(0R) 分支到 RGB 標籤
    PD10~PD21 直接接 LCD0_D14/D15/D18~D23/CLK/DE/HSYNC/VSYNC
    PD22 測試點 TP8
    0Ω 不在 MIPI 路徑上而在分支上,所以不違反「MIPI 不能加串聯電阻」。
    跑 MIPI 時 0Ω 不焊,ADV7511 完全脫離主幹(概念 ⑤)。
    三個照 DS 抄、不能推的地方(已逐行對 Table 4-3 核):
    LCD0-D 跳號① PD5=D7 → PD6=D10
    LCD0-D 跳號② PD11=D15 → PD12=D18(D16/D17 在 PB6/PB7,已放棄 → RGB666 的由來)
    pin 號順序反 PD12=pin70、PD13=pin69
    這種地方推錯了 netlist 也看不出來 —— 名字都是合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
    [mcu.kicad_sch]
2026-10-05 ★ unit 4 完成(14/14):PE bank 網路;三處與原規劃不同
    PE0~PE9 RMII 十條訊號(CRS_DV/RXD0/RXD1/REF_CLK/TXD0/TXD1/TX_EN/RXER/MDC/MDIO)
    PE10 測試點 TP9
    PE11 PHY_RESET_N
    PE12/13 測試點 TP10/TP11
    三處更正(對 DS Table 4-3 逐行核):
    ① PE7 存在且是 RMII-RXER —— 原規劃漏了這支,是 RMII 標準訊號之一
    ② PE10 的 mux 沒有 PHY RESET
    實際是 NCSI0-D6|UART1-TX|PWM4|IR-RX|JTAG-DO|EPHY-25M
    007 原寫「EPHY-25M(或 PHY RESET)」是推測,datasheet 不支持
    → PHY_RESET_N 改放 PE11,PE10 改測試點(兩種時脈架構都保留彈性)
    ③ PE9 的標籤一度打成 RMII_MDI0(數字零)而非 RMII_MDIO(字母 O)
    第五次命名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
    [mcu.kicad_sch]
2026-10-06 ★ unit 5 完成(16/16):PG 排針,每支串限流電阻
    PG0~PG15 全部拉到排針,照 007 §4 規則②:
    I2C ×2 (PG7/PG8 TWI2、PG9/PG10 TWI1) 100R
    其餘 12 支 330R
    標籤用 HDR_ 前綴 —— layout 階段能一眼認出哪些 net 是對外的
    (要串電阻、要在 PG bank、要遠離高速差分)。
    ★ 踩到第六次命名坑,形狀跟前五次相反:
    前五次 名字寫錯 → 該連的沒連 → 留下孤立 net,檢查得到
    這次 PG0 與 PG1 都標成 HDR_GPIO2 → 不該連的連在一起
    兩支 GPIO 經各自的 330R 併在一起,軟體一高一低就有 5mA 穿流,
    而且少一個對外接點、GPIO4 憑空消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
    [mcu.kicad_sch]
2026-10-10 類比地單點接地;VRA 去耦改 0.47uF(對 MangoPi 確認)
    查 MangoPi MQ-R v1.6 原理圖 p.3,解開三個 datasheet 沒寫的問題:
    VRA1/VRA2 各 0.47uF 到 AGND(C40/C78)—— 原暫用 0.1uF 是無依據的猜測
    類比地 AGND 經 0R(R15)單點接 GND,不是直接合併
    未用類比腳 FMINL/FMINR 直接打 ✗(No Connect)—— 證明類比輸入可懸空
    本板對應的改動:
    C18/C19 0.1uF → 0.47uF,且下端從 GND 移到 AGND
    R36 0R 新增,AGND ←→ GND 單點連接
    EPAD 從 AGND 移出,直接接 GND
    ★ EPAD 那項是關鍵:它是全晶片唯一的數位地(21 支電源的回流都走它)。
    留在 AGND 上的話,所有數位電流都要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
    [mcu.kicad_sch]
2026-10-10 新增原理圖生成工具與 ADV7511 符號
    目標變更:改由我完成全部原理圖,使用者負責 layout。
    做法是寫生成器而非手改 .kicad_sch —— 與符號庫由 CSV 生成同一思路,
    可重現、可驗證,且避開手畫 100 多支腳的命名坑(已踩過六次)。
    新增 hardware/scripts/schlib.py
    KiCad 原理圖的共用積木:wire / junction / no_connect / global_label /
    symbol / power,以及 sheet_uuid_of、append_to_sheet。
    座標一律 snap 到 1.27mm 格點 —— 沒對齊格點是「看起來接了其實沒連」的主因。
    guard_kicad_closed() 偵測到 .lck 就 sys.exit,不是印警告
    (上一輪自己違反 012 §6.2 的教訓:警告訊息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
    [gen_adv7511_symbol.py, gen_mcu_unit67.py, schlib.py]
2026-10-10 新增 RTL8201F 符號(QFN-32,33 腳含 E-Pad)
    KiCad 內建沒有這顆(Interface_Ethernet 只有 DP838xx/KSZ80xx/ENC 系列)。
    腳位出自 Datasheet Rev1.4 §5.1 Figure 3 (p.5),依功能分 3 unit:
    A 電源與類比(13) B MII/RMII(15) C LED/strap(5)
    ⚠ 這份文件涵蓋三種封裝,查腳位極易拿錯 ——
    §5.1 RTL8201F QFN-32(本板)、§5.2 FL LQFP-48、§5.3 FN QFN-48
    與 008-footprint.md 記過的同一類陷阱(當時是拿錯封裝章節)。
    ⚠ 五支腳是上電 strap,原理圖要明確定義電平,不能當一般訊號接:
    LED0/PHYAD[0](24)、LED1/PHYAD[1](25) PHY 位址
    RXD[3]/CLK_CTL(12) ★ REF_CLK 方向
    RXD[2]/INTB(11)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
2026-10-10 新增顯示頁生成器與建立子圖紙工具
    new_sheet.py
    建立子圖紙並掛進根圖紙階層。KiCad 的階層由兩邊構成:
    子頁檔案自己的 uuid,以及根圖紙裡 (sheet) 區塊的 uuid ——
    後者決定子頁元件的 instances 路徑 /<根uuid>/<sheet uuid>,
    對不上的話 reference 會全部變 "?"。
    gen_display_sheet.py
    ADV7511 五個 unit 全部接線:
    電源 13 支依 011 §5 分三組 1.8V(DVDD/AVDD+PVDD/PLVDD+BGVDD)+ MVDD 3.3V
    11 支 GND
    視訊 RGB666 的 22 條照 002 的腳位級接線表(Figure 6 目視抄出)
    未用的 D0/D1/D8/D9/D16/D17 + D24~D35 共 18 支接 GND
    (它們是輸入腳 VIL -0.3~0.7V,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
2026-10-10 ★ REF_CLK 方向定案:PHY 提供;並抓到一顆漏了就完全不通的 strap
    對 RTL8201F Datasheet Rev1.4 Table 1/3/4 確認,解開 003 與 007 一直懸著的問題:
    RXD[3]/CLK_CTL (pin12) 內部已弱下拉 = REF_CLK output 模式(預設)
    → 懸空即可,不必外加元件
    → PHY 自帶 25MHz 晶振,內部倍頻後從 TXC (pin15) 輸出 50MHz 給 T113 PE3
    連帶確認:
    PE3 標成 RMII_REF_CLK 是對的(線上就是 50MHz 參考時脈,方向 PHY→SoC)
    PE10 (EPHY-25M) 確實用不到,接測試點的決定正確
    ★★ 抓到一顆絕對不能漏的 strap:RXDV (pin8) 的 4.7K 上拉
    "An internal weakly pulled low resistor sets this to the default of MII mode.
    It is po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
2026-10-10 網路頁生成器完成,並修掉階層 UUID 的潛在炸彈
    schlib
    - sheet_uuid_of() 改成從根圖紙查 /<根 uuid>/<sheet uuid>。
    原本從子頁自己的內容抓,但剛建立的空白子頁裡沒有這個資訊,
    會回傳 None -> 這頁所有元件的 reference 變成 "?"。
    順手加上「子頁既有元件的路徑與根圖紙不符就中止」。
    - power() 多一個 net 參數,讓符號長相與 net 名稱分開
    (機殼地要畫接地符號但 net 要叫 GND_CHASSIS)。
    - 新增 Page 類別:把五張子頁重複在做的「從腳位拉線接到
    標籤/電源/電阻」收成方法。偏移量算錯就是接不上,
    而這種錯在原理圖上看不出來。
    new_sheet.p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
2026-10-10 顯示頁與 HDMI 座頁生成器,並修掉三個會生出壞檔的問題
    顯示頁拆成兩張 (display / hdmi)
    - ADV7511 的 100 腳吃掉整張 A3,接頭硬塞進去會重疊。
    「塞得進去」比「分頁數少」重要:這張圖是佈線時唯一的依據。
    display.kicad_sch (38 顆元件 / 123 個接點)
    - 100 支腳全部有去處,生成前自我檢查。
    - RGB666:22 條訊號,其中與 MIPI 共用接腳的 10 條串 0Ω 隔離;
    D0/D1/D8/D9/D16/D17 與 D24~D35 共 18 支接 GND。
    - 三組 1.8V 各一組 10µH + 10µF (011 §5),13 支電源腳各一顆 0.1µF。
    - 七顆上下拉含 PD/AD 的 10K:它決定 I2C 位址與 PD 極性。
    - R_EXT 887Ω 1% 畫在腳位旁邊,不丟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
2026-10-10 畫完剩下的八張子圖紙,並解掉三個擱置的待確認項
    八張新頁的生成器(全部通過 dryrun_sheet 幾何與編號檢查)
    display ADV7511 本體,100 腳全有去處 38 顆元件
    hdmi HDMI Type-A 座 + 5V 保險絲 5 顆
    mipi 40-pin FPC(腳位暫定,圖上標明) 3 顆
    net RTL8201F + HR911105A + 晶振 26 顆
    usb Type-C x2 + CH340N + USB-A + 按鍵 20 顆
    storage microSD + SPI NOR + BOOT-SEL 16 顆
    header 2x13 排針 1 顆
    audio 3.5mm line-out 1 顆
    解掉的待確認項(全部寫進新的 013-schematic-decisions.md)
    ① BOOT-SEL 怎麼接(007 §5.3)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
2026-10-10 STATUS 更新:原理圖十張頁全部設計完成,卡在 KiCad 鎖檔
    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
2026-10-10 把八張子頁真的跑出來驗證,ERC 從 1309 清到 0
    KiCad 還開著不能寫檔,所以把 hardware/ 複製到暫存區,
    在副本上跑完整流程 -> 跑 kicad-cli ERC -> 修 -> 再跑,來回七輪。
    最終:ERC 0 errors 0 warnings、check_schematic 0/0、
    check_power_rails 全過。186 顆元件 · 253 條 net · 10 張圖紙。
    抓到的問題(全部是「圖看起來完全正常」的那一類)
    ★ lib_symbols 是空的 —— 1309 個違規裡的 1204 個
    (lib_symbols) 不是選配,它是 KiCad 判斷「腳在哪裡」的唯一依據。
    快取空的 -> 八張圖每一條線都是斷的,而打開看完全正常。
    新增 fill_lib_symbols.py(含符號繼承的攤平)。1309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
    [check_power_rails.py, fill_lib_symbols.py, gen_display_sheet.py, gen_hdmi_sheet.py, gen_header_sheet.py, gen_mcu_unit67.py, gen_mipi_sheet.py, gen_net_sheet.py]
2026-10-10 把圖輸出成 PDF 逐頁看,修掉排版 —— ERC 過了不等於圖能看
    ERC 歸零之後用 kicad-cli 把十一頁輸出成圖,一頁一頁檢查。
    接線 100% 正確,但排版很糟,而 ERC 對這一類問題完全沉默。
    根源是同一個:文字比符號寬得多
    腳距 2.54mm,但 "+1V8_DVDD" 約 20mm。
    十三支電源腳各放一個符號,文字疊成一團墨。
    圖上看不清楚等於沒畫 —— 佈線的人看的就是這張圖。
    三個改法
    ① Page.pin_bus:同一條軌走一條匯流排,只放一個電源符號,
    從匯流排最上面那一列往外拉。各組出口在不同 y,文字不會互蓋。
    ADV7511 unit 1 左側因此依「接哪一條軌」重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
2026-10-10 補齊最後兩顆 footprint,186 顆元件全部可以轉進 PCB
    這兩顆原本擋著「Update PCB from Schematic」—— 沒有 footprint 就匯不進去。
    T113-S3 eLQFP128(自建)
    gen_t113_footprint.py:拿內建的 LQFP-128_14x14mm_P0.4mm 當底,加上三樣:
    EPAD 5.72 x 5.72 置中 —— 這是這顆晶片唯一的數位地(128 腳裡只有 1 支 AGND)
    via 5x5 = 25 顆,間距 1.2mm,鑽孔 0.3mm
    錫膏 4x4 網格、覆蓋率 60%,刻意與 via 陣列錯開
    不從零畫:128 支腳算錯一支就整顆報廢,而內建那顆已經對過
    JEDEC MS-026 BEE 四項(008 §3.1)。自己重算只會多一次出錯機會。
    腳本產生前會擋「底稿 pad 數不是 128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
2026-10-10 重新稽核 netlist:補上 T113 漏掉的逐腳去耦,並把 designator 全部連號
    ERC 歸零、圖也看過之後,再做一次只看 netlist 的獨立稽核。
    ★ T113-S3 的 23 支電源腳,一顆本地電容都沒有
    +1V8_AUDIO 3 支腳 0 顆 —— 011 §6.1 白紙黑字寫「LDOA-OUT 2.2µF 到地」
    +0V9 5 支腳 只有 buck 端的 C7 22µF
    +1V5 2 支腳 只有 C8 22µF(DDR3)
    +1V8_SOC 5 支腳 只有 C11 1µF
    +3V3 6 支腳 有,但都在別顆 IC 旁邊
    對照之下 ADV7511 那頁(程式生成的)13 支電源腳各有一顆 0.1µF。
    整塊板最重要的晶片反而是去耦最差的 —— mcu 頁手畫時只拉訊號線。
    後果是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
2026-10-12 原理圖十一頁全部寫進專案,ERC 歸零
    關掉 KiCad 之後執行 run_all.py --apply,23 步全過。
    關閉前先確認過未存檔的修改是什麼:
    KiCad 標題有 * 標記,但比對 .history(KiCad 自己的 autosave repo)
    與 HEAD 的差異只有 10 行,而且全是視覺層面 ——
    一條裝飾用分隔線的端點差 0.76mm、一顆 GND 符號的文字標籤位置。
    沒有任何元件、接線、net 名稱、腳位的改變。
    而且 .history 那份(15:50 autosave)比 HEAD(15:51 commit)還舊,
    磁碟上的就是最新版。沒有東西遺失。
    寫進專案的內容
    新增 8 張子頁:display / hdmi / mipi / net / usb / storage / header / audio
    mcu 頁補 u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
2026-10-12 修 Y3 符號腳數與 TP9~TP11 的 footprint,並把「腳號 vs 焊盤號」固化成檢查
    ERC 完全不看原理圖與 footprint 的對應,所以這兩個錯全部過關:
    TP9/TP10/TP11 的 footprint 被設成繼電器(手畫時選錯)
    測試點只有 pad 1,繼電器的焊盤編號是 11/12/14/21/22/24/A1/A2
    Y3 用 4 腳的 Crystal_GND24 符號配 2 腳的 3215 封裝(我選錯)
    3215 實物就是 2 腳,改用 Device:Crystal;兩種符號的訊號接點都在 ∓3.81,座標不必動
    新增 check_footprints.py 並列入 run_all:
    驗每顆元件的腳號都能在 footprint 的焊盤編號裡找到。
    這是 Update PCB 的前提,而既有的三支檢查都看不到這一層 —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
2026-10-12 還原圖紙到生成前,準備用修好的腳本重跑
2026-10-12 wip: 還原圖紙,準備用改名後的腳本重跑
2026-10-12 還原,準備最終完整重跑
2026-10-12 佈線前置檢查:修掉三件會擋住或拖累佈線的事
    ERC 歸零不等於能開始佈線。再問一次「丟進 PCB 編輯器,佈線工具真的能用嗎」,
    答案是當時還不能。
    ★ ① ERC 完全不看「原理圖 ↔ footprint」的對應
    Y3 用 4 腳的 Crystal_GND24 符號配 2 腳的 3215 封裝
    兩個都通過 ERC、也通過「有沒有填 footprint」「檔案在不在」的檢查 ——
    原理圖上完全正常,只有把兩邊擺在一起比才看得出來。Update PCB 會直接卡住。
    新增 check_footprint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
2026-10-12 wip: new_sheet 避開既有方塊
2026-10-12 還原,最終重跑
2026-10-12 還原,最終完整重跑
2026-10-12 佈線前置總驗收通過;修掉根圖紙上四張子頁蓋住 Main Chip 的問題
    這一輪做了四項之前沒驗過的檢查,抓到一個排版問題。
    ★ 根圖紙上「Main Chip」被四張新子頁蓋住
    new_sheet.py 原本用「第 n 張放第 n 格」算位置,但電源與 Main Chip
    是手動放的,位置不在格線上,而且 Main Chip 比標準格子大(100x71mm)。
    結果 MIPI/網路/排針/音訊四張疊在它上面 —— 電氣沒影響,
    但根圖紙上點不到被蓋住的方塊,很難用。
    改成:讀出既有所有方塊的矩形,逐一試候選位置,挑第一個不重疊的。
    順手修掉 SLOTS 自己的 bug(236.22+88.9 > 320.04,第二三格會互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
2026-10-14 驗證自建 footprint 真的能被 KiCad 解析,並把這一關加進檢查
    eLQFP-128 那顆是用程式產生的(拿內建件當底、文字拼接加上 EPAD 與 via),
    在這之前沒有任何一個步驟真的讓 KiCad 解析過它 ——
    格式壞掉的話要到 Update PCB 才發現,而那時已經在佈線了。
    驗法:kicad-cli fp export svg
    ✓ 輸出 682 path + 825 circle
    渲染出來目視確認:128 腳圍四邊、中央 EPAD、5x5 thermal via、
    錫膏是分格網格(不是一整塊,一整塊會放太多錫讓晶片浮起)
    順手修:footprint 內部的 Value 文字還是底稿的 LQFP-128_14x14mm_P0.4mm。
    放到板上會被元件自己的 Value 蓋掉,不影響功能,
    但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
